utahrobotics/Electrical-2019-2020/Electrical layout/Teensy_4.0/Renders/Teensy_4.0_wBG.png

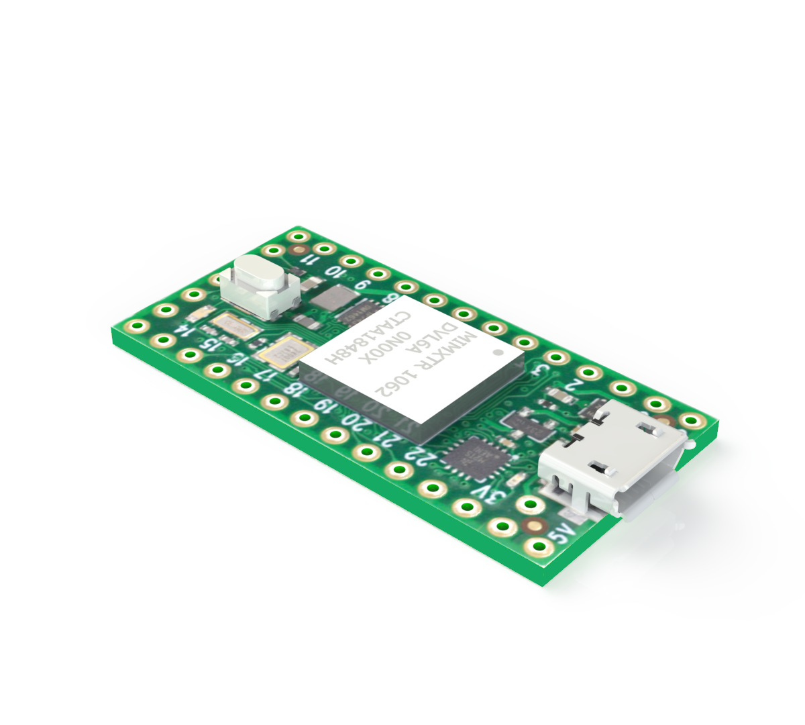
Electrical layout/Teensy_4.0/Renders/Teensy_4.0_wBG.png
