utahrobotics/Electrical-2019-2020/Electrical layout/Teensy_4.0/Teensy_4.0_Decal/Teensy_4.0_Back.png

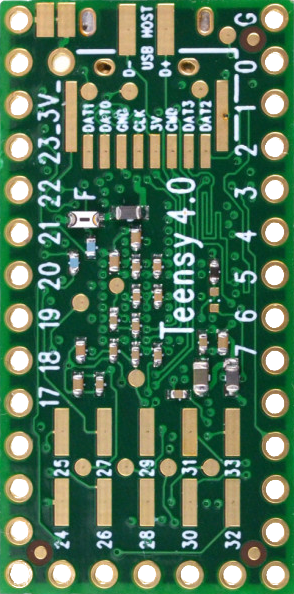
Electrical layout/Teensy_4.0/Teensy_4.0_Decal/Teensy_4.0_Back.png
