utahrobotics/Electrical-2019-2020/Electrical layout/PCBasembly.bmp

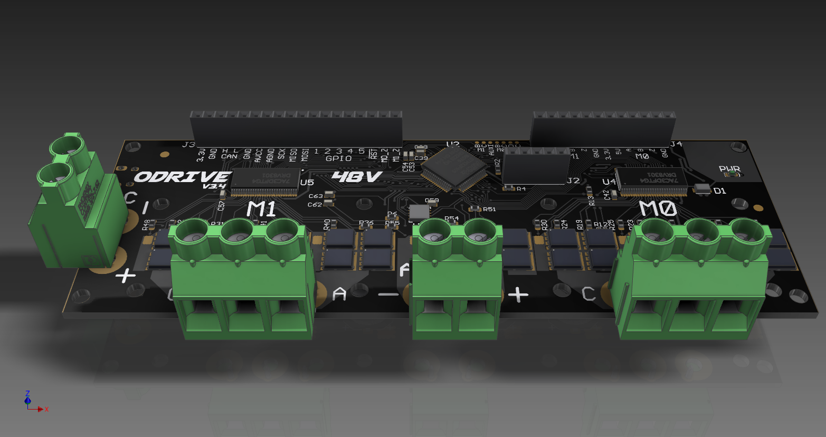
Electrical layout/PCBasembly.bmp
