utahrobotics/Electrical-2019-2020/Electrical layout/PCBasemblyB.bmp

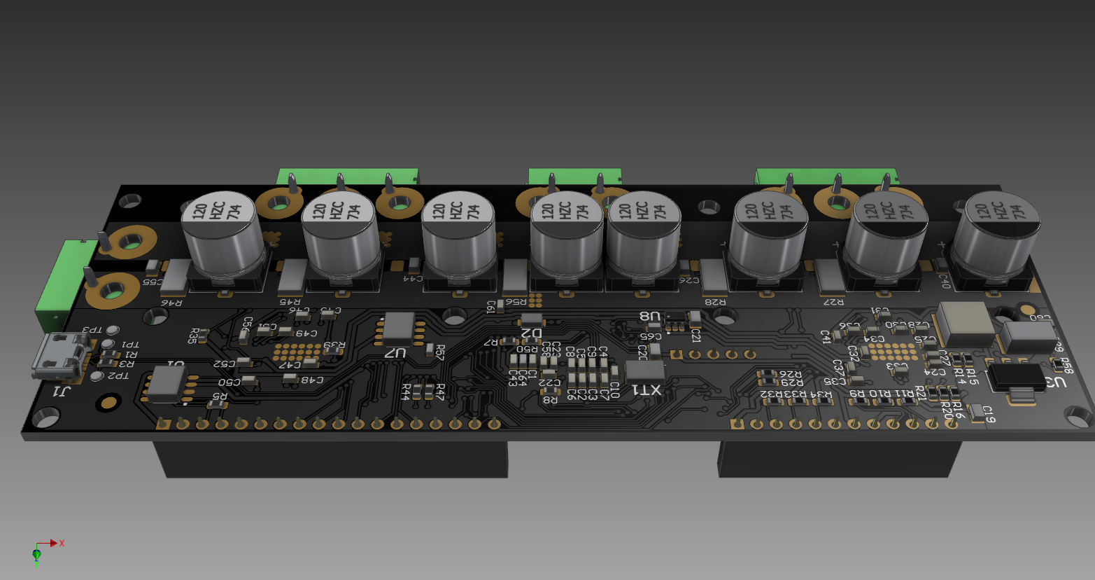
Electrical layout/PCBasemblyB.bmp
