utahrobotics/Electrical-2019-2020/Electrical layout/Teensy_4.0/Teensy_4.0_Decal/ARM_Coretex M7 Chip Decal.png

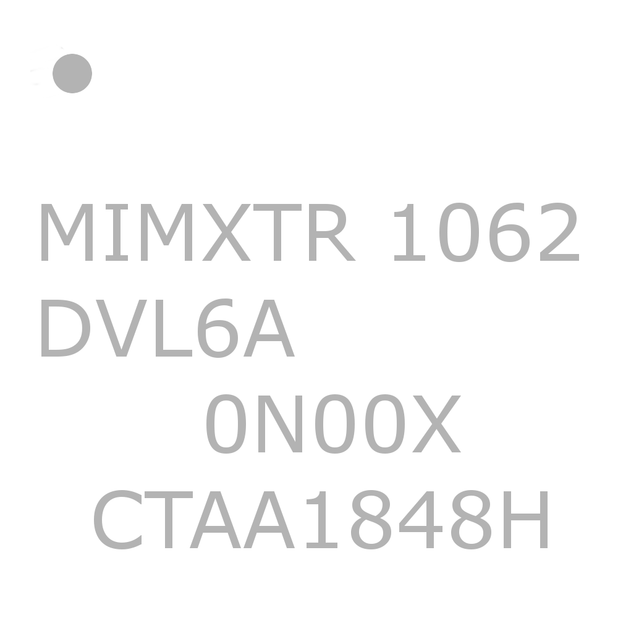
Electrical layout/Teensy_4.0/Teensy_4.0_Decal/ARM_Coretex M7 Chip Decal.png
