utahrobotics/Electrical-2019-2020/Electrical layout/Teensy_4.0/Teensy_4.0_Decal/teensy40-launch-frontandback-thumb.jpg

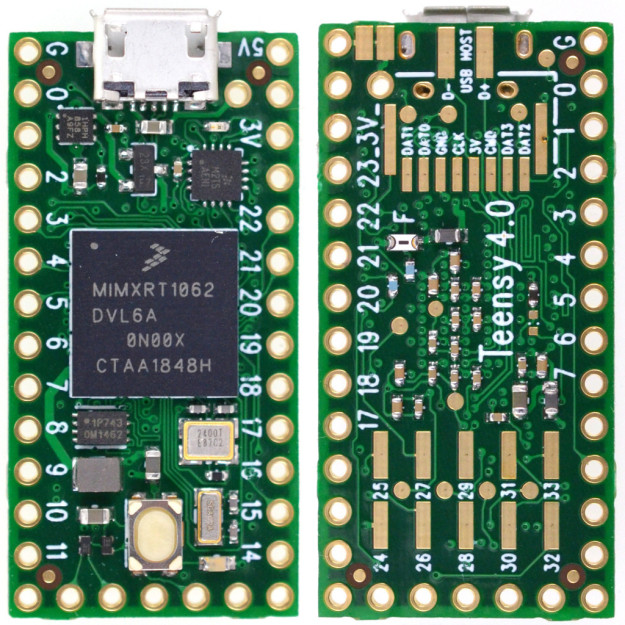
Electrical layout/Teensy_4.0/Teensy_4.0_Decal/teensy40-launch-frontandback-thumb.jpg
