utahrobotics/Electrical-2019-2020/Electrical layout/XT90 Connector/XT90 Connector v2.png

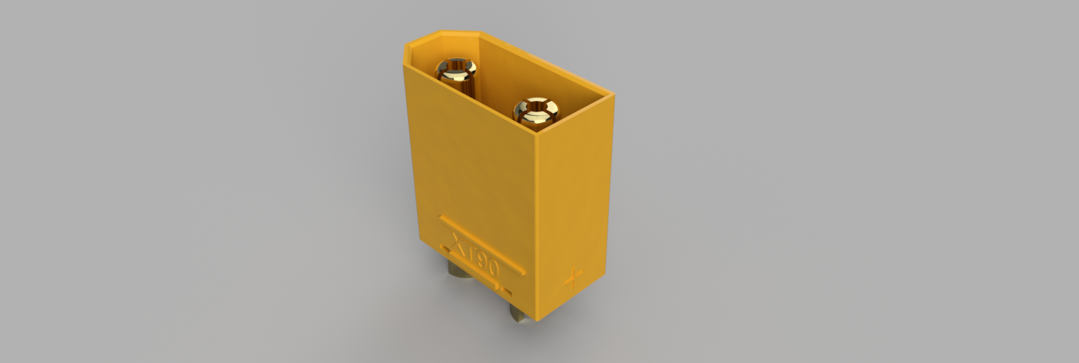
Electrical layout/XT90 Connector/XT90 Connector v2.png
