utahrobotics/Electrical-2019-2020/Electrical layout/XT90 Connector/XT90 Connector v5.png

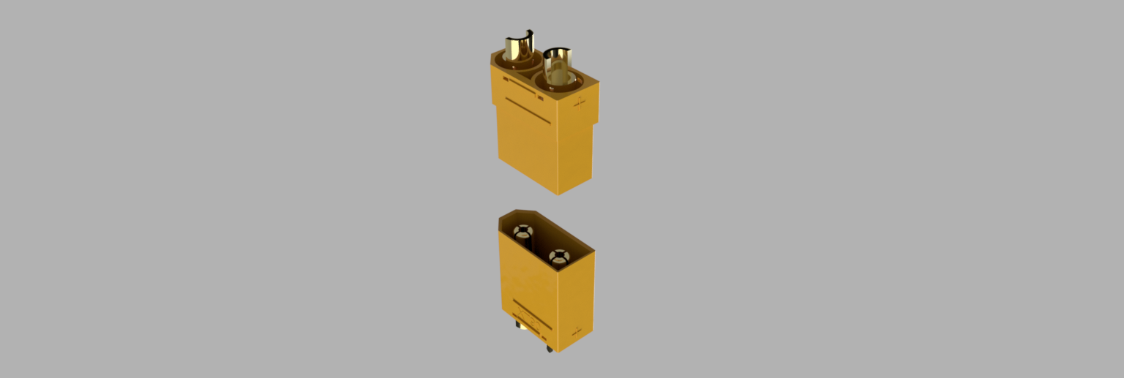
Electrical layout/XT90 Connector/XT90 Connector v5.png
