utahrobotics/Electrical-2019-2020/Electrical layout/xt90_female-2.jpg

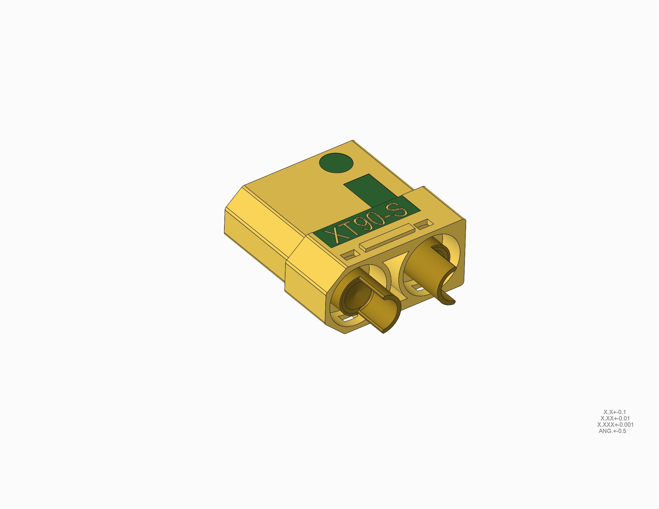
Electrical layout/xt90_female-2.jpg
