utahrobotics/Electrical-2019-2020/Master_capture.png

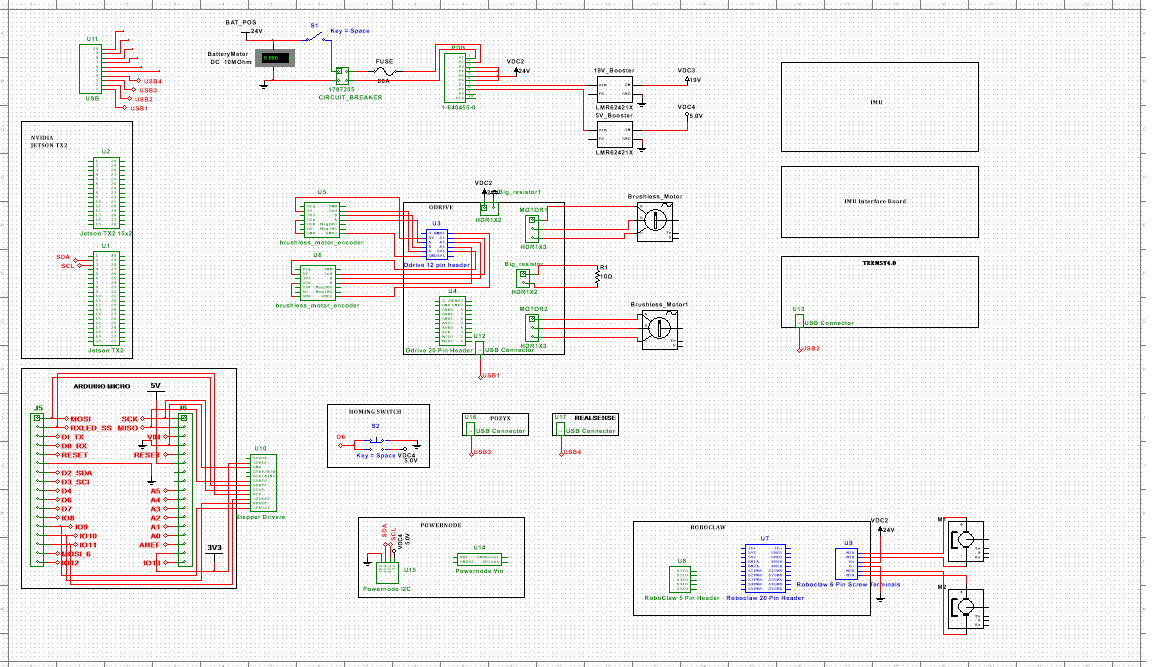
Master_capture.png
