utahrobotics/Electrical-2019-2020/PowerNode/PowerNodeSlave/pinout.png

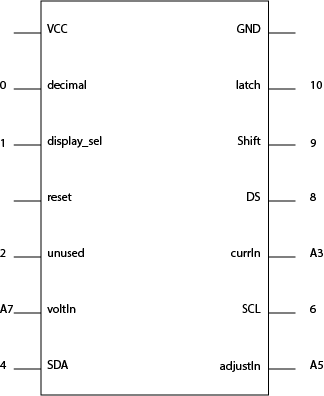
PowerNode/PowerNodeSlave/pinout.png
