utahrobotics/Electrical-2019-2020/Electrical layout/Teensy_4.0/Teensy_4.0_Assembly.STEP

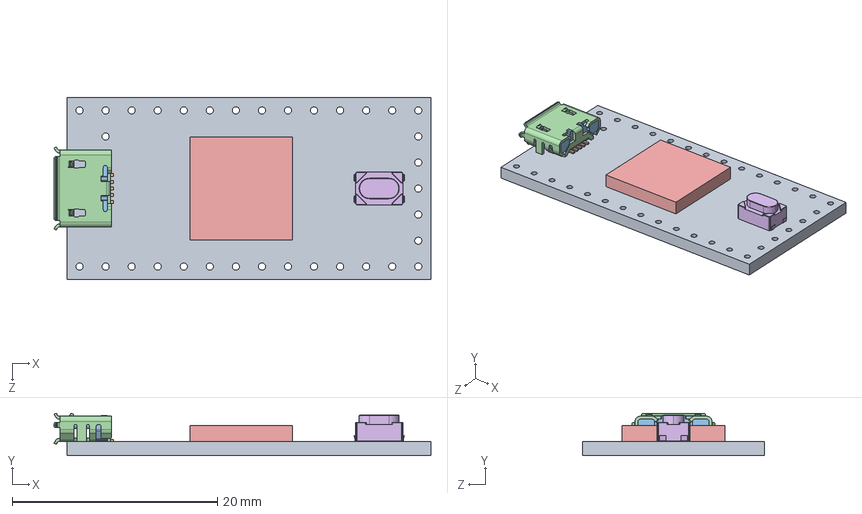
[picture p16: CAD file, 2020-01-18]
Electrical layout/Teensy_4.0/Teensy_4.0_Assembly.STEP
36.8 x 4.12 x 17.7 mm
Teensy_4.0_PCB
Micro USB-B Female 5Pin SMD
NXP iMXRT1062
SKRPACE010 v4
