utahrobotics/Electrical-2019-2020/Electrical layout/Yeeco ZK-JVA-12KX.SLDASM

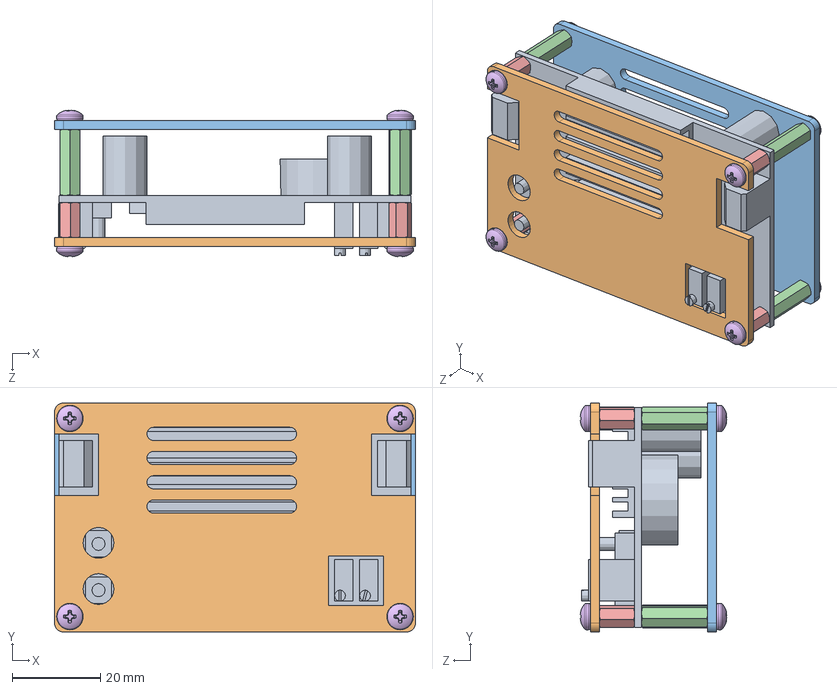
[picture p17: CAD file, 2020-01-21]
Electrical layout/Yeeco ZK-JVA-12KX.SLDASM
82.0 x 52.0 x 33.3 mm
Yeeco ZK-JVA-12KX
Buck Converter Case Upper
Buck Converter Case Lower
94868A722_18-8 SS FEM THRDED HEX STANDOFF x 4
93655A007_MALE-FEMALE THREADED HEX STANDOFF x 4
96741A116_METRIC PAN HEAD PHILLIPS MACHINE SCREW x 8
