utahrobotics/Electrical-2019-2020/Electrical layout/Teensy_4.0/STM32F779NIHx.SLDASM

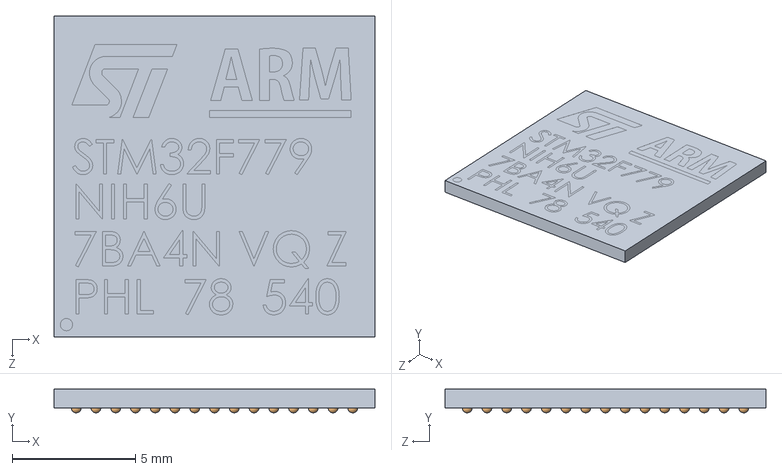
[picture p18: CAD file, 2020-01-18]
Electrical layout/Teensy_4.0/STM32F779NIHx.SLDASM
13.0 x 0.96 x 13.0 mm
ball x 216
