utahrobotics/Electrical-2019-2020/Electrical layout/xt90_male_asm.stp

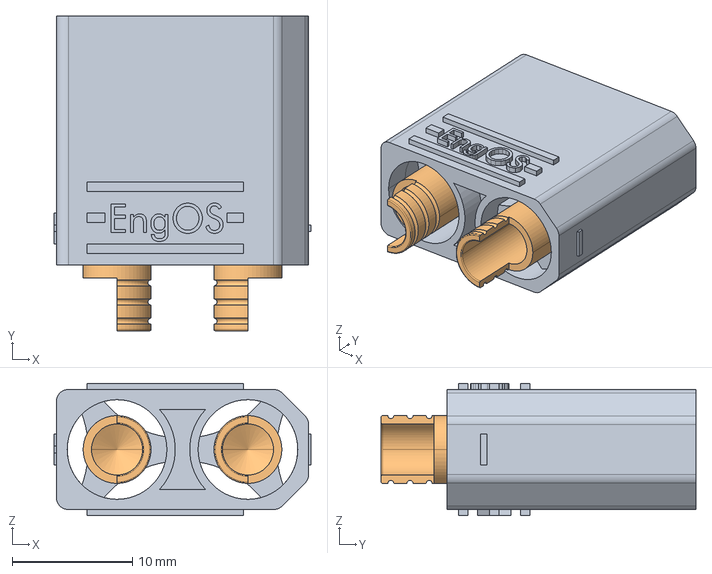
[picture p19: CAD file, 2020-01-21]
Electrical layout/xt90_male_asm.stp
21.4 x 26.2 x 11.0 mm
XT90_MALE
XT90_MALE_PIN x 2
