utahrobotics/Electrical-2019-2020/Electrical layout/simple_layout.SLDASM

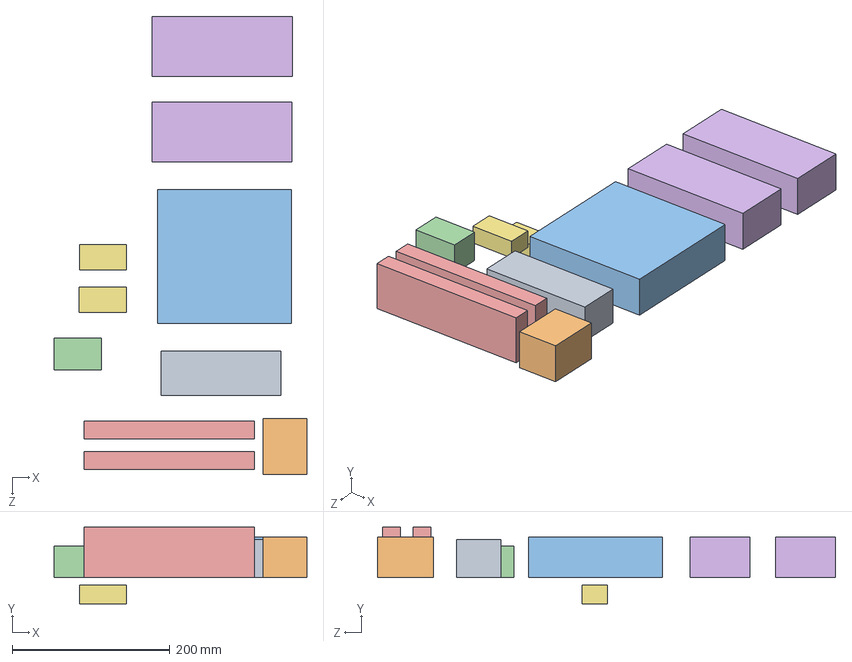
[picture p20: CAD file, 2020-01-16]
Electrical layout/simple_layout.SLDASM
320.7 x 97.1 x 580.9 mm
battery
circuit_breaker
Jetson
kill_switch
pdb_prototype
Odrive_estimate x 2
roboclaw x 2
