utahrobotics/Electrical-2019-2020/Electrical layout/DS1071-1xN (BLS)/DS1071-1x6.STEP

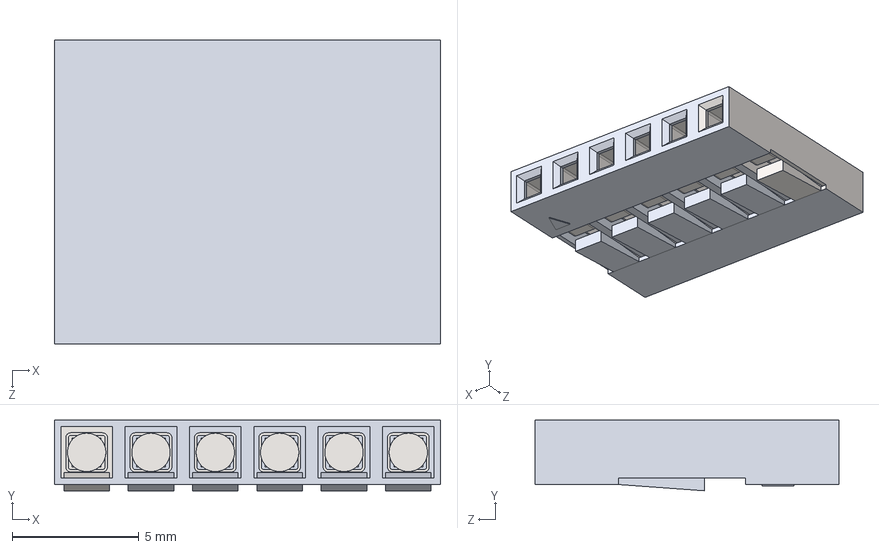
[picture p21: CAD file, 2020-01-21]
Electrical layout/DS1071-1xN (BLS)/DS1071-1x6.STEP
15.2 x 2.79 x 12.0 mm
