utahrobotics/Electrical-2019-2020/Electrical layout/DS1071-2xN (BLD)/DS1071-2x2.STEP

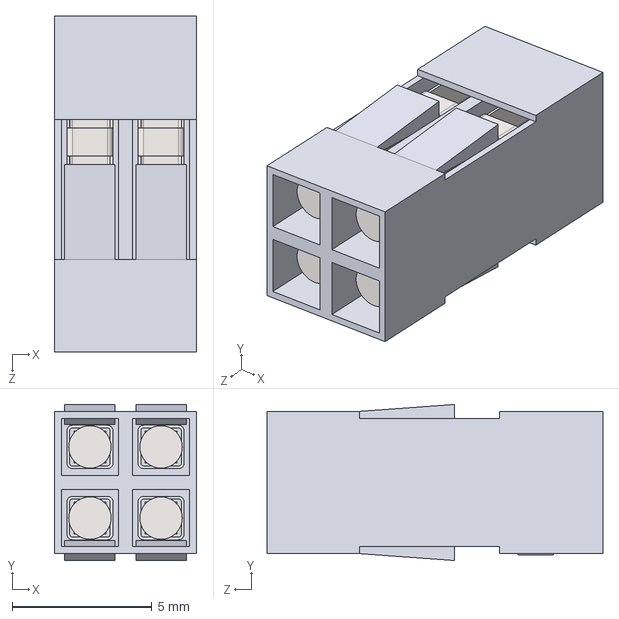
[picture p22: CAD file, 2020-01-21]
Electrical layout/DS1071-2xN (BLD)/DS1071-2x2.STEP
5.08 x 5.57 x 12.0 mm
