utahrobotics/Electrical-2019-2020/Electrical layout/PowerNode2 v1.step

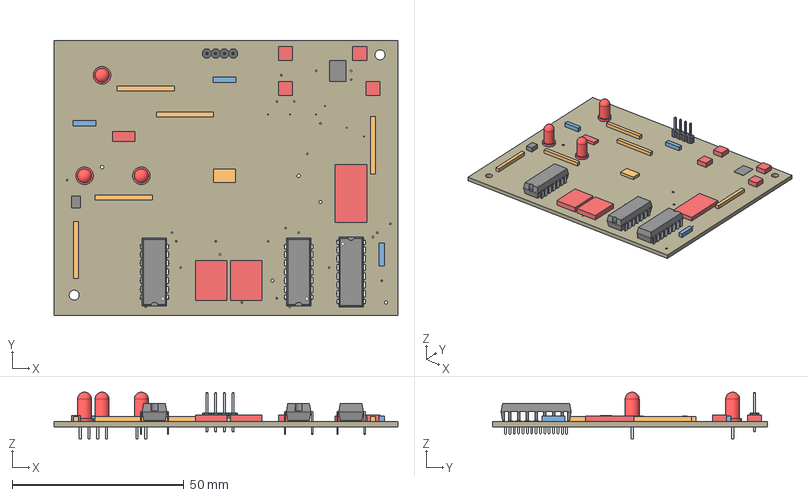
[picture p23: CAD file, 2020-01-21]
Electrical layout/PowerNode2 v1.step
100.0 x 80.0 x 13.6 mm
Board
0.1uF x 3
WIREPAD1,6/0,9 x 4
B25P
ATTINY84ATTINY84-20PU
WIREPAD4,16O1,6 x 4
S4301B x 2
74LS49N x 2
ACS712-LC
74LS595N
LED5MM x 3
TL32PO
74AHCT1G04DBV
