utahrobotics/Electrical-2019-2020/Electrical layout/Teensy_4.0/Micro USB-B Female 5Pin SMD.SLDPRT

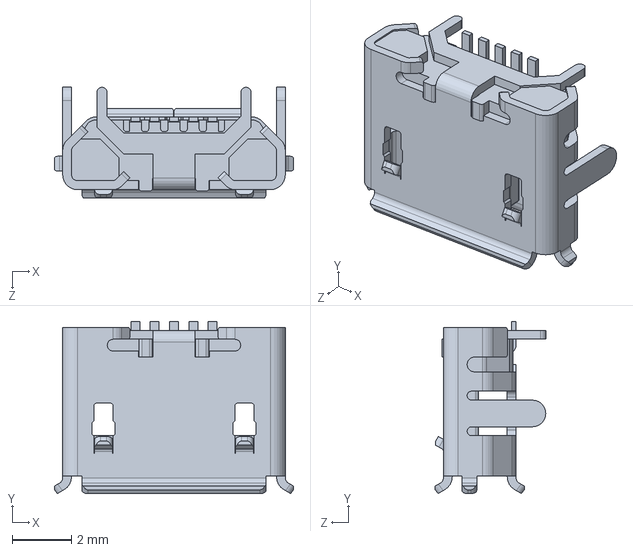
[picture p24: CAD file, 2020-01-18]
Electrical layout/Teensy_4.0/Micro USB-B Female 5Pin SMD.SLDPRT
8.05 x 5.80 x 3.72 mm
