utahrobotics/Electrical-2019-2020/Electrical layout/XT90 Connector/XT90 Connector v5.step

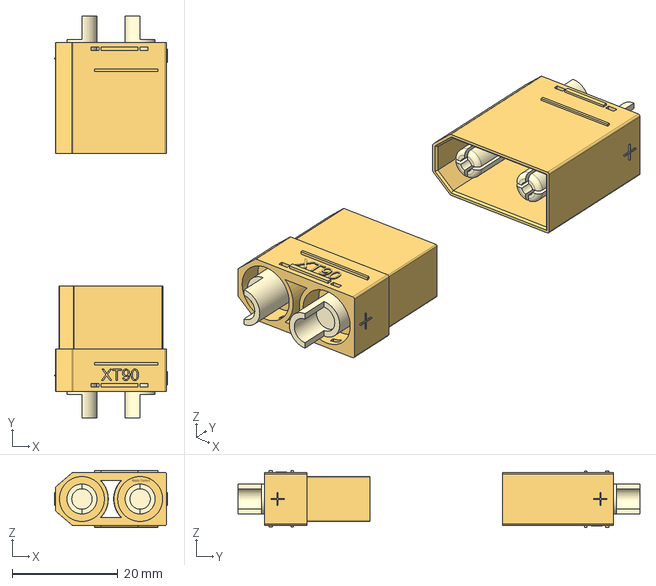
[picture p25: CAD file, 2020-01-21]
Electrical layout/XT90 Connector/XT90 Connector v5.step
21.4 x 76.0 x 10.8 mm
XT90 Male
XT90 Female
