utahrobotics/Electrical-2019-2020/PowerNode/Power Node V3.0/SA39-11.step

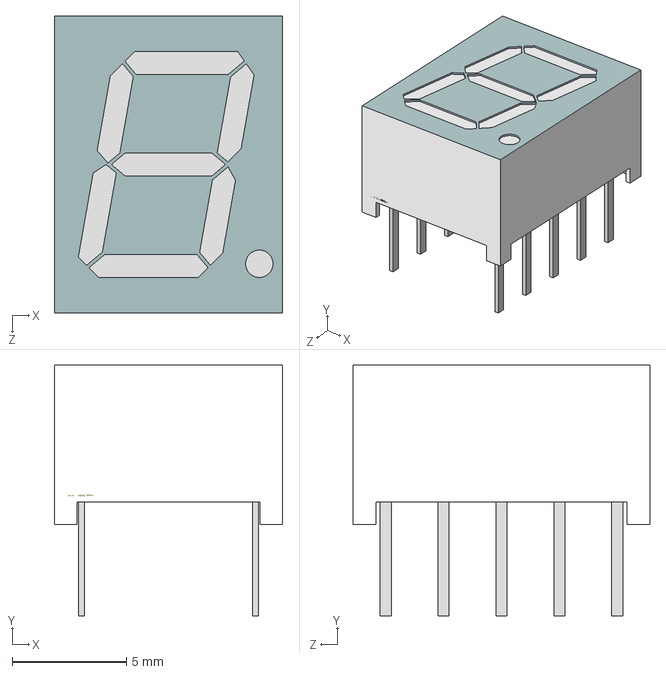
[picture p26: CAD file, 2020-02-28]
PowerNode/Power Node V3.0/SA39-11.step
10.0 x 11.0 x 13.0 mm
