utahrobotics/Electrical-2019-2020/Electrical layout/DS1071-1xN (BLS)/DS1071-1x5.STEP

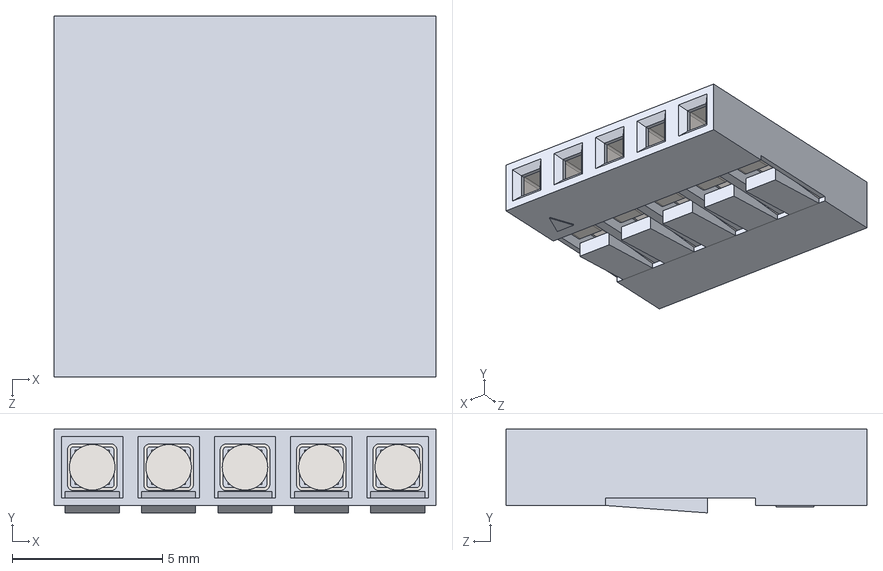
[picture p27: CAD file, 2020-01-21]
Electrical layout/DS1071-1xN (BLS)/DS1071-1x5.STEP
12.7 x 2.79 x 12.0 mm
