utahrobotics/Electrical-2019-2020/Electrical layout/Teensy_4.0/NXP iMXRT1062.SLDPRT

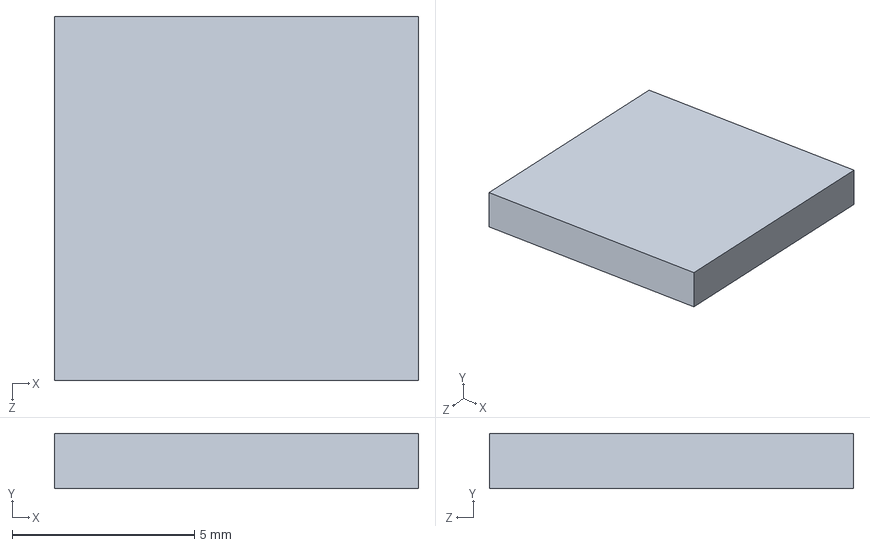
[picture p29: CAD file, 2020-01-18]
Electrical layout/Teensy_4.0/NXP iMXRT1062.SLDPRT
10.0 x 1.52 x 10.0 mm
