utahrobotics/Electrical-2019-2020/Electrical layout/USB_hub.SLDPRT

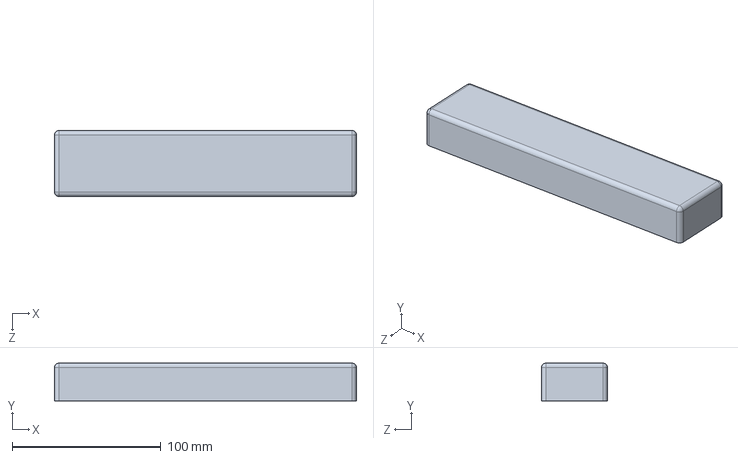
[picture p30: CAD file, 2020-01-21]
Electrical layout/USB_hub.SLDPRT
203.2 x 25.4 x 44.5 mm
