utahrobotics/Electrical-2019-2020/PowerNode/Power Node V3.0/Trimpot 3362P.step

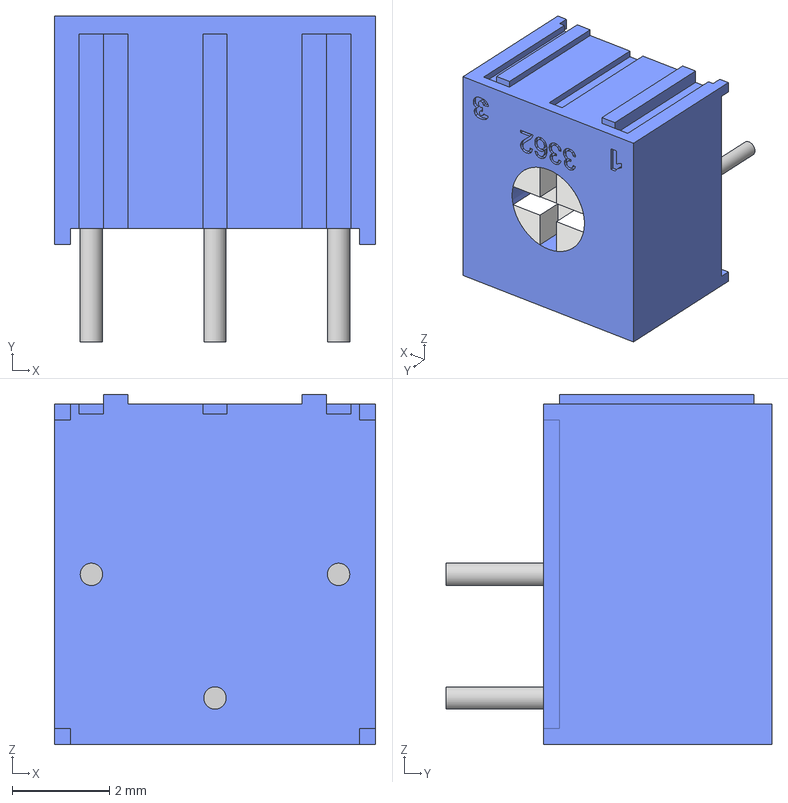
[picture p31: CAD file, 2020-02-28]
PowerNode/Power Node V3.0/Trimpot 3362P.step
6.60 x 6.70 x 7.20 mm
