utahrobotics/Electrical-2019-2020/Electrical layout/DS1071-1xN (BLS)/DS1071-1x4.STEP

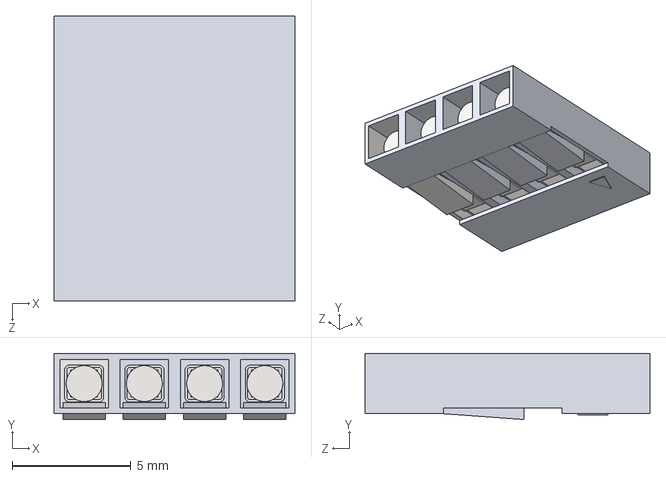
[picture p32: CAD file, 2020-01-21]
Electrical layout/DS1071-1xN (BLS)/DS1071-1x4.STEP
10.2 x 2.79 x 12.0 mm
