utahrobotics/Electrical-2019-2020/Electrical layout/Teensy_4.0/Teensy_4.0_PCB.SLDPRT

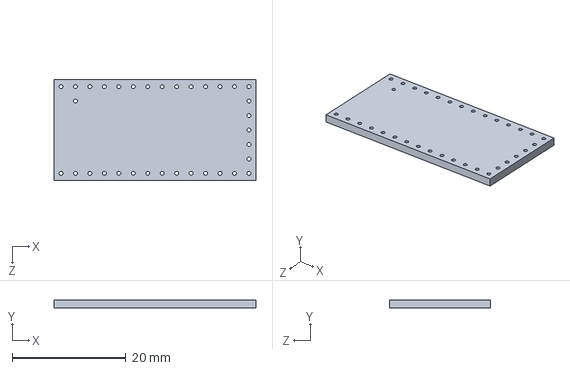
[picture p36: CAD file, 2020-01-18]
Electrical layout/Teensy_4.0/Teensy_4.0_PCB.SLDPRT
35.5 x 1.40 x 17.7 mm
