utahrobotics/Electrical-2019-2020/Electrical layout/UseCF42.SLDPRT

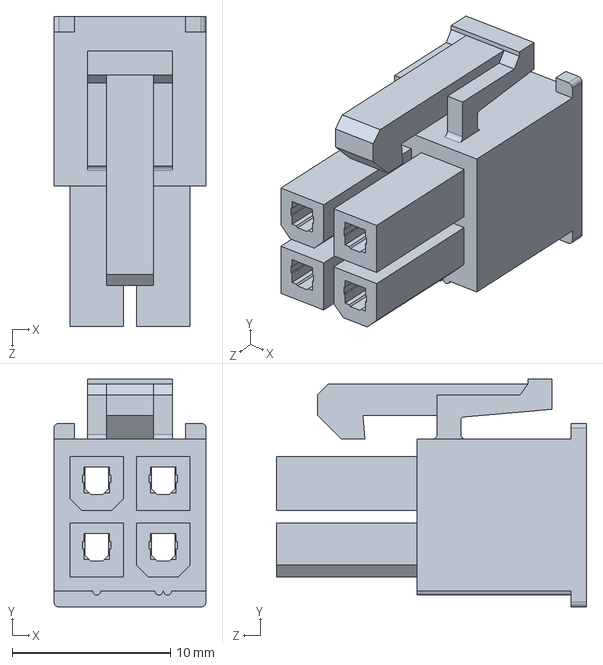
[picture p37: CAD file, 2020-01-21]
Electrical layout/UseCF42.SLDPRT
9.60 x 14.4 x 19.6 mm
