utahrobotics/Electrical-2019-2020/PowerNode/Power Node V3.0/Selector Switch - SK22D07.stp

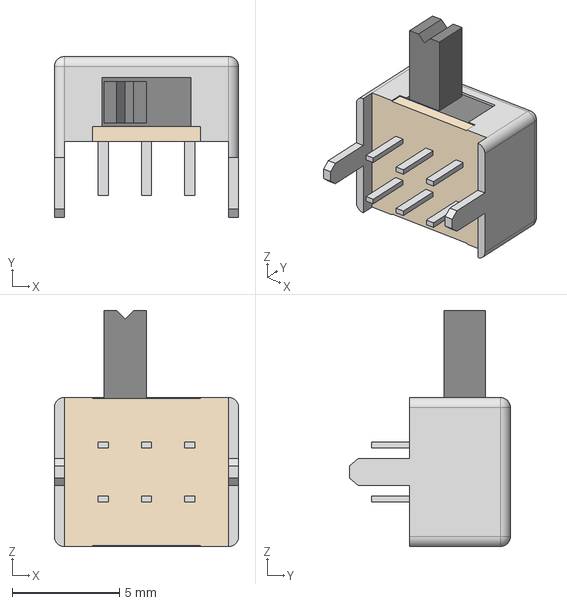
[picture p38: CAD file, 2020-02-28]
PowerNode/Power Node V3.0/Selector Switch - SK22D07.stp
8.61 x 7.52 x 11.0 mm
