utahrobotics/Electrical-2019-2020/Electrical layout/DS1071-2xN (BLD)/DS1071-2x6.STEP

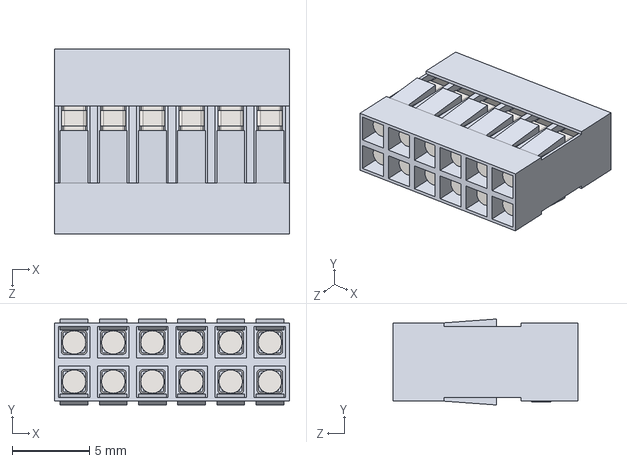
[picture p40: CAD file, 2020-01-21]
Electrical layout/DS1071-2xN (BLD)/DS1071-2x6.STEP
15.2 x 5.57 x 12.0 mm
