utahrobotics/Electrical-2019-2020/Electrical layout/Teensy_4.0/SKRPACE010 v4.SLDPRT

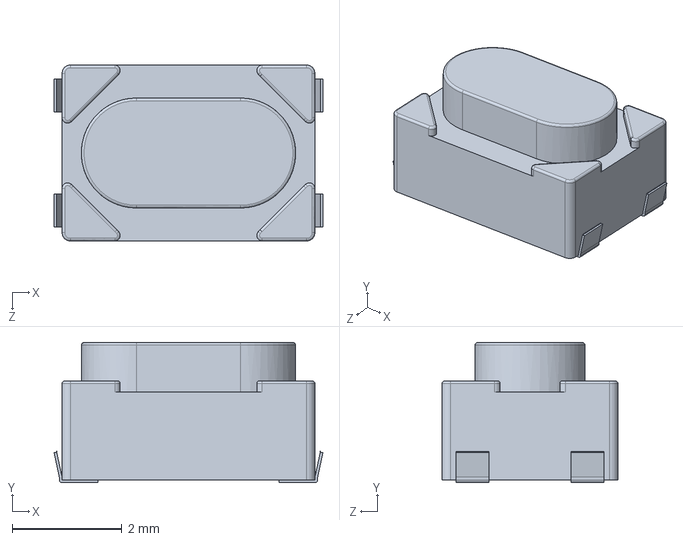
[picture p41: CAD file, 2020-01-18]
Electrical layout/Teensy_4.0/SKRPACE010 v4.SLDPRT
4.89 x 2.55 x 3.20 mm
