utahrobotics/Electrical-2019-2020/Electrical layout/xt90_female.stp

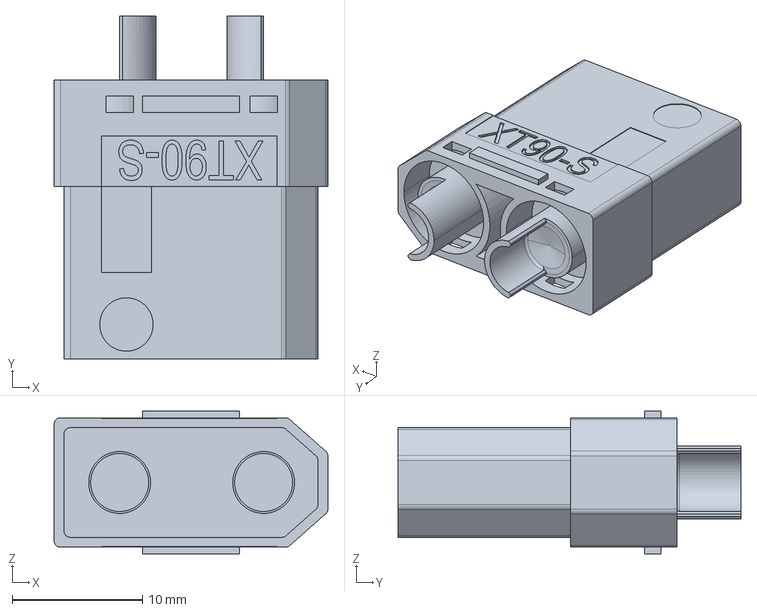
[picture p46: CAD file, 2020-01-21]
Electrical layout/xt90_female.stp
21.0 x 26.3 x 10.9 mm
