utahrobotics/Electrical-2019-2020/Electrical layout/DS1071-1xN (BLS)/DS1071-1x7.STEP

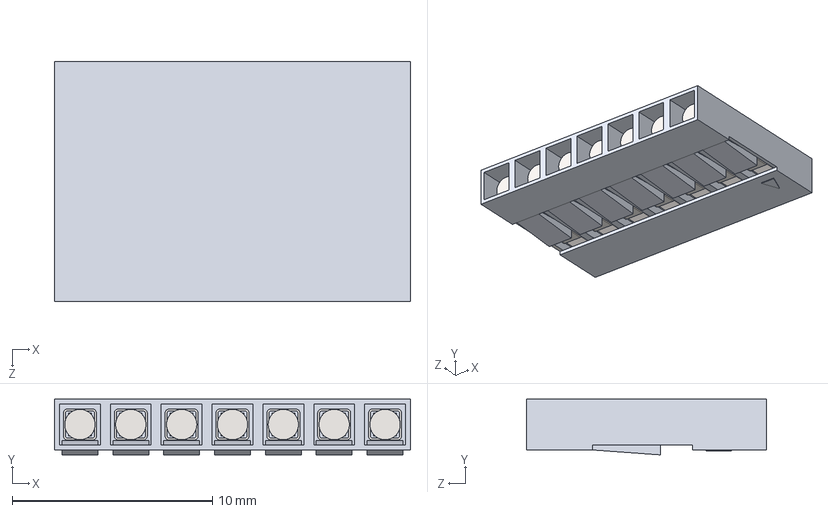
[picture p47: CAD file, 2020-01-21]
Electrical layout/DS1071-1xN (BLS)/DS1071-1x7.STEP
17.8 x 2.79 x 12.0 mm
