utahrobotics/Electrical-2019-2020/Electrical layout/Part69.SLDPRT

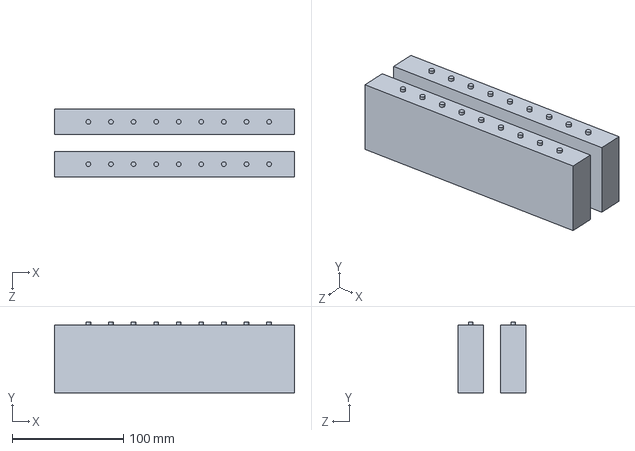
[picture p48: CAD file, 2020-01-21]
Electrical layout/Part69.SLDPRT
215.9 x 63.5 x 61.0 mm
