utahrobotics/Electrical-2019-2020/Electrical layout/5V _buck_booster.SLDPRT

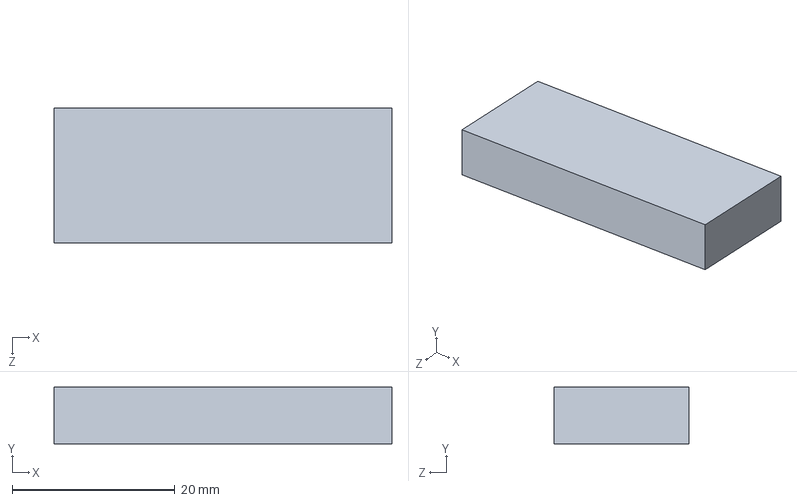
[picture p51: CAD file, 2020-01-21]
Electrical layout/5V _buck_booster.SLDPRT
41.6 x 7.00 x 16.6 mm
