utahrobotics/Electrical-2019-2020/Electrical layout/DS1071-1xN (BLS)/DS1071-1x9.STEP

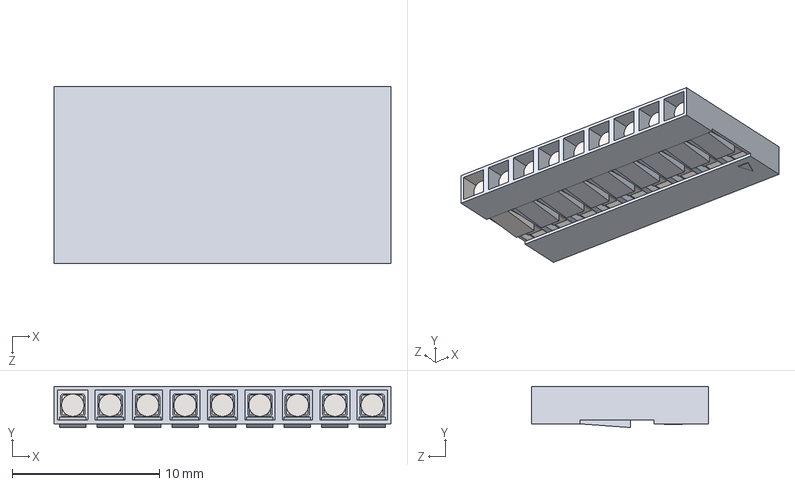
[picture p54: CAD file, 2020-01-21]
Electrical layout/DS1071-1xN (BLS)/DS1071-1x9.STEP
22.9 x 2.79 x 12.0 mm
