utahrobotics/Electrical-2019-2020/Electrical layout/DS1071-1xN (BLS)/DS1071-1x13.STEP

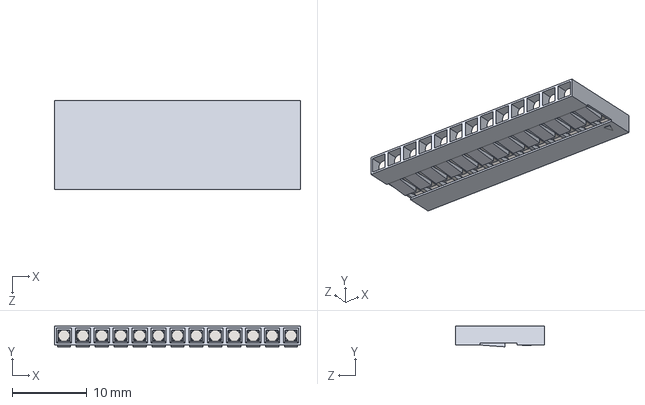
[picture p55: CAD file, 2020-01-21]
Electrical layout/DS1071-1xN (BLS)/DS1071-1x13.STEP
33.0 x 2.79 x 12.0 mm
