utahrobotics/Electrical-2019-2020/Electrical layout/DS1071-1xN (BLS)/DS1071-1x8.STEP

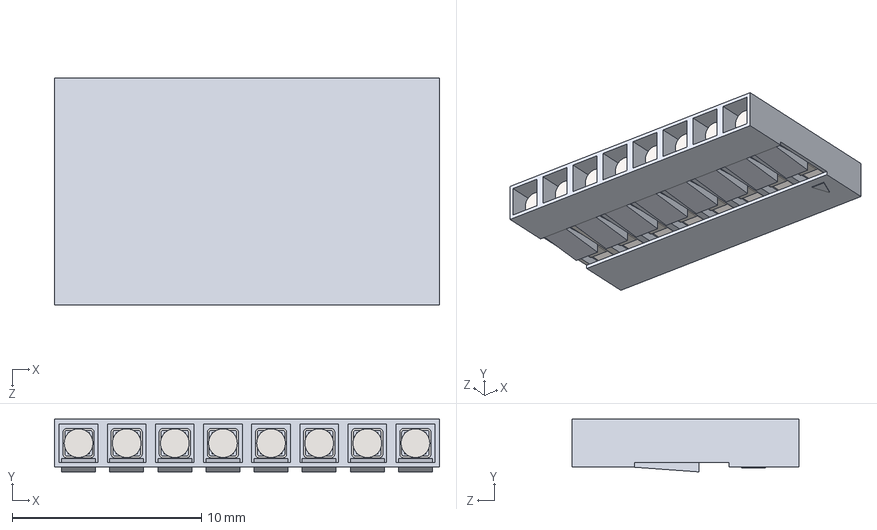
[picture p56: CAD file, 2020-01-21]
Electrical layout/DS1071-1xN (BLS)/DS1071-1x8.STEP
20.3 x 2.79 x 12.0 mm
