utahrobotics/Electrical-2019-2020/Electrical layout/Buck Converter Case Upper.SLDPRT

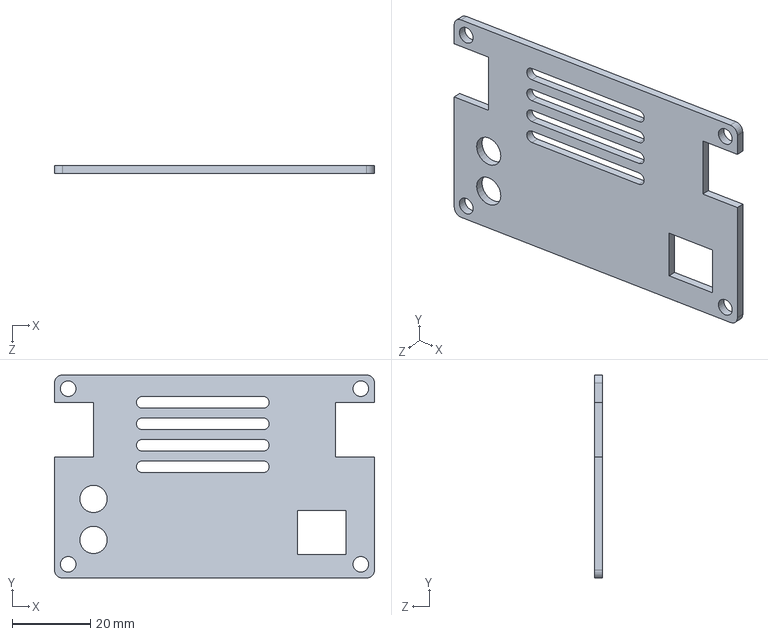
[picture p57: CAD file, 2020-01-21]
Electrical layout/Buck Converter Case Upper.SLDPRT
82.0 x 52.0 x 2.00 mm
