utahrobotics/Electrical-2019-2020/Electrical layout/xt90_male.igs

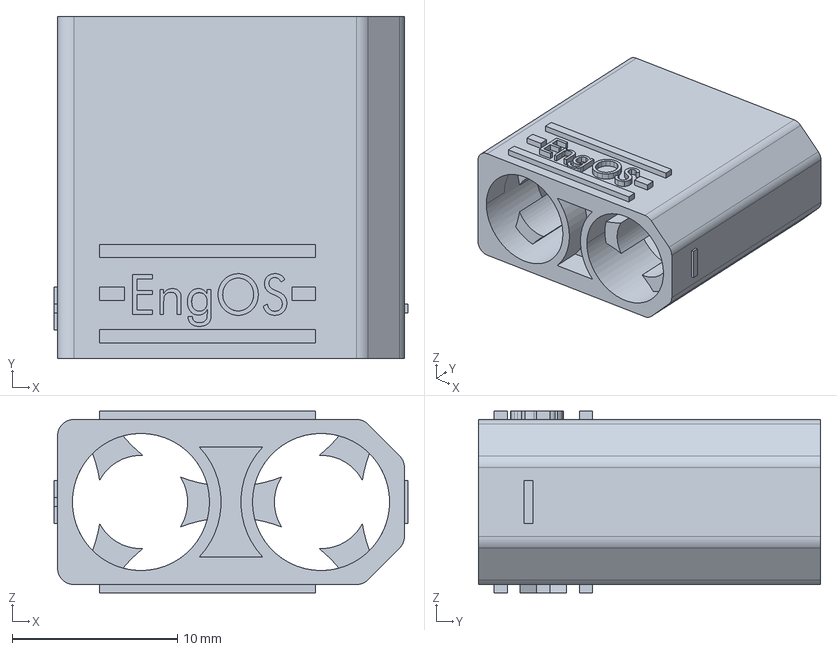
[picture p59: CAD file, 2020-01-21]
Electrical layout/xt90_male.igs
21.4 x 20.7 x 11.0 mm
