utahrobotics/Electrical-2019-2020/Electrical layout/pdb_prototype.SLDPRT

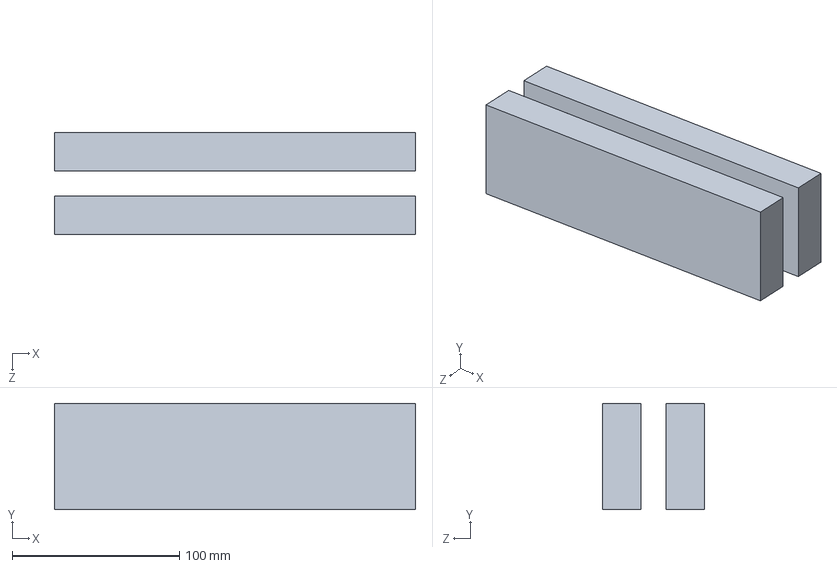
[picture p60: CAD file, 2020-01-21]
Electrical layout/pdb_prototype.SLDPRT
215.9 x 63.5 x 61.0 mm
