utahrobotics/Electrical-2019-2020/Electrical layout/xt90_male_pin.igs

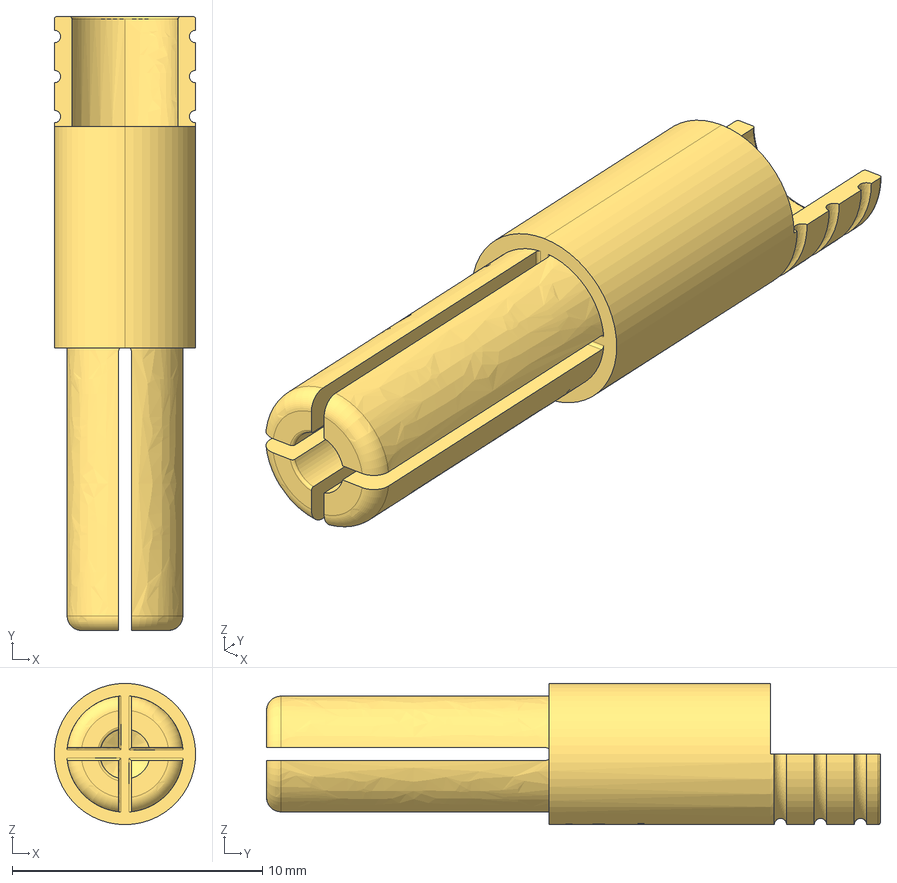
[picture p61: CAD file, 2020-01-21]
Electrical layout/xt90_male_pin.igs
5.65 x 24.6 x 5.65 mm
