utahrobotics/Electrical-2019-2020/Electrical layout/053-0183R.STEP.SLDPRT

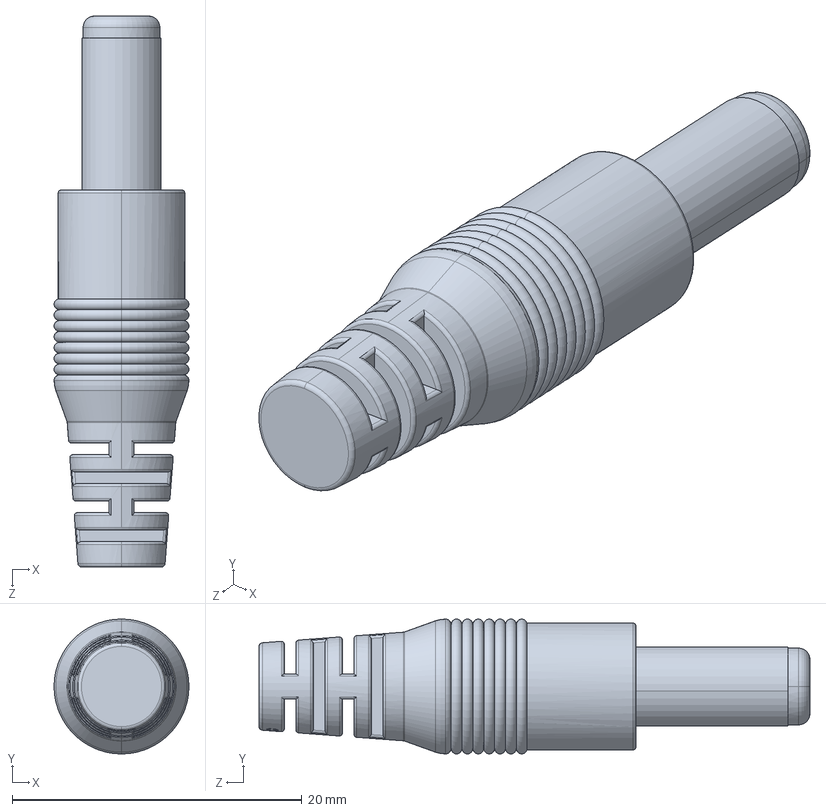
[picture p62: CAD file, 2020-01-21]
Electrical layout/053-0183R.STEP.SLDPRT
9.30 x 9.30 x 38.0 mm
