utahrobotics/Electrical-2019-2020/Electrical layout/IMU.SLDPRT

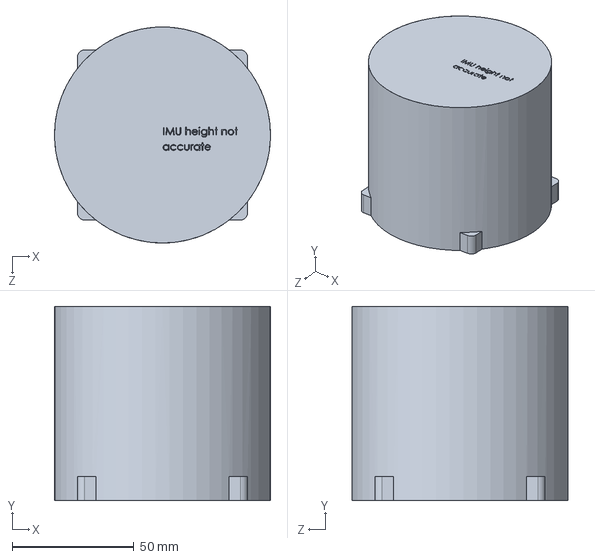
[picture p63: CAD file, 2020-01-21]
Electrical layout/IMU.SLDPRT
88.9 x 80.0 x 88.9 mm
