utahrobotics/Electrical-2019-2020/Electrical layout/Buck Converter Case Lower.SLDPRT

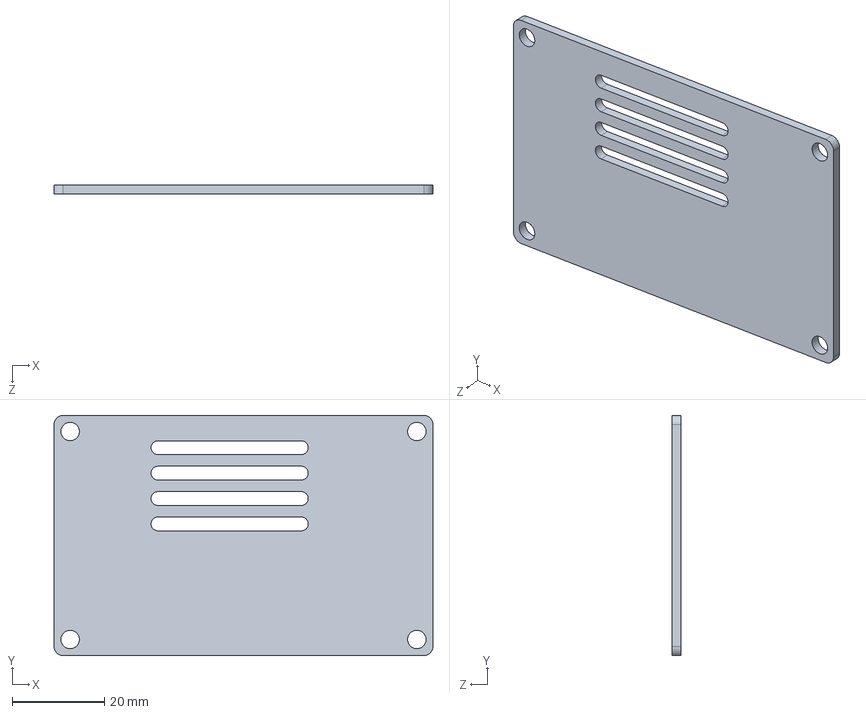
[picture p64: CAD file, 2020-01-21]
Electrical layout/Buck Converter Case Lower.SLDPRT
82.0 x 52.0 x 2.00 mm
