utahrobotics/Electrical-2019-2020/Electrical layout/audio adapter.SLDPRT

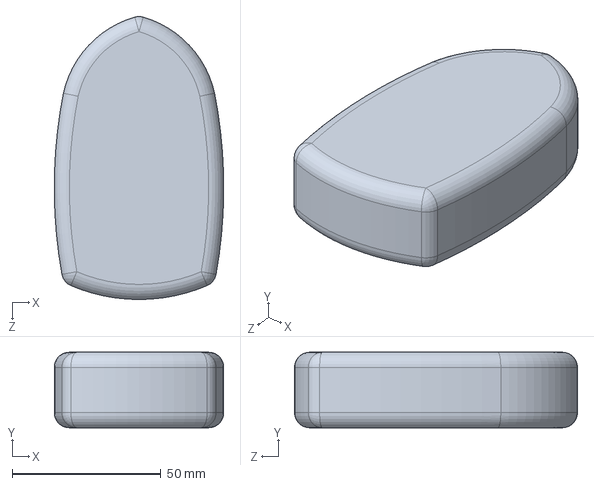
[picture p65: CAD file, 2020-01-18]
Electrical layout/audio adapter.SLDPRT
56.9 x 25.4 x 95.1 mm
