utahrobotics/Electrical-2019-2020/Electrical layout/roboclaw.SLDPRT

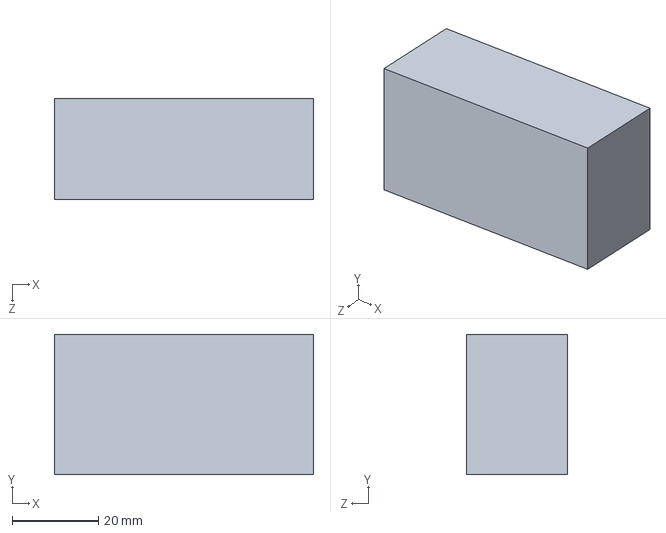
[picture p66: CAD file, 2020-01-16]
Electrical layout/roboclaw.SLDPRT
60.0 x 32.5 x 23.5 mm
