utahrobotics/Electrical-2019-2020/Electrical layout/Jetson.SLDPRT

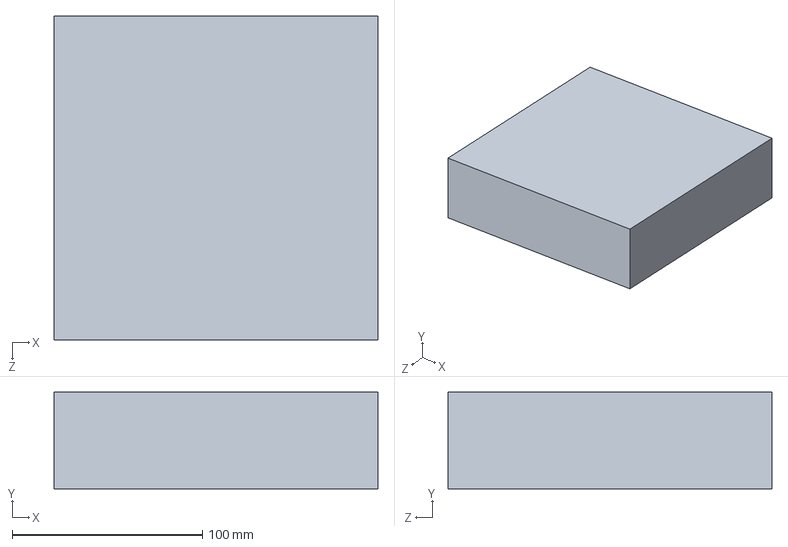
[picture p67: CAD file, 2020-01-16]
Electrical layout/Jetson.SLDPRT
170.2 x 50.8 x 170.2 mm
