utahrobotics/Electrical-2019-2020/Electrical layout/circuit_breaker.SLDPRT

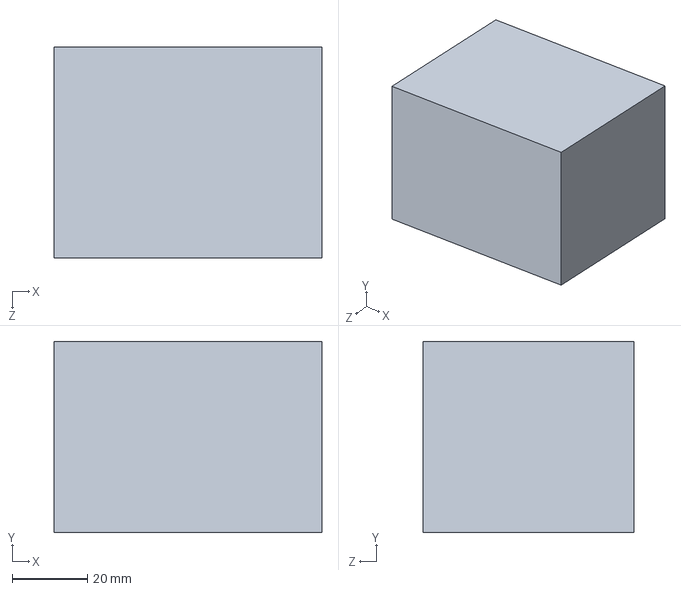
[picture p68: CAD file, 2020-01-16]
Electrical layout/circuit_breaker.SLDPRT
71.1 x 50.8 x 55.9 mm
