utahrobotics/Electrical-2019-2020/Electrical layout/power_distribution.SLDPRT

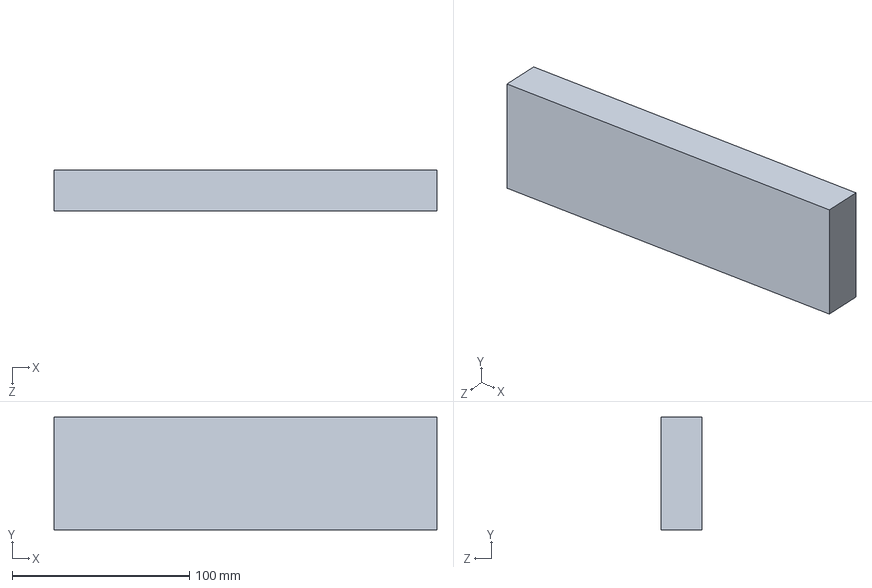
[picture p69: CAD file, 2020-01-16]
Electrical layout/power_distribution.SLDPRT
215.9 x 63.5 x 22.9 mm
