utahrobotics/Electrical-2019-2020/Electrical layout/Odrive_estimate.SLDPRT

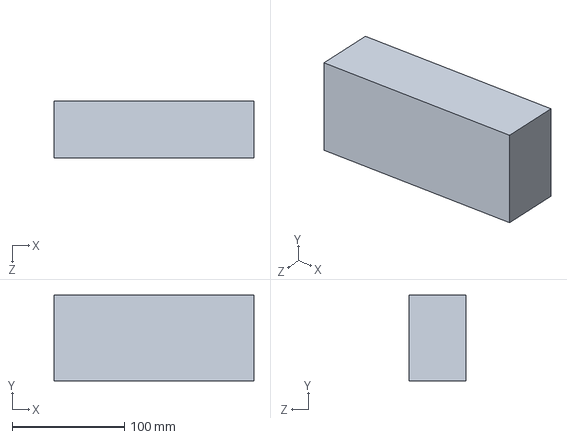
[picture p70: CAD file, 2020-01-16]
Electrical layout/Odrive_estimate.SLDPRT
177.8 x 76.2 x 50.8 mm
