utahrobotics/Electrical-2019-2020/Electrical layout/electronics_plate.SLDPRT

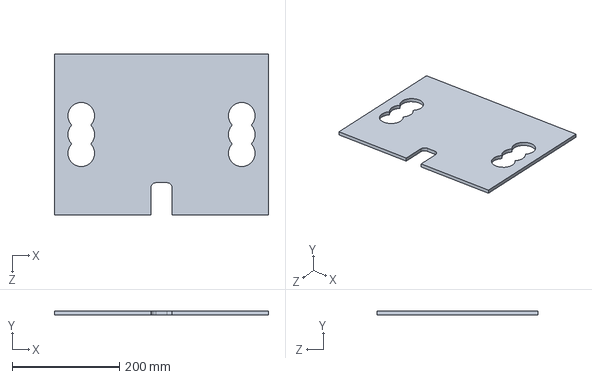
[picture p71: CAD file, 2020-01-16]
Electrical layout/electronics_plate.SLDPRT
400.0 x 7.62 x 300.0 mm
