utahrobotics/Electrical-2019-2020/Electrical layout/kill_switch.SLDPRT

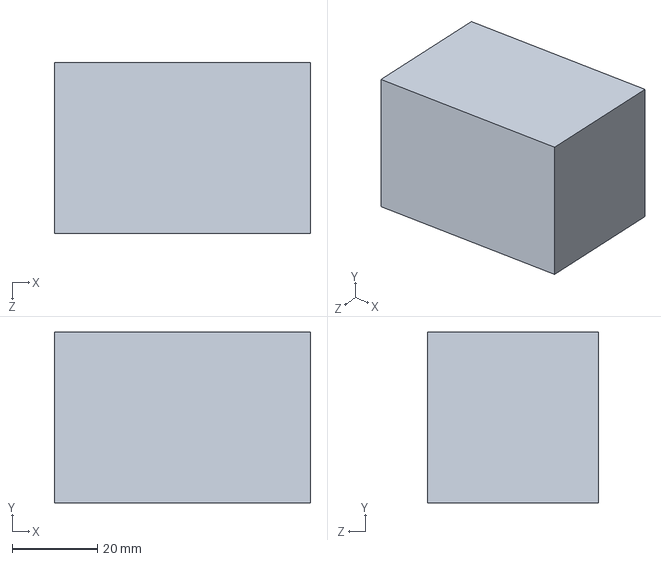
[picture p72: CAD file, 2020-01-16]
Electrical layout/kill_switch.SLDPRT
60.0 x 40.0 x 40.0 mm
