utahrobotics/Electrical-2019-2020/(list of files, cad)

Other CAD files:
Electrical layout/Harness_5-electrical_layout.sldasm
Electrical layout/Harness_1-electrical_layout.sldasm
Electrical layout/Harness_3-electrical_layout.sldasm
Electrical layout/Assem180.SLDASM
Electrical layout/93655A007_MALE-FEMALE THREADED HEX STANDOFF.SLDPRT
Electrical layout/94868A722_18-8 SS FEM THRDED HEX STANDOFF.SLDPRT
Electrical layout/96741A116_METRIC PAN HEAD PHILLIPS MACHINE SCREW.SLDPRT
Electrical layout/Teensy_4.0/Teensy_4.0_Assembly.SLDASM
Electrical layout/XT90 Connector/XT90 Connector v5.SLDASM
Electrical layout/XT90 Connector/XT90 Connector v5.f3d
Electrical layout/Yeeco ZK-JVA-12KX.SLDPRT
Electrical layout/xt90_male_asm.igs
PowerNode/Power Node V3.0/1825232-1 v7.step
PowerNode/Power Node V3.0/Screw Terminal Block 5mm 4-way.step
