utahrobotics/Electrical-2019-2020/Electrical layout/DCDC-NUC 6-48V automotiove power supply for NUC/DCDC-NUC 6-48V automotiove power supply for NUC.PDF

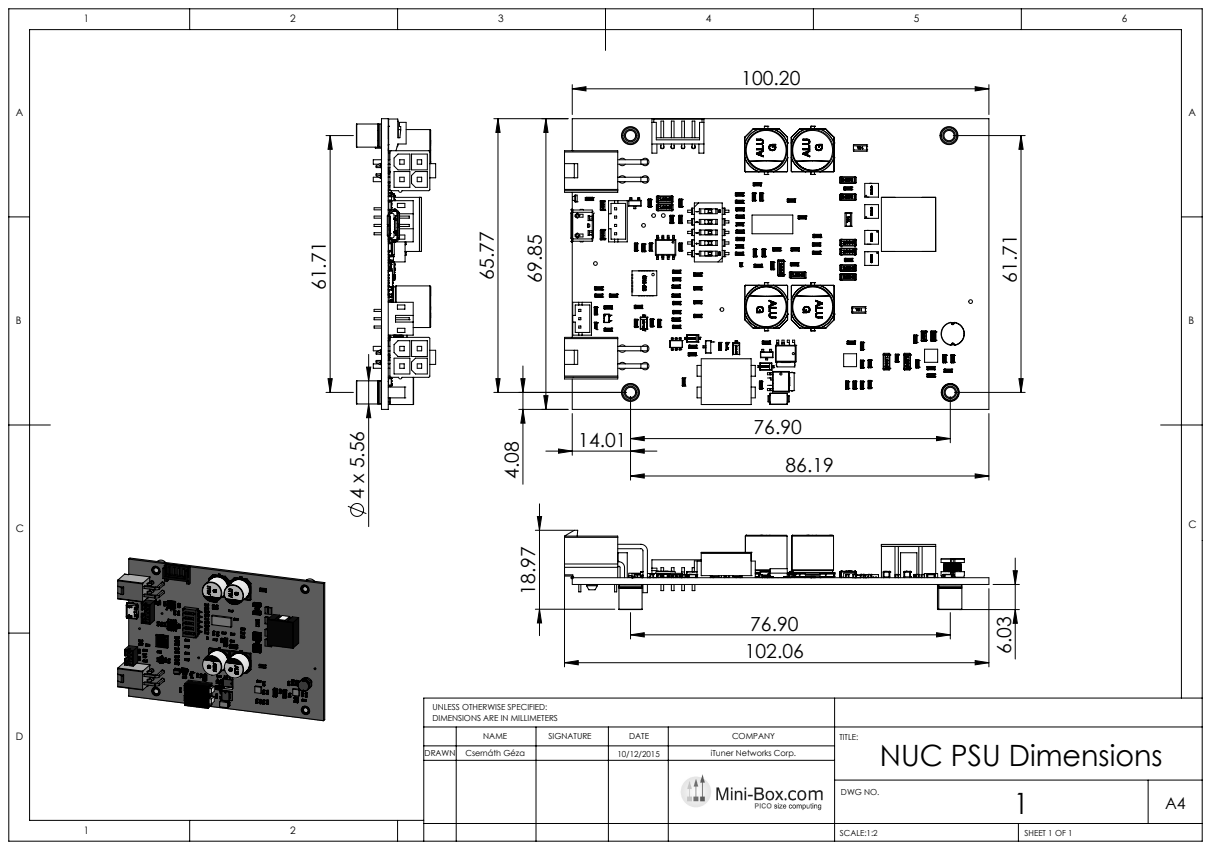
[picture p73: page 1]
SCALE:1:2; SHEET 1 OF 1; DWG NO.

UNLESS OTHERWISE SPECIFIED: DIMENSIONS ARE IN MILLIMETERS

NAME | SIGNATURE | DATE | COMPANY | TITLE:

DRAWN | | | 10/12/2015 | iTuner Networks Corp. | NUC PSU Dimensions Csernáth Géza
