utahrobotics/Electrical-2019-2020/PowerNode/Power Node V3.0/PowerNode2.kicad_pcb

## KiCad design PowerNode/Power Node V3.0/PowerNode2.kicad_pcb (2020-02-28)

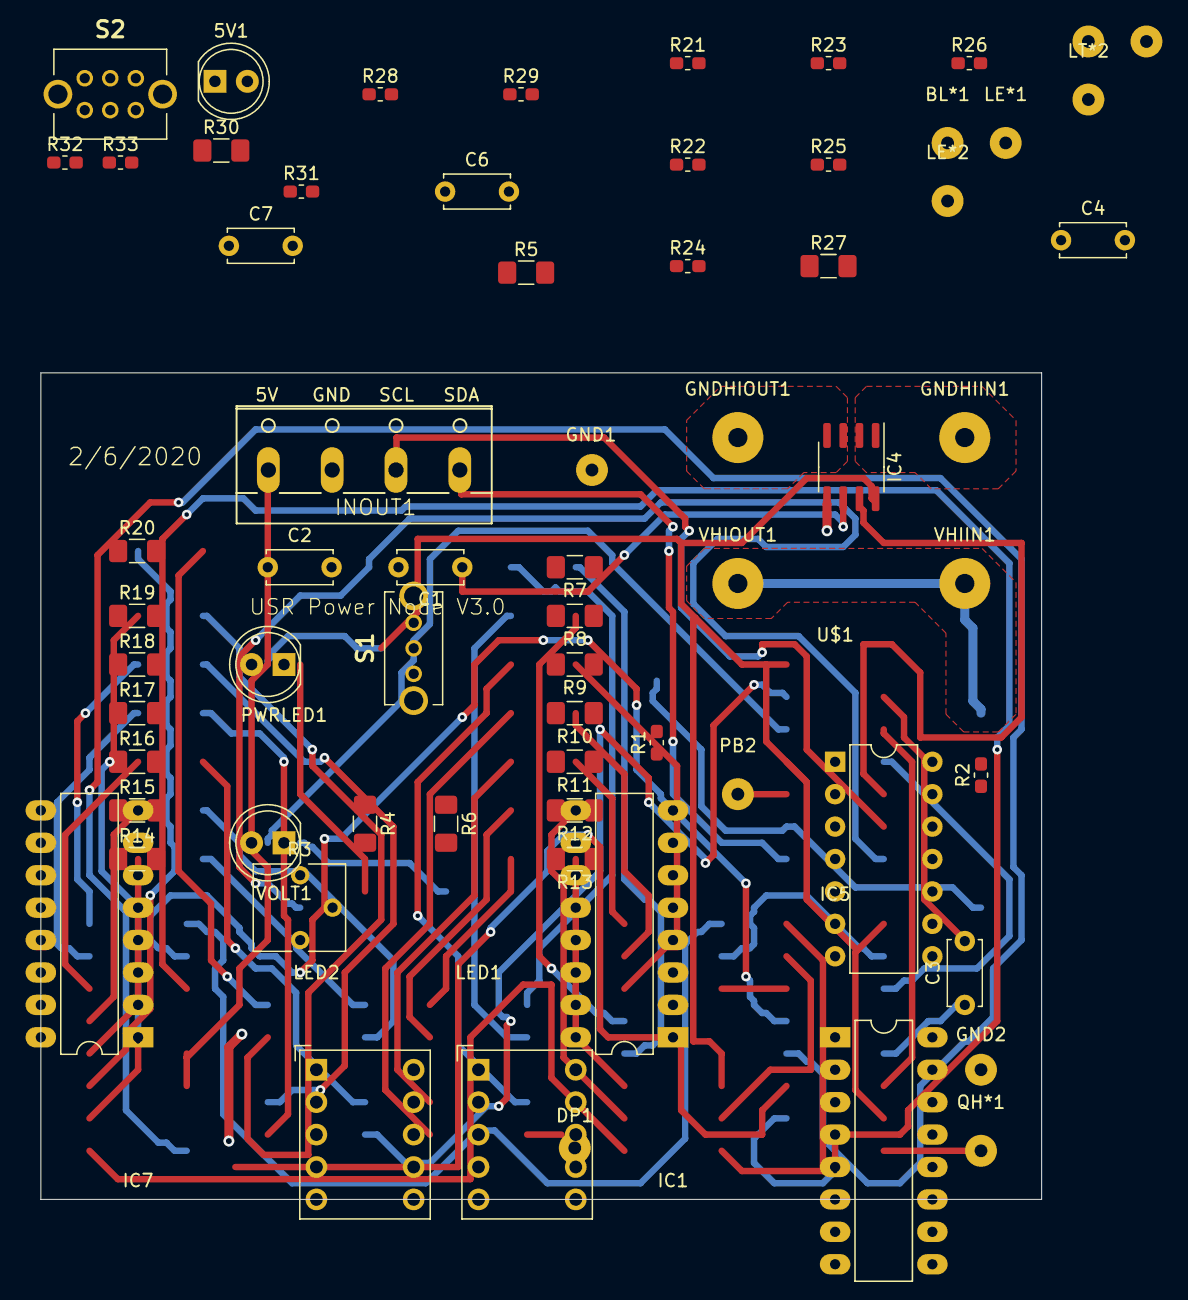
[picture p74: board PowerNode2.kicad_pcb from above]

Board: 2 copper layers, 78.4 x 64.8 mm, 67 parts (0 on the bottom side), 71 nets.

Parts:
5V1: LED5MM; LED_D5.0mm
BL*1, BL*2: 2,54_0,9; SolderWirePad_1x01_Drill1mm
C1: 1nF; C_Disc_D5.0mm_W2.5mm_P5.00mm
C2, C3, C4, C6, C7: 0.1uF; C_Disc_D5.0mm_W2.5mm_P5.00mm
DP1: 2,54_0,9; SolderWirePad_1x01_Drill1mm
GND1, GND2: 2,15_1,0; SolderWirePad_1x01_Drill1mm
GNDHIIN1: WIREPAD4,16O1,6; SolderWirePad_1x01_Drill1.5mm
GNDHIOUT1: WIREPAD4,16O1,6; SolderWirePad_1x01_Drill1.5mm
IC1, IC7: CD4511B; DIP-16_W7.62mm_LongPads
IC4: ACS712xLCTR-30A; SOIC-8_3.9x4.9mm_P1.27mm
IC5: 74HC595N; DIP-16_W7.62mm_LongPads
INOUT1: W237-4
LE*1, LE*2: 2,54_0,9; SolderWirePad_1x01_Drill1mm
LED1, LED2: LTS-4301P; Sx39-1xxxxx
LT*1, LT*2: 2,54_0,9; SolderWirePad_1x01_Drill1mm
PB2: 2,54_0,9; SolderWirePad_1x01_Drill1mm
PWRLED1: LED5MM; LED_D5.0mm
QH*1: 2,54_0,9; SolderWirePad_1x01_Drill1mm
R1, R21, R22, R23, R24, R25, R26, R28, R29, R31, R32, R33: 10k; R_0603_1608Metric_Pad1.05x0.95mm_HandSolder
R2: 43k; R_0603_1608Metric_Pad1.05x0.95mm_HandSolder
R3: TRIM_US-B25P; Potentiometer_Vishay_T73YP_Vertical
R4, R5, R6, R7, R8, R9, R10, R11, R12, R13, R14, R15, R16, R17, R18, R19, R20, R27, R30: 220; R_1206_3216Metric_Pad1.42x1.75mm_HandSolder
S1: SW_SPDT; OS102011MS2Qx1
S2: SW_DPDT_x2; OS202011MS2Qx1
U$1: ATtiny84-20PU; DIP-14_W7.62mm
VHIIN1: WIREPAD4,16O1,6; SolderWirePad_1x01_Drill1.5mm
VHIOUT1: WIREPAD4,16O1,6; SolderWirePad_1x01_Drill1.5mm
VOLT1: LED5MM; LED_D5.0mm

Connections:
/DP1: LED1.6, R27.2, R29.2
/DP2: LED2.6, R5.1
/IMEAS: C6.1, R1.2, U$1.10
/PB2: PB2.1, U$1.5
/SCL: INOUT1.3, U$1.9
/SDA: INOUT1.4, U$1.7
/SWITCH: R31.2, S1.2, VOLT1.2
/VHI: R2.2, S2.4, VHIIN1.1, VHIOUT1.1
/VMEAS: R32.1, R33.1, S2.5
/VMEAS_1: C4.1, R33.2, U$1.6
/VPOT: R3.2, U$1.8
/a1: LED1.10, R7.2
/a2: LED2.10, R14.2
/b1: LED1.9, R8.2
/b2: LED2.9, R15.2
/c1: LED1.7, R9.2
/c2: LED2.7, R16.2
/d1: LED1.5, R10.2
/d2: LED2.5, R17.2
/e1: LED1.4, R11.2
/e2: LED2.4, R18.2
/f1: LED1.2, R12.2
/f2: LED2.2, R19.2
/g1: LED1.1, R13.2
/g2: LED2.1, R20.2
/nBL1: BL*1.1, IC1.4, R22.2
/nBL2: BL*2.1, IC7.4, R24.2
/nLE1: IC1.5, LE*1.1, R25.2
/nLE2: IC7.5, LE*2.1, R26.2
/nLT1: IC1.3, LT*1.1, R21.2
/nLT2: IC7.3, LT*2.1, R23.2
/nQH: IC5.9, QH*1.1, R28.2
unnamed: 5V1.1, R30.2
unnamed: 5V1.2, S2.2
unnamed: C1.1, IC4.6
unnamed: C3.1, IC5.12
unnamed: C3.2, U$1.13
unnamed: C7.1, R31.1, U$1.3
unnamed: DP1.1, R27.1
unnamed: GNDHIOUT1.1, IC4.1, IC4.2
unnamed: IC1.1, IC5.1
unnamed: IC1.2, IC5.2
unnamed: IC1.6, IC5.3
unnamed: IC1.7, IC5.15
unnamed: IC1.9, R11.1
unnamed: IC1.10, R10.1
unnamed: IC1.11, R9.1
unnamed: IC1.12, R8.1
unnamed: IC1.13, R7.1
unnamed: IC1.14, R13.1
unnamed: IC1.15, R12.1
unnamed: IC4.7, R1.1
unnamed: IC5.4, IC7.7
unnamed: IC5.5, IC7.1
unnamed: IC5.6, IC7.2
unnamed: IC5.7, IC7.6
unnamed: IC5.11, U$1.12
unnamed: IC5.14, U$1.11
unnamed: IC7.9, R18.1
unnamed: IC7.10, R17.1
unnamed: IC7.11, R16.1
unnamed: IC7.12, R15.1
unnamed: IC7.13, R14.1
unnamed: IC7.14, R20.1
unnamed: IC7.15, R19.1
unnamed: PWRLED1.1, R4.2
unnamed: R2.1, S2.6
unnamed: R5.2, U$1.2
unnamed: R6.2, VOLT1.1
Vdd: C2.1, IC1.16, IC4.8, IC5.10, IC5.16, IC7.16, INOUT1.1, PWRLED1.2, R3.1, R21.1, R22.1, R23.1, R24.1, S1.1, S2.1, U$1.1, U$1.4
Vss: C1.2, C2.2, C4.2, C6.2, C7.2, GND1.1, GND2.1, GNDHIIN1.1, IC1.8, IC4.3, IC4.4, IC4.5, IC5.8, IC5.13, IC7.8, INOUT1.2, LED1.3, LED1.8, LED2.3, LED2.8, R3.3, R4.1, R6.1, R25.1, R26.1, R28.1, R29.1, R30.1, R32.2, S1.3, S2.3, U$1.14
