utahrobotics/Electrical-2019-2020/Master_Schematic_19-20/NG_IMU_Interface_Board/NG_IMU_Interface_Board.kicad_pcb

## KiCad design Master_Schematic_19-20/NG_IMU_Interface_Board/NG_IMU_Interface_Board.kicad_pcb (2020-02-05)

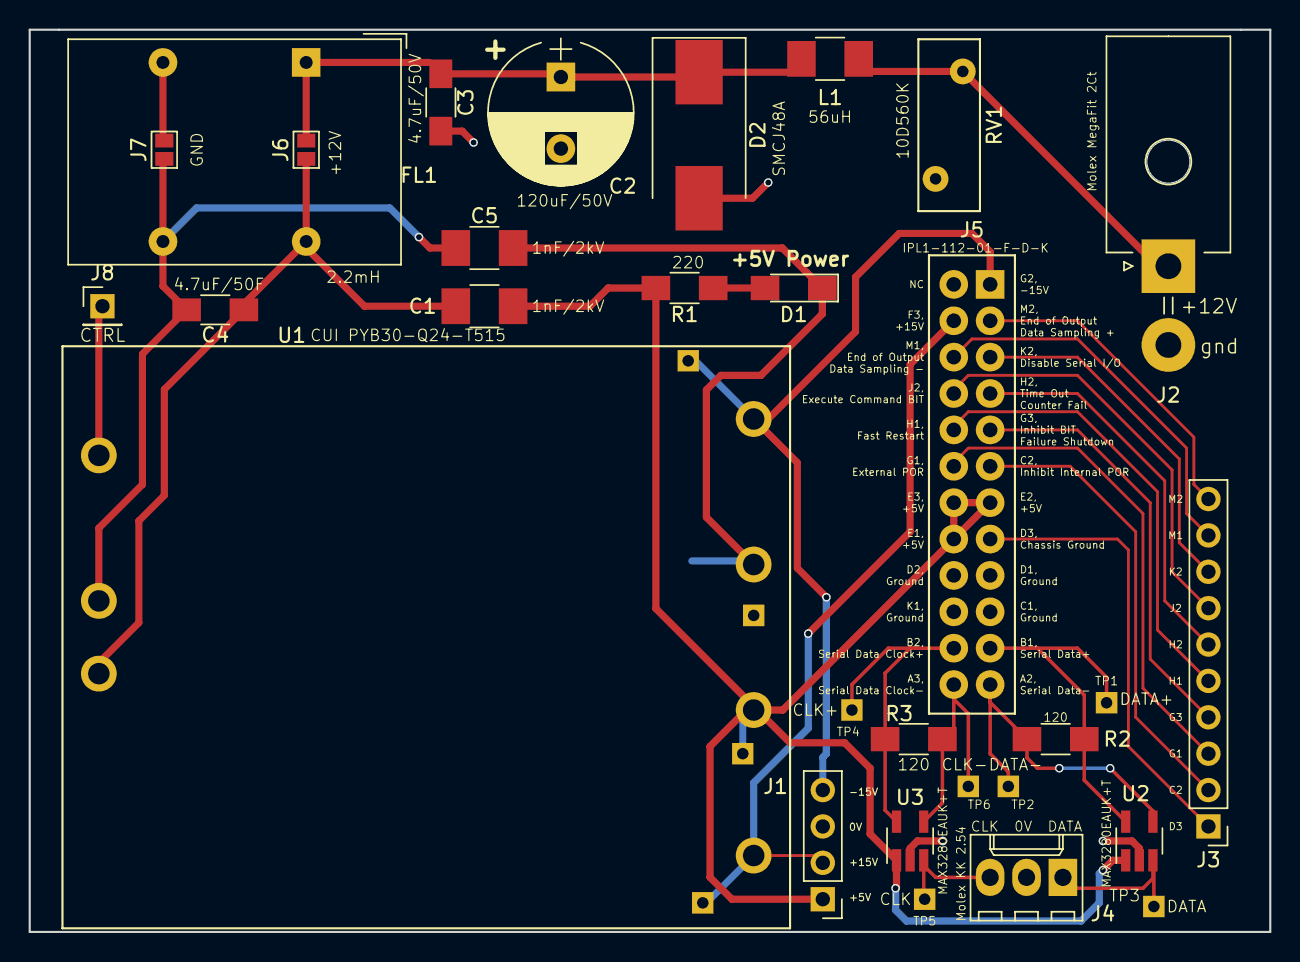
[picture p75: board NG_IMU_Interface_Board.kicad_pcb from above]

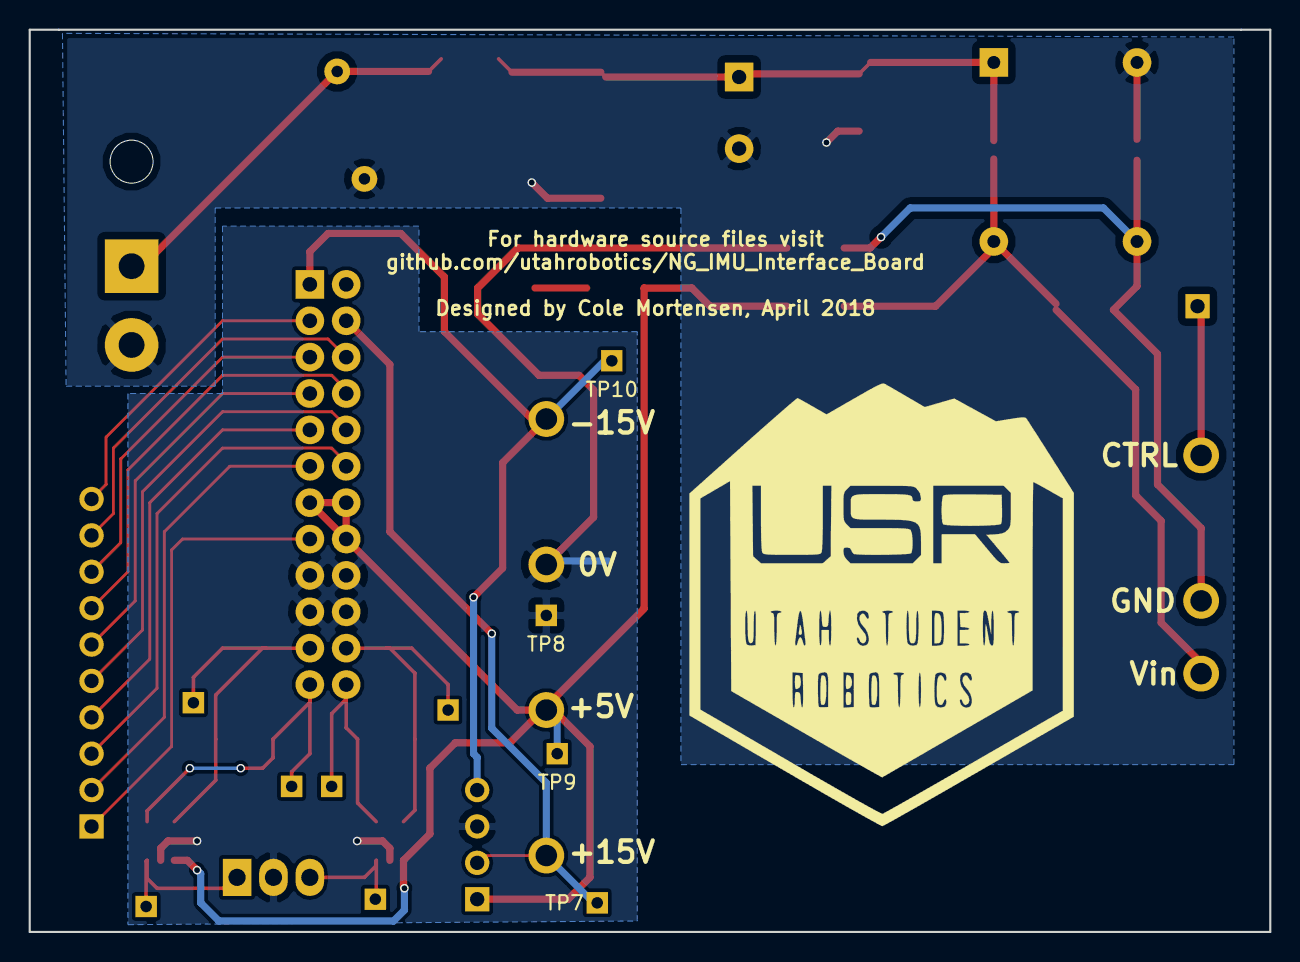
[picture p76: board NG_IMU_Interface_Board.kicad_pcb from below]

Board: 2 copper layers, 86.6 x 63.0 mm, 34 parts (4 on the bottom side), 27 nets.

Parts:
C1, C5: 1nF/2kV; C_1210_HandSoldering
C2: 120μF/50V; CP_Radial_D10.0mm_P5.00mm
C3, C4: 4.7μF/50V; C_1206_HandSoldering
D1: LED; LED_1206_HandSoldering
D2: SMCJ48A; D_SMC_Handsoldering
FL1: 2.2mH; Choke_Schaffner_RN214-04-15.5x23.0mm
J1: Conn_01x04; Pin_Header_Straight_1x04_Pitch2.54mm
J2: Conn_01x02; Molex_MegaFit_2x01x5.70mm_Angled
J3: Conn_01x10; Pin_Header_Straight_1x10_Pitch2.54mm
J4: Conn_01x03; Molex_KK-6410-03_03x2.54mm_Straight
J5: Conn_02x12_Top_Bottom; IPL1-112-01-F-D-K
J6, J7: GS2
J8: Conn_01x01; Pin_Header_Straight_1x01_Pitch2.54mm
L1: 56 uH; L_1210_HandSoldering
R1: 220; R_1206_HandSoldering
R2, R3: 120; R_1206_HandSoldering
RV1: 10D560K; RV_Disc_D12_W4.3_P7.5
TP1, TP2, TP3, TP4, TP5, TP6, TP7, TP8, TP9, TP10: TEST; Measurement_Point_Square-TH_Small
U1: PYB30-Q24-T515
U2, U3: MAX3280EAUK+T; SOT-23-5_HandSoldering

Connections:
/0V: C5.2, D1.1, J1.3, J4.2, J5.9, J5.10, J5.21, J5.22, TP8.1, U1.5, U2.2, U3.2
/+5V: C1.1, J1.1, J5.7, J5.19, J5.20, R1.2, TP9.1, U1.6, U2.1, U3.1
/+12V: J2.1, L1.1, RV1.2
/+15V: J1.2, J5.14, TP7.1, U1.7
/-15V: J1.4, J5.1, TP10.1, U1.4
/C2: J3.2, J5.6
/CLK+: J5.23, R3.2, TP4.1, U3.5
/CLK-: J5.24, R3.1, TP6.1, U3.4
/CLK_clean: J4.3, TP5.1, U3.3
/D3: J3.1, J5.8
/Data+: J5.11, R2.2, TP1.1, U2.5
/Data-: J5.12, R2.1, TP2.1, U2.4
/Data_clean: J4.1, TP3.1, U2.3
/G1: J3.3, J5.18
/G3: J3.4, J5.5
/H1: J3.5, J5.17
/H2: J3.6, J5.4
/J2: J3.7, J5.16
/K2: J3.8, J5.3
/M1: J3.9, J5.15
/M2: J3.10, J5.2
/gnd: C2.2, C3.2, D2.2, FL1.3, J2.2, J7.2, RV1.1
unnamed: C1.2, C4.1, FL1.2, J6.1, U1.1
unnamed: C2.1, C3.1, D2.1, FL1.1, J6.2, L1.2
unnamed: C4.2, C5.1, FL1.4, J7.1, U1.2
unnamed: D1.2, R1.1
unnamed: J8.1, U1.3
