utahrobotics/Electrical-2019-2020/IMU_Interface/teensy4/core_pins.h

/* Teensyduino Core Library
 * http://www.pjrc.com/teensy/
 * Copyright (c) 2018 PJRC.COM, LLC.
 *
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
 * 2. If the Software is incorporated into a build system that allows
 * selection among a list of target devices, then similar target
 * devices manufactured by PJRC.COM must be included in the list of
 * target devices and selectable in the same manner.
 *
 * THE SOFTWARE IS PROVIDED "AS IS", WITHOUT WARRANTY OF ANY KIND,
 * EXPRESS OR IMPLIED, INCLUDING BUT NOT LIMITED TO THE WARRANTIES OF
 * MERCHANTABILITY, FITNESS FOR A PARTICULAR PURPOSE AND
 * NONINFRINGEMENT. IN NO EVENT SHALL THE AUTHORS OR COPYRIGHT HOLDERS
 * BE LIABLE FOR ANY CLAIM, DAMAGES OR OTHER LIABILITY, WHETHER IN AN
 * ACTION OF CONTRACT, TORT OR OTHERWISE, ARISING FROM, OUT OF OR IN
 * CONNECTION WITH THE SOFTWARE OR THE USE OR OTHER DEALINGS IN THE
 * SOFTWARE.
 */

#pragma once
#include "imxrt.h"
#include "pins_arduino.h"

#define HIGH			1
#define LOW			0
#define INPUT			0
#define OUTPUT			1
#define INPUT_PULLUP		2
#define INPUT_PULLDOWN		3
#define OUTPUT_OPENDRAIN	4
#define INPUT_DISABLE		5
#define LSBFIRST		0
#define MSBFIRST		1
#define _BV(n)			(1<<(n))
#define CHANGE			4
#define FALLING			2
#define RISING			3


#if defined(__IMXRT1062__)

#define CORE_NUM_TOTAL_PINS	40
#define CORE_NUM_DIGITAL	40
#define CORE_NUM_INTERRUPT	40
#define CORE_NUM_ANALOG		14
#define CORE_NUM_PWM		27

#define CORE_PIN0_BIT		3
#define CORE_PIN1_BIT		2
#define CORE_PIN2_BIT		4
#define CORE_PIN3_BIT		5
#define CORE_PIN4_BIT		6
#define CORE_PIN5_BIT		8
#define CORE_PIN6_BIT		10
#define CORE_PIN7_BIT		17
#define CORE_PIN8_BIT		16
#define CORE_PIN9_BIT		11
#define CORE_PIN10_BIT		0
#define CORE_PIN11_BIT		2
#define CORE_PIN12_BIT		1
#define CORE_PIN13_BIT		3
#define CORE_PIN14_BIT		18
#define CORE_PIN15_BIT		19
#define CORE_PIN16_BIT		23
#define CORE_PIN17_BIT		22
#define CORE_PIN18_BIT		17
#define CORE_PIN19_BIT		16
#define CORE_PIN20_BIT		26
#define CORE_PIN21_BIT		27
#define CORE_PIN22_BIT		24
#define CORE_PIN23_BIT		25
#define CORE_PIN24_BIT		12
#define CORE_PIN25_BIT		13
#define CORE_PIN26_BIT		30
#define CORE_PIN27_BIT		31
#define CORE_PIN28_BIT		18
#define CORE_PIN29_BIT		31
#define CORE_PIN30_BIT		23
#define CORE_PIN31_BIT		22
#define CORE_PIN32_BIT		12
#define CORE_PIN33_BIT		7
#define CORE_PIN34_BIT		15
#define CORE_PIN35_BIT		14
#define CORE_PIN36_BIT		13
#define CORE_PIN37_BIT		12
#define CORE_PIN38_BIT		17
#define CORE_PIN39_BIT		16

#define CORE_PIN0_BITMASK	(1<<(CORE_PIN0_BIT))
#define CORE_PIN1_BITMASK	(1<<(CORE_PIN1_BIT))
#define CORE_PIN2_BITMASK	(1<<(CORE_PIN2_BIT))
#define CORE_PIN3_BITMASK	(1<<(CORE_PIN3_BIT))
#define CORE_PIN4_BITMASK	(1<<(CORE_PIN4_BIT))
#define CORE_PIN5_BITMASK	(1<<(CORE_PIN5_BIT))
#define CORE_PIN6_BITMASK	(1<<(CORE_PIN6_BIT))
#define CORE_PIN7_BITMASK	(1<<(CORE_PIN7_BIT))
#define CORE_PIN8_BITMASK	(1<<(CORE_PIN8_BIT))
#define CORE_PIN9_BITMASK	(1<<(CORE_PIN9_BIT))
#define CORE_PIN10_BITMASK	(1<<(CORE_PIN10_BIT))
#define CORE_PIN11_BITMASK	(1<<(CORE_PIN11_BIT))
#define CORE_PIN12_BITMASK	(1<<(CORE_PIN12_BIT))
#define CORE_PIN13_BITMASK	(1<<(CORE_PIN13_BIT))
#define CORE_PIN14_BITMASK	(1<<(CORE_PIN14_BIT))
#define CORE_PIN15_BITMASK	(1<<(CORE_PIN15_BIT))
#define CORE_PIN16_BITMASK	(1<<(CORE_PIN16_BIT))
#define CORE_PIN17_BITMASK	(1<<(CORE_PIN17_BIT))
#define CORE_PIN18_BITMASK	(1<<(CORE_PIN18_BIT))
#define CORE_PIN19_BITMASK	(1<<(CORE_PIN19_BIT))
#define CORE_PIN20_BITMASK	(1<<(CORE_PIN20_BIT))
#define CORE_PIN21_BITMASK	(1<<(CORE_PIN21_BIT))
#define CORE_PIN22_BITMASK	(1<<(CORE_PIN22_BIT))
#define CORE_PIN23_BITMASK	(1<<(CORE_PIN23_BIT))
#define CORE_PIN24_BITMASK	(1<<(CORE_PIN24_BIT))
#define CORE_PIN25_BITMASK	(1<<(CORE_PIN25_BIT))
#define CORE_PIN26_BITMASK	(1<<(CORE_PIN26_BIT))
#define CORE_PIN27_BITMASK	(1<<(CORE_PIN27_BIT))
#define CORE_PIN28_BITMASK	(1<<(CORE_PIN28_BIT))
#define CORE_PIN29_BITMASK	(1<<(CORE_PIN29_BIT))
#define CORE_PIN30_BITMASK	(1<<(CORE_PIN30_BIT))
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
		} else if (pin == 13) {
			return (CORE_PIN13_PINREG & CORE_PIN13_BITMASK) ? 1 : 0;
		} else if (pin == 14) {
			return (CORE_PIN14_PINREG & CORE_PIN14_BITMASK) ? 1 : 0;
		} else if (pin == 15) {
			return (CORE_PIN15_PINREG & CORE_PIN15_BITMASK) ? 1 : 0;
		} else if (pin == 16) {
			return (CORE_PIN16_PINREG & CORE_PIN16_BITMASK) ? 1 : 0;
		} else if (pin == 17) {
			return (CORE_PIN17_PINREG & CORE_PIN17_BITMASK) ? 1 : 0;
		} else if (pin == 18) {
			return (CORE_PIN18_PINREG & CORE_PIN18_BITMASK) ? 1 : 0;
		} else if (pin == 19) {
			return (CORE_PIN19_PINREG & CORE_PIN19_BITMASK) ? 1 : 0;
		} else if (pin == 20) {
			return (CORE_PIN20_PINREG & CORE_PIN20_BITMASK) ? 1 : 0;
		} else if (pin == 21) {
			return (CORE_PIN21_PINREG & CORE_PIN21_BITMASK) ? 1 : 0;
		} else if (pin == 22) {
			return (CORE_PIN22_PINREG & CORE_PIN22_BITMASK) ? 1 : 0;
		} else if (pin == 23) {
			return (CORE_PIN23_PINREG & CORE_PIN23_BITMASK) ? 1 : 0;
		} else if (pin == 24) {
			return (CORE_PIN24_PINREG & CORE_PIN24_BITMASK) ? 1 : 0;
		} else if (pin == 25) {
			return (CORE_PIN25_PINREG & CORE_PIN25_BITMASK) ? 1 : 0;
		} else if (pin == 26) {
			return (CORE_PIN26_PINREG & CORE_PIN26_BITMASK) ? 1 : 0;
		} else if (pin == 27) {
			return (CORE_PIN27_PINREG & CORE_PIN27_BITMASK) ? 1 : 0;
		} else if (pin == 28) {
			return (CORE_PIN28_PINREG & CORE_PIN28_BITMASK) ? 1 : 0;
		} else if (pin == 29) {
			return (CORE_PIN29_PINREG & CORE_PIN29_BITMASK) ? 1 : 0;
		} else if (pin == 30) {
			return (CORE_PIN30_PINREG & CORE_PIN30_BITMASK) ? 1 : 0;
		} else if (pin == 31) {
			return (CORE_PIN31_PINREG & CORE_PIN31_BITMASK) ? 1 : 0;
		} else if (pin == 32) {
			return (CORE_PIN32_PINREG & CORE_PIN32_BITMASK) ? 1 : 0;
		} else if (pin == 33) {
			return (CORE_PIN33_PINREG & CORE_PIN33_BITMASK) ? 1 : 0;
		} else {
			return 0;
		}
	} else {
		return (*portInputRegister(pin) & digitalPinToBitMask(pin)) ? 1 : 0;
	}
}


void pinMode(uint8_t pin, uint8_t mode);
void init_pins(void);
void analogWrite(uint8_t pin, int val);
uint32_t analogWriteRes(uint32_t bits);
static inline uint32_t analogWriteResolution(uint32_t bits) { return analogWriteRes(bits); }
void analogWriteFrequency(uint8_t pin, float frequency);
void attachInterrupt(uint8_t pin, void (*function)(void), int mode);
void detachInterrupt(uint8_t pin);
void _init_Teensyduino_internal_(void);
int analogRead(uint8_t pin);
void analogReference(uint8_t type);
void analogReadRes(unsigned int bits);
static inline void analogReadResolution(unsigned int bits) { analogReadRes(bits); }
void analogReadAveraging(unsigned int num);
void analog_init(void);
int touchRead(uint8_t pin);

static inline void shiftOut(uint8_t, uint8_t, uint8_t, uint8_t) __attribute__((always_inline, unused));
extern void _shiftOut(uint8_t dataPin, uint8_t clockPin, uint8_t bitOrder, uint8_t value) __attribute__((noinline));
extern void shiftOut_lsbFirst(uint8_t dataPin, uint8_t clockPin, uint8_t value) __attribute__((noinline));
extern void shiftOut_msbFirst(uint8_t dataPin, uint8_t clockPin, uint8_t value) __attribute__((noinline));

static inline void shiftOut(uint8_t dataPin, uint8_t clockPin, uint8_t bitOrder, uint8_t value)
{
        if (__builtin_constant_p(bitOrder)) {
                if (bitOrder == LSBFIRST) {
                        shiftOut_lsbFirst(dataPin, clockPin, value);
                } else {
                        shiftOut_msbFirst(dataPin, clockPin, value);
                }
        } else {
                _shiftOut(dataPin, clockPin, bitOrder, value);
        }
}

static inline uint8_t shiftIn(uint8_t, uint8_t, uint8_t) __attribute__((always_inline, unused));
extern uint8_t _shiftIn(uint8_t dataPin, uint8_t clockPin, uint8_t bitOrder) __attribute__((noinline));
extern uint8_t shiftIn_lsbFirst(uint8_t dataPin, uint8_t clockPin) __attribute__((noinline));
extern uint8_t shiftIn_msbFirst(uint8_t dataPin, uint8_t clockPin) __attribute__((noinline));

static inline uint8_t shiftIn(uint8_t dataPin, uint8_t clockPin, uint8_t bitOrder)
{
        if (__builtin_constant_p(bitOrder)) {
                if (bitOrder == LSBFIRST) {
                        return shiftIn_lsbFirst(dataPin, clockPin);
                } else {
                        return shiftIn_msbFirst(dataPin, clockPin);
                }
        } else {
                return _shiftIn(dataPin, clockPin, bitOrder);
        }
}

void _reboot_Teensyduino_(void) __attribute__((noreturn));
void _restart_Teensyduino_(void) __attribute__((noreturn));

void yield(void);

void delay(uint32_t msec);

extern volatile uint32_t F_CPU_ACTUAL;
extern volatile uint32_t F_BUS_ACTUAL;
extern volatile uint32_t systick_millis_count;

static inline uint32_t millis(void) __attribute__((always_inline, unused));
static inline uint32_t millis(void)
{
	return systick_millis_count;
}

double seconds(void);
uint32_t micros(void);
uint32_t nanos(void);

static inline void delayMicroseconds(uint32_t) __attribute__((always_inline, unused));
static inline void delayMicroseconds(uint32_t usec)
{
	uint32_t begin = ARM_DWT_CYCCNT;
	uint32_t cycles = F_CPU_ACTUAL / 1000000 * usec;
	// TODO: check if cycles is large, do a wait with yield calls until it's smaller
	while (ARM_DWT_CYCCNT - begin < cycles) ; // wait
}

static inline void delayNanoseconds(uint32_t) __attribute__((always_inline, unused));
static inline void delayNanoseconds(uint32_t nsec)
{
	uint32_t begin = ARM_DWT_CYCCNT;
	uint32_t cycles =   ((F_CPU_ACTUAL>>16) * nsec) / (1000000000UL>>16);
	while (ARM_DWT_CYCCNT - begin < cycles) ; // wait
}


unsigned long rtc_get(void);
void rtc_set(unsigned long t);
void rtc_compensate(int adjust);

void tempmon_init(void);
float tempmonGetTemp(void);
void tempmon_Start();
void tempmon_Stop();
void tempmon_PwrDwn();

#ifdef __cplusplus
}

class teensy3_clock_class
{
public:
        static unsigned long get(void) __attribute__((always_inline)) { return rtc_get(); }
        static void set(unsigned long t) __attribute__((always_inline)) { rtc_set(t); }
        static void compensate(int adj) __attribute__((always_inline)) { rtc_compensate(adj); }
};
extern teensy3_clock_class Teensy3Clock;

#endif // __cplusplus
