utahrobotics/Electrical-2019-2020/IMU_Interface/ros_lib/control_msgs/GripperCommandActionGoal.h

#ifndef _ROS_control_msgs_GripperCommandActionGoal_h
#define _ROS_control_msgs_GripperCommandActionGoal_h

#include <stdint.h>
#include <string.h>
#include <stdlib.h>
#include "ros/msg.h"
#include "std_msgs/Header.h"
#include "actionlib_msgs/GoalID.h"
#include "control_msgs/GripperCommandGoal.h"

namespace control_msgs
{

  class GripperCommandActionGoal : public ros::Msg
  {
    public:
      typedef std_msgs::Header _header_type;
      _header_type header;
      typedef actionlib_msgs::GoalID _goal_id_type;
      _goal_id_type goal_id;
      typedef control_msgs::GripperCommandGoal _goal_type;
      _goal_type goal;

    GripperCommandActionGoal():
      header(),
      goal_id(),
      goal()
    {
    }

    virtual int serialize(unsigned char *outbuffer) const override
    {
      int offset = 0;
      offset += this->header.serialize(outbuffer + offset);
      offset += this->goal_id.serialize(outbuffer + offset);
      offset += this->goal.serialize(outbuffer + offset);
      return offset;
    }

    virtual int deserialize(unsigned char *inbuffer) override
    {
      int offset = 0;
      offset += this->header.deserialize(inbuffer + offset);
      offset += this->goal_id.deserialize(inbuffer + offset);
      offset += this->goal.deserialize(inbuffer + offset);
     return offset;
    }

    virtual const char * getType() override { return "control_msgs/GripperCommandActionGoal"; };
    virtual const char * getMD5() override { return "aa581f648a35ed681db2ec0bf7a82bea"; };

  };

}
#endif
