utahrobotics/Electrical-2019-2020/IMU_Interface/teensy4/imxrt.h

#pragma once
#include <stdint.h>

// Definitions based these documents:
//   i.MX RT1050 Reference Manual, Rev. 1, 03/2018
//   ARM v7-M Architecture Reference Manual (DDI 0403E.b)

enum IRQ_NUMBER_t {
        IRQ_DMA_CH0 =           0,
        IRQ_DMA_CH1 =           1,
        IRQ_DMA_CH2 =           2,
        IRQ_DMA_CH3 =           3,
        IRQ_DMA_CH4 =           4,
        IRQ_DMA_CH5 =           5,
        IRQ_DMA_CH6 =           6,
        IRQ_DMA_CH7 =           7,
        IRQ_DMA_CH8 =           8,
        IRQ_DMA_CH9 =           9,
        IRQ_DMA_CH10 =          10,
        IRQ_DMA_CH11 =          11,
        IRQ_DMA_CH12 =          12,
        IRQ_DMA_CH13 =          13,
        IRQ_DMA_CH14 =          14,
        IRQ_DMA_CH15 =          15,
        IRQ_DMA_ERROR =         16,
        IRQ_CTI0 =              17,
        IRQ_CTI1 =              18,
        IRQ_CORE_ERROR =        19, // TODO - name?
        IRQ_LPUART1 =           20,
        IRQ_LPUART2 =           21,
        IRQ_LPUART3 =           22,
        IRQ_LPUART4 =           23,
        IRQ_LPUART5 =           24,
        IRQ_LPUART6 =           25,
        IRQ_LPUART7 =           26,
        IRQ_LPUART8 =           27,
        IRQ_LPI2C1 =            28,
        IRQ_LPI2C2 =            29,
        IRQ_LPI2C3 =            30,
        IRQ_LPI2C4 =            31,
        IRQ_LPSPI1 =            32,
        IRQ_LPSPI2 =            33,
        IRQ_LPSPI3 =            34,
        IRQ_LPSPI4 =            35,
        IRQ_CAN1 =              36,
        IRQ_CAN2 =              37,
        IRQ_ADDR_ERR =          38, // TODO: name?
        IRQ_KPP =               39,
        IRQ_TSC_DIG =           40,
        IRQ_GPR_IRQ =           41,
        IRQ_LCDIF =             42,
        IRQ_CSI =               43,
        IRQ_PXP =               44,
        IRQ_WDOG2 =             45,
        IRQ_SNVS_IRQ =          46,
        IRQ_SNVS_SECURITY =     47,
        IRQ_SNVS_ONOFF =        48,
        IRQ_CSU =               49,
        IRQ_DCP0 =              50, // TODO: ???
        IRQ_DCP1 =              51, // TODO: ???
        IRQ_DCP2 =              52, // TODO: ???
        IRQ_TRNG =              53,
        IRQ_SJC_IRQ =           54,
        IRQ_BEE =               55,
        IRQ_SAI1 =              56,
        IRQ_SAI2 =              57,
        IRQ_SAI3_RX =           58,
        IRQ_SAI3_TX =           59,
        IRQ_SPDIF =             60,
        IRQ_BROWNOUT0 =         61,
        IRQ_Reserved1 =         62,
        IRQ_TEMPERATURE =       63,
        IRQ_TEMPERATURE_PANIC = 64,
        IRQ_USBPHY0 =           65,
        IRQ_USBPHY1 =           66,
        IRQ_ADC1 =              67,
        IRQ_ADC2 =              68,
        IRQ_DCDC =              69,
        IRQ_SOFTWARE =          70,
        IRQ_Reserved2 =         71,
        IRQ_GPIO1_INT0 =        72,
        IRQ_GPIO1_INT1 =        73,
        IRQ_GPIO1_INT2 =        74,
        IRQ_GPIO1_INT3 =        75,
        IRQ_GPIO1_INT4 =        76,
        IRQ_GPIO1_INT5 =        77,
        IRQ_GPIO1_INT6 =        78,
        IRQ_GPIO1_INT7 =        79,
        IRQ_GPIO1_0_15 =        80,
        IRQ_GPIO1_16_31 =       81,
        IRQ_GPIO2_0_15 =        82,
        IRQ_GPIO2_16_31 =       83,
        IRQ_GPIO3_0_15 =        84,
        IRQ_GPIO3_16_31 =       85,
        IRQ_GPIO4_0_15 =        86,
        IRQ_GPIO4_16_31 =       87,
        IRQ_GPIO5_0_15 =        88,
        IRQ_GPIO5_16_31 =       89,
        IRQ_FLEXIO1 =           90,
        IRQ_FLEXIO2 =           91,
        IRQ_WDOG1 =             92,
        IRQ_RTWDOG =            93,
        IRQ_EWM =               94,
        IRQ_CCM1 =              95,
        IRQ_CCM2 =              96,
        IRQ_GPC =               97,
        IRQ_SRC =               98,
        IRQ_Reserved3 =         99,
        IRQ_GPT1 =              100,
        IRQ_GPT2 =              101,
        IRQ_FLEXPWM1_0 =        102,
        IRQ_FLEXPWM1_1 =        103,
        IRQ_FLEXPWM1_2 =        104,
        IRQ_FLEXPWM1_3 =        105,
        IRQ_FLEXPWM1_FAULT =    106,
        IRQ_FLEXSPI2 =          107, // RT1060 only
        IRQ_FLEXSPI =           108,
        IRQ_SEMC =              109,
        IRQ_SDHC1 =             110,
        IRQ_SDHC2 =             111,
        IRQ_USB2 =              112,
        IRQ_USB1 =              113,
        IRQ_ENET =              114,
        IRQ_ENET_TIMER =        115,
        IRQ_XBAR1_01 =          116,
        IRQ_XBAR1_23 =          117,
        IRQ_ADC_ETC0 =          118,
        IRQ_ADC_ETC1 =          119,
        IRQ_ADC_ETC2 =          120,
        IRQ_ADC_ETC_ERR =       121,
        IRQ_PIT =               122,
        IRQ_ACMP0 =             123,
        IRQ_ACMP1 =             124,
        IRQ_ACMP2 =             125,
        IRQ_ACMP3 =             126,
        IRQ_Reserved4 =         127,
        IRQ_Reserved5 =         128,
        IRQ_ENC1 =              129,
        IRQ_ENC2 =              130,
        IRQ_ENC3 =              131,
        IRQ_ENC4 =              132,
        IRQ_QTIMER1 =           133,
        IRQ_QTIMER2 =           134,
        IRQ_QTIMER3 =           135,
        IRQ_QTIMER4 =           136,
        IRQ_FLEXPWM2_0 =        137,
        IRQ_FLEXPWM2_1 =        138,
        IRQ_FLEXPWM2_2 =        139,
        IRQ_FLEXPWM2_3 =        140,
        IRQ_FLEXPWM2_FAULT =    141,
        IRQ_FLEXPWM3_0 =        142,
        IRQ_FLEXPWM3_1 =        143,
        IRQ_FLEXPWM3_2 =        144,
        IRQ_FLEXPWM3_3 =        145,
        IRQ_FLEXPWM3_FAULT =    146,
        IRQ_FLEXPWM4_0 =        147,
        IRQ_FLEXPWM4_1 =        148,
        IRQ_FLEXPWM4_2 =        149,
        IRQ_FLEXPWM4_3 =        150,
        IRQ_FLEXPWM4_FAULT =    151,
        IRQ_ENET2 =             152, // RT1060 only
        IRQ_ENET2_TIMER =       153, // RT1060 only
        IRQ_CAN3 =              154, // RT1060 only
        IRQ_Reserved6 =         155,
        IRQ_FLEXIO3 =           156, // RT1060 only
        IRQ_GPIO6789 =          157, // RT1060 only
        IRQ_SJC_DEBUG =         158,
        IRQ_NMI_WAKEUP =        159
};
#define NVIC_NUM_INTERRUPTS     160
#define DMA_NUM_CHANNELS        32

#ifdef __cplusplus
extern "C" void (* _VectorsRam[NVIC_NUM_INTERRUPTS+16])(void);
static inline void attachInterruptVector(IRQ_NUMBER_t irq, void (*function)(void)) __attribute__((always_inline, unused));
static inline void attachInterruptVector(IRQ_NUMBER_t irq, void (*function)(void)) { _VectorsRam[irq + 16] = function; asm volatile("": : :"memory"); }
#else
extern void (* _VectorsRam[NVIC_NUM_INTERRUPTS+16])(void);
static inline void attachInterruptVector(enum IRQ_NUMBER_t irq, void (*function)(void)) __attribute__((always_inline, unused));
static inline void attachInterruptVector(enum IRQ_NUMBER_t irq, void (*function)(void)) { _VectorsRam[irq + 16] = function; asm volatile("": : :"memory"); }
#endif


#define DMAMUX_SOURCE_FLEXIO1_REQUEST0		0
#define DMAMUX_SOURCE_FLEXIO1_REQUEST1		0
#define DMAMUX_SOURCE_FLEXIO2_REQUEST0		1
#define DMAMUX_SOURCE_FLEXIO2_REQUEST1		1
#define DMAMUX_SOURCE_LPUART1_RX		2
#define DMAMUX_SOURCE_LPUART1_TX		3
#define DMAMUX_SOURCE_LPUART3_RX		4
#define DMAMUX_SOURCE_LPUART3_TX		5
#define DMAMUX_SOURCE_LPUART5_RX		6
#define DMAMUX_SOURCE_LPUART5_TX		7
#define DMAMUX_SOURCE_LPUART7_RX		8
#define DMAMUX_SOURCE_LPUART7_TX		9
#define DMAMUX_SOURCE_FLEXCAN3			11
#define DMAMUX_SOURCE_CSI			12
#define DMAMUX_SOURCE_LPSPI1_RX			13
#define DMAMUX_SOURCE_LPSPI1_TX			14
#define DMAMUX_SOURCE_LPSPI3_RX			15
#define DMAMUX_SOURCE_LPSPI3_TX			16
#define DMAMUX_SOURCE_LPI2C1			17
#define DMAMUX_SOURCE_LPI2C3			18
#define DMAMUX_SOURCE_SAI1_RX			19
#define DMAMUX_SOURCE_SAI1_TX			20
#define DMAMUX_SOURCE_SAI2_RX			21
#define DMAMUX_SOURCE_SAI2_TX			22
#define DMAMUX_SOURCE_ADC_ETC			23
#define DMAMUX_SOURCE_ADC1			24
#define DMAMUX_SOURCE_ACMP1			25
#define DMAMUX_SOURCE_ACMP3			26
#define DMAMUX_SOURCE_FLEXSPI_RX		28
#define DMAMUX_SOURCE_FLEXSPI_TX		29
#define DMAMUX_SOURCE_XBAR1_0			30
#define DMAMUX_SOURCE_XBAR1_1			31
#define DMAMUX_SOURCE_FLEXPWM1_READ0		32
#define DMAMUX_SOURCE_FLEXPWM1_READ1		33
#define DMAMUX_SOURCE_FLEXPWM1_READ2		34
#define DMAMUX_SOURCE_FLEXPWM1_READ3		35
#define DMAMUX_SOURCE_FLEXPWM1_WRITE0		36
#define DMAMUX_SOURCE_FLEXPWM1_WRITE1		37
#define DMAMUX_SOURCE_FLEXPWM1_WRITE2		38
#define DMAMUX_SOURCE_FLEXPWM1_WRITE3		39
#define DMAMUX_SOURCE_FLEXPWM3_READ0		40
#define DMAMUX_SOURCE_FLEXPWM3_READ1		41
#define DMAMUX_SOURCE_FLEXPWM3_READ2		42
#define DMAMUX_SOURCE_FLEXPWM3_READ3		43
#define DMAMUX_SOURCE_FLEXPWM3_WRITE0		44
#define DMAMUX_SOURCE_FLEXPWM3_WRITE1		45
#define DMAMUX_SOURCE_FLEXPWM3_WRITE2		46
#define DMAMUX_SOURCE_FLEXPWM3_WRITE3		47
#define DMAMUX_SOURCE_QTIMER1_READ0		48
#define DMAMUX_SOURCE_QTIMER1_READ1		49
#define DMAMUX_SOURCE_QTIMER1_READ2		50
#define DMAMUX_SOURCE_QTIMER1_READ3		51
#define DMAMUX_SOURCE_QTIMER1_WRITE0_CMPLD1	52
#define DMAMUX_SOURCE_QTIMER1_WRITE1_CMPLD1	53
#define DMAMUX_SOURCE_QTIMER1_WRITE2_CMPLD1	54
#define DMAMUX_SOURCE_QTIMER1_WRITE3_CMPLD1	55
#define DMAMUX_SOURCE_QTIMER1_WRITE1_CMPLD2	52
#define DMAMUX_SOURCE_QTIMER1_WRITE0_CMPLD2	53
#define DMAMUX_SOURCE_QTIMER1_WRITE3_CMPLD2	54
#define DMAMUX_SOURCE_QTIMER1_WRITE2_CMPLD2	55
#define DMAMUX_SOURCE_QTIMER3_READ0		56
#define DMAMUX_SOURCE_QTIMER3_READ1		57
#define DMAMUX_SOURCE_QTIMER3_READ2		58
#define DMAMUX_SOURCE_QTIMER3_READ3		59
#define DMAMUX_SOURCE_QTIMER3_WRITE0_CMPLD1	56
#define DMAMUX_SOURCE_QTIMER3_WRITE1_CMPLD1	57
#define DMAMUX_SOURCE_QTIMER3_WRITE2_CMPLD1	58
#define DMAMUX_SOURCE_QTIMER3_WRITE3_CMPLD1	59
#define DMAMUX_SOURCE_QTIMER3_WRITE1_CMPLD2	56
#define DMAMUX_SOURCE_QTIMER3_WRITE0_CMPLD2	57
#define DMAMUX_SOURCE_QTIMER3_WRITE3_CMPLD2	58
#define DMAMUX_SOURCE_QTIMER3_WRITE2_CMPLD2	59
#define DMAMUX_SOURCE_FLEXSPI2_RX		60
#define DMAMUX_SOURCE_FLEXSPI2_TX		61
#define DMAMUX_SOURCE_FLEXIO1_REQUEST2		64
#define DMAMUX_SOURCE_FLEXIO1_REQUEST3		64
#define DMAMUX_SOURCE_FLEXIO2_REQUEST2		65
#define DMAMUX_SOURCE_FLEXIO2_REQUEST3		65
#define DMAMUX_SOURCE_LPUART2_RX		66
#define DMAMUX_SOURCE_LPUART2_TX		67
#define DMAMUX_SOURCE_LPUART4_RX		68
#define DMAMUX_SOURCE_LPUART4_TX		69
#define DMAMUX_SOURCE_LPUART6_RX		70
#define DMAMUX_SOURCE_LPUART6_TX		71
#define DMAMUX_SOURCE_LPUART8_RX		72
#define DMAMUX_SOURCE_LPUART8_TX		73
#define DMAMUX_SOURCE_PXP			75
#define DMAMUX_SOURCE_LCDIF			76
#define DMAMUX_SOURCE_LPSPI2_RX			77
#define DMAMUX_SOURCE_LPSPI2_TX			78
#define DMAMUX_SOURCE_LPSPI4_RX			79
#define DMAMUX_SOURCE_LPSPI4_TX			80
#define DMAMUX_SOURCE_LPI2C2			81
#define DMAMUX_SOURCE_LPI2C4			82
#define DMAMUX_SOURCE_SAI3_RX			83
#define DMAMUX_SOURCE_SAI3_TX			84
#define DMAMUX_SOURCE_SPDIF_RX			85
#define DMAMUX_SOURCE_SPDIF_TX			86
#define DMAMUX_SOURCE_ADC2			88
#define DMAMUX_SOURCE_ACMP2			89
#define DMAMUX_SOURCE_ACMP4			90
#define DMAMUX_SOURCE_ENET1_TIMER0		92
#define DMAMUX_SOURCE_ENET1_TIMER1		93
#define DMAMUX_SOURCE_XBAR1_2			94
#define DMAMUX_SOURCE_XBAR1_3			95
#define DMAMUX_SOURCE_FLEXPWM2_READ0		96
#define DMAMUX_SOURCE_FLEXPWM2_READ1		97
#define DMAMUX_SOURCE_FLEXPWM2_READ2		98
#define DMAMUX_SOURCE_FLEXPWM2_READ3		99
#define DMAMUX_SOURCE_FLEXPWM2_WRITE0		100
#define DMAMUX_SOURCE_FLEXPWM2_WRITE1		101
#define DMAMUX_SOURCE_FLEXPWM2_WRITE2		102
#define DMAMUX_SOURCE_FLEXPWM2_WRITE3		103
#define DMAMUX_SOURCE_FLEXPWM4_READ0		104
#define DMAMUX_SOURCE_FLEXPWM4_READ1		105
#define DMAMUX_SOURCE_FLEXPWM4_READ2		106
#define DMAMUX_SOURCE_FLEXPWM4_READ3		107
#define DMAMUX_SOURCE_FLEXPWM4_WRITE0		108
#define DMAMUX_SOURCE_FLEXPWM4_WRITE1		109
#define DMAMUX_SOURCE_FLEXPWM4_WRITE2		110
#define DMAMUX_SOURCE_FLEXPWM4_WRITE3		111
#define DMAMUX_SOURCE_QTIMER2_READ0		112
#define DMAMUX_SOURCE_QTIMER2_READ1		113
#define DMAMUX_SOURCE_QTIMER2_READ2		114
#define DMAMUX_SOURCE_QTIMER2_READ3		115
#define DMAMUX_SOURCE_QTIMER2_WRITE0_CMPLD1	116
#define DMAMUX_SOURCE_QTIMER2_WRITE1_CMPLD1	117
#define DMAMUX_SOURCE_QTIMER2_WRITE2_CMPLD1	118
#define DMAMUX_SOURCE_QTIMER2_WRITE3_CMPLD1	119
#define DMAMUX_SOURCE_QTIMER2_WRITE1_CMPLD2	116
#define DMAMUX_SOURCE_QTIMER2_WRITE0_CMPLD2	117
#define DMAMUX_SOURCE_QTIMER2_WRITE3_CMPLD2	118
#define DMAMUX_SOURCE_QTIMER2_WRITE2_CMPLD2	119
#define DMAMUX_SOURCE_QTIMER4_READ0		120
#define DMAMUX_SOURCE_QTIMER4_READ1		121
#define DMAMUX_SOURCE_QTIMER4_READ2		122
#define DMAMUX_SOURCE_QTIMER4_READ3		123
#define DMAMUX_SOURCE_QTIMER4_WRITE0_CMPLD1	120
#define DMAMUX_SOURCE_QTIMER4_WRITE1_CMPLD1	121
#define DMAMUX_SOURCE_QTIMER4_WRITE2_CMPLD1	122
#define DMAMUX_SOURCE_QTIMER4_WRITE3_CMPLD1	123
#define DMAMUX_SOURCE_QTIMER4_WRITE1_CMPLD2	120
#define DMAMUX_SOURCE_QTIMER4_WRITE0_CMPLD2	121
#define DMAMUX_SOURCE_QTIMER4_WRITE3_CMPLD2	122
#define DMAMUX_SOURCE_QTIMER4_WRITE2_CMPLD2	123
#define DMAMUX_SOURCE_ENET2_TIMER0		124
#define DMAMUX_SOURCE_ENET2_TIMER1		125


typedef struct {
	volatile uint32_t offset000;
	volatile uint32_t offset004;
	volatile uint32_t offset008;
	volatile uint32_t offset00C;
	volatile uint32_t offset010;
	volatile uint32_t offset014;
	volatile uint32_t offset018;
	volatile uint32_t offset01C;
	volatile uint32_t offset020;
	volatile uint32_t offset024;
	volatile uint32_t offset028;
	volatile uint32_t offset02C;
	volatile uint32_t offset030;
	volatile uint32_t offset034;
	volatile uint32_t offset038;
	volatile uint32_t offset03C;
	volatile uint32_t offset040;
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
	volatile uint16_t offset17C;
	volatile uint16_t offset17E;
	volatile uint16_t offset180;
	volatile uint16_t offset182;
	volatile uint16_t offset184;
	volatile uint16_t offset186;
	volatile uint16_t offset188;
	volatile uint16_t offset18A;
	volatile uint16_t offset18C;
	volatile uint16_t offset18E;
	volatile uint16_t offset190;
	volatile uint16_t offset192;
	volatile uint16_t offset194;
	volatile uint16_t offset196;
	volatile uint16_t offset198;
	volatile uint16_t offset19A;
	volatile uint16_t offset19C;
	volatile uint16_t offset19E;
	volatile uint16_t offset1A0;
	volatile uint16_t offset1A2;
	volatile uint16_t offset1A4;
	volatile uint16_t offset1A6;
	volatile uint16_t offset1A8;
	volatile uint16_t offset1AA;
	volatile uint16_t offset1AC;
	volatile uint16_t offset1AE;
	volatile uint16_t offset1B0;
	volatile uint16_t offset1B2;
	volatile uint16_t offset1B4;
	volatile uint16_t offset1B6;
	volatile uint16_t offset1B8;
	volatile uint16_t offset1BA;
	volatile uint16_t offset1BC;
	volatile uint16_t offset1BE;
	volatile uint16_t offset1C0;
	volatile uint16_t offset1C2;
	volatile uint16_t offset1C4;
	volatile uint16_t offset1C6;
	volatile uint16_t offset1C8;
	volatile uint16_t offset1CA;
	volatile uint16_t offset1CC;
	volatile uint16_t offset1CE;
	volatile uint16_t offset1D0;
	volatile uint16_t offset1D2;
	volatile uint16_t offset1D4;
	volatile uint16_t offset1D6;
	volatile uint16_t offset1D8;
	volatile uint16_t offset1DA;
	volatile uint16_t offset1DC;
	volatile uint16_t offset1DE;
	volatile uint16_t offset1E0;
	volatile uint16_t offset1E2;
	volatile uint16_t offset1E4;
	volatile uint16_t offset1E6;
	volatile uint16_t offset1E8;
	volatile uint16_t offset1EA;
	volatile uint16_t offset1EC;
	volatile uint16_t offset1EE;
	volatile uint16_t offset1F0;
	volatile uint16_t offset1F2;
	volatile uint16_t offset1F4;
	volatile uint16_t offset1F6;
	volatile uint16_t offset1F8;
	volatile uint16_t offset1FA;
	volatile uint16_t offset1FC;
	volatile uint16_t offset1FE;
} IMXRT_REGISTER16_t;

typedef struct {
	volatile uint8_t offset00;
	volatile uint8_t offset01;
	volatile uint8_t offset02;
	volatile uint8_t offset03;
	volatile uint8_t offset04;
	volatile uint8_t offset05;
	volatile uint8_t offset06;
	volatile uint8_t offset07;
	volatile uint8_t offset08;
	volatile uint8_t offset09;
	volatile uint8_t offset0A;
	volatile uint8_t offset0B;
	volatile uint8_t offset0C;
	volatile uint8_t offset0D;
	volatile uint8_t offset0E;
	volatile uint8_t offset0F;
} IMXRT_REGISTER8_t;

// 13.3: page 456
#define IMXRT_CMP1		(*(IMXRT_REGISTER8_t *)0x40094000)
#define CMP1_CR0			(IMXRT_CMP1.offset00)
#define CMP1_CR1			(IMXRT_CMP1.offset01)
#define CMP1_FPR			(IMXRT_CMP1.offset02)
#define CMP1_SCR			(IMXRT_CMP1.offset03)
#define CMP1_DACCR			(IMXRT_CMP1.offset04)
#define CMP1_MUXCR			(IMXRT_CMP1.offset05)
#define IMXRT_CMP2		(*(IMXRT_REGISTER8_t *)0x40094008)
#define CMP2_CR0			(IMXRT_CMP2.offset00)
#define CMP2_CR1			(IMXRT_CMP2.offset01)
#define CMP2_FPR			(IMXRT_CMP2.offset02)
#define CMP2_SCR			(IMXRT_CMP2.offset03)
#define CMP2_DACCR			(IMXRT_CMP2.offset04)
#define CMP2_MUXCR			(IMXRT_CMP2.offset05)
#define IMXRT_CMP3		(*(IMXRT_REGISTER8_t *)0x40094010)
#define CMP3_CR0			(IMXRT_CMP3.offset00)
#define CMP3_CR1			(IMXRT_CMP3.offset01)
#define CMP3_FPR			(IMXRT_CMP3.offset02)
#define CMP3_SCR			(IMXRT_CMP3.offset03)
#define CMP3_DACCR			(IMXRT_CMP3.offset04)
#define CMP3_MUXCR			(IMXRT_CMP3.offset05)
#define IMXRT_CMP4		(*(IMXRT_REGISTER8_t *)0x40094018)
#define CMP4_CR0			(IMXRT_CMP4.offset00)
#define CMP4_CR1			(IMXRT_CMP4.offset01)
#define CMP4_FPR			(IMXRT_CMP4.offset02)
#define CMP4_SCR			(IMXRT_CMP4.offset03)
#define CMP4_DACCR			(IMXRT_CMP4.offset04)
#define CMP4_MUXCR			(IMXRT_CMP4.offset05)

// 14.6: page 505
#define IMXRT_ADC1		(*(IMXRT_REGISTER32_t *)0x400C4000)
#define ADC1_HC0			(IMXRT_ADC1.offset000)
#define ADC1_HC1			(IMXRT_ADC1.offset004)
#define ADC1_HC2			(IMXRT_ADC1.offset008)
#define ADC1_HC3			(IMXRT_ADC1.offset00C)
#define ADC1_HC4			(IMXRT_ADC1.offset010)
#define ADC1_HC5			(IMXRT_ADC1.offset014)
#define ADC1_HC6			(IMXRT_ADC1.offset018)
#define ADC1_HC7			(IMXRT_ADC1.offset01C)
#define ADC1_HS				(IMXRT_ADC1.offset020)
#define ADC1_R0				(IMXRT_ADC1.offset024)
#define ADC1_R1				(IMXRT_ADC1.offset028)
#define ADC1_R2				(IMXRT_ADC1.offset02C)
#define ADC1_R3				(IMXRT_ADC1.offset030)
#define ADC1_R4				(IMXRT_ADC1.offset034)
#define ADC1_R5				(IMXRT_ADC1.offset038)
#define ADC1_R6				(IMXRT_ADC1.offset03C)
#define ADC1_R7				(IMXRT_ADC1.offset040)
#define ADC1_CFG			(IMXRT_ADC1.offset044)
#define ADC1_GC				(IMXRT_ADC1.offset048)
#define ADC1_GS				(IMXRT_ADC1.offset04C)
#define ADC1_CV				(IMXRT_ADC1.offset050)
#define ADC1_OFS			(IMXRT_ADC1.offset054)
#define ADC1_CAL			(IMXRT_ADC1.offset058)
#define IMXRT_ADC2		(*(IMXRT_REGISTER32_t *)0x400C8000)
#define ADC2_HC0			(IMXRT_ADC2.offset000)
#define ADC2_HC1			(IMXRT_ADC2.offset004)
#define ADC2_HC2			(IMXRT_ADC2.offset008)
#define ADC2_HC3			(IMXRT_ADC2.offset00C)
#define ADC2_HC4			(IMXRT_ADC2.offset010)
#define ADC2_HC5			(IMXRT_ADC2.offset014)
#define ADC2_HC6			(IMXRT_ADC2.offset018)
#define ADC2_HC7			(IMXRT_ADC2.offset01C)
#define ADC2_HS				(IMXRT_ADC2.offset020)
#define ADC2_R0				(IMXRT_ADC2.offset024)
#define ADC2_R1				(IMXRT_ADC2.offset028)
#define ADC2_R2				(IMXRT_ADC2.offset02C)
#define ADC2_R3				(IMXRT_ADC2.offset030)
#define ADC2_R4				(IMXRT_ADC2.offset034)
#define ADC2_R5				(IMXRT_ADC2.offset038)
#define ADC2_R6				(IMXRT_ADC2.offset03C)
#define ADC2_R7				(IMXRT_ADC2.offset040)
#define ADC2_CFG			(IMXRT_ADC2.offset044)
#define ADC2_GC				(IMXRT_ADC2.offset048)
#define ADC2_GS				(IMXRT_ADC2.offset04C)
#define ADC2_CV				(IMXRT_ADC2.offset050)
#define ADC2_OFS			(IMXRT_ADC2.offset054)
#define ADC2_CAL			(IMXRT_ADC2.offset058)
#define ADC_HC_AIEN				((uint32_t)(1<<7))
#define ADC_HC_ADCH(n)				((uint32_t)(((n) & 0x1F) << 0))
#define ADC_HS_COCO0				((uint32_t)(1<<0))
#define ADC_CFG_OVWREN				((uint32_t)(1<<16))
#define ADC_CFG_AVGS(n)				((uint32_t)(((n) & 0x03) << 14))
#define ADC_CFG_ADTRG				((uint32_t)(1<<13))
#define ADC_CFG_REFSEL(n)			((uint32_t)(((n) & 0x03) << 11))
#define ADC_CFG_ADHSC				((uint32_t)(1<<10))
#define ADC_CFG_ADSTS(n)			((uint32_t)(((n) & 0x03) << 8))
#define ADC_CFG_ADLPC				((uint32_t)(1<<7))
#define ADC_CFG_ADIV(n)				((uint32_t)(((n) & 0x03) << 5))
#define ADC_CFG_ADLSMP				((uint32_t)(1<<4))
#define ADC_CFG_MODE(n)				((uint32_t)(((n) & 0x03) << 2))
#define ADC_CFG_ADICLK(n)			((uint32_t)(((n) & 0x03) << 0))
#define ADC_GC_CAL				((uint32_t)(1<<7))
#define ADC_GC_ADCO				((uint32_t)(1<<6))
#define ADC_GC_AVGE				((uint32_t)(1<<5))
#define ADC_GC_ACFE				((uint32_t)(1<<4))
#define ADC_GC_ACFGT				((uint32_t)(1<<3))
#define ADC_GC_ACREN				((uint32_t)(1<<2))
#define ADC_GC_DMAEN				((uint32_t)(1<<1))
#define ADC_GC_ADACKEN				((uint32_t)(1<<0))
#define ADC_GS_AWKST				((uint32_t)(1<<2))
#define ADC_GS_CALF				((uint32_t)(1<<1))
#define ADC_GS_ADACT				((uint32_t)(1<<0))
#define ADC_CV_CV2(n)				((uint32_t)(((n) & 0xFFF) << 16))
#define ADC_CV_CV1(n)				((uint32_t)(((n) & 0xFFF) << 0))
#define ADC_OFS_SIGN				((uint32_t)(1<<12))
#define ADC_OFS_OFS(n)				((uint32_t)(((n) & 0xFFF) << 0))
#define ADC_CAL_CAL_CODE(n)			((uint32_t)(((n) & 0x0F) << 0))

// 15.4.1.1: page 527
#define IMXRT_ADC_ETC		(*(IMXRT_REGISTER32_t *)0x403B0000)
#define ADC_ETC_CTRL			(IMXRT_ADC_ETC.offset000)
#define ADC_ETC_DONE0_1_IRQ		(IMXRT_ADC_ETC.offset004)
#define ADC_ETC_DONE2_ERR_IRQ		(IMXRT_ADC_ETC.offset008)
#define ADC_ETC_DMA_CTRL		(IMXRT_ADC_ETC.offset00C)
#define ADC_ETC_TRIG0_CTRL		(IMXRT_ADC_ETC.offset010)
#define ADC_ETC_TRIG0_COUNTER		(IMXRT_ADC_ETC.offset014)
#define ADC_ETC_TRIG0_CHAIN_1_0		(IMXRT_ADC_ETC.offset018)
#define ADC_ETC_TRIG0_CHAIN_3_2		(IMXRT_ADC_ETC.offset01C)
#define ADC_ETC_TRIG0_CHAIN_5_4		(IMXRT_ADC_ETC.offset020)
#define ADC_ETC_TRIG0_CHAIN_7_6		(IMXRT_ADC_ETC.offset024)
#define ADC_ETC_TRIG0_RESULT_1_0	(IMXRT_ADC_ETC.offset028)
#define ADC_ETC_TRIG0_RESULT_3_2	(IMXRT_ADC_ETC.offset02C)
#define ADC_ETC_TRIG0_RESULT_5_4	(IMXRT_ADC_ETC.offset030)
#define ADC_ETC_TRIG0_RESULT_7_6	(IMXRT_ADC_ETC.offset034)
#define ADC_ETC_TRIG1_CTRL		(IMXRT_ADC_ETC.offset038)
#define ADC_ETC_TRIG1_COUNTER		(IMXRT_ADC_ETC.offset03C)
#define ADC_ETC_TRIG1_CHAIN_1_0		(IMXRT_ADC_ETC.offset040)
#define ADC_ETC_TRIG1_CHAIN_3_2		(IMXRT_ADC_ETC.offset044)
#define ADC_ETC_TRIG1_CHAIN_5_4		(IMXRT_ADC_ETC.offset048)
#define ADC_ETC_TRIG1_CHAIN_7_6		(IMXRT_ADC_ETC.offset04C)
#define ADC_ETC_TRIG1_RESULT_1_0	(IMXRT_ADC_ETC.offset050)
#define ADC_ETC_TRIG1_RESULT_3_2	(IMXRT_ADC_ETC.offset054)
#define ADC_ETC_TRIG1_RESULT_5_4	(IMXRT_ADC_ETC.offset058)
#define ADC_ETC_TRIG1_RESULT_7_6	(IMXRT_ADC_ETC.offset05C)
#define ADC_ETC_TRIG2_CTRL		(IMXRT_ADC_ETC.offset060)
#define ADC_ETC_TRIG2_COUNTER		(IMXRT_ADC_ETC.offset064)
#define ADC_ETC_TRIG2_CHAIN_1_0		(IMXRT_ADC_ETC.offset068)
#define ADC_ETC_TRIG2_CHAIN_3_2		(IMXRT_ADC_ETC.offset06C)
#define ADC_ETC_TRIG2_CHAIN_5_4		(IMXRT_ADC_ETC.offset070)
#define ADC_ETC_TRIG2_CHAIN_7_6		(IMXRT_ADC_ETC.offset074)
#define ADC_ETC_TRIG2_RESULT_1_0	(IMXRT_ADC_ETC.offset078)
#define ADC_ETC_TRIG2_RESULT_3_2	(IMXRT_ADC_ETC.offset07C)
#define ADC_ETC_TRIG2_RESULT_5_4	(IMXRT_ADC_ETC.offset080)
#define ADC_ETC_TRIG2_RESULT_7_6	(IMXRT_ADC_ETC.offset084)
#define ADC_ETC_TRIG3_CTRL		(IMXRT_ADC_ETC.offset088)
#define ADC_ETC_TRIG3_COUNTER		(IMXRT_ADC_ETC.offset08C)
#define ADC_ETC_TRIG3_CHAIN_1_0		(IMXRT_ADC_ETC.offset090)
#define ADC_ETC_TRIG3_CHAIN_3_2		(IMXRT_ADC_ETC.offset094)
#define ADC_ETC_TRIG3_CHAIN_5_4		(IMXRT_ADC_ETC.offset098)
#define ADC_ETC_TRIG3_CHAIN_7_6		(IMXRT_ADC_ETC.offset09C)
#define ADC_ETC_TRIG3_RESULT_1_0	(IMXRT_ADC_ETC.offset0A0)
#define ADC_ETC_TRIG3_RESULT_3_2	(IMXRT_ADC_ETC.offset0A4)
#define ADC_ETC_TRIG3_RESULT_5_4	(IMXRT_ADC_ETC.offset0A8)
#define ADC_ETC_TRIG3_RESULT_7_6	(IMXRT_ADC_ETC.offset0AC)
#define ADC_ETC_TRIG4_CTRL		(IMXRT_ADC_ETC.offset0B0)
#define ADC_ETC_TRIG4_COUNTER		(IMXRT_ADC_ETC.offset0B4)
#define ADC_ETC_TRIG4_CHAIN_1_0		(IMXRT_ADC_ETC.offset0B8)
#define ADC_ETC_TRIG4_CHAIN_3_2		(IMXRT_ADC_ETC.offset0BC)
#define ADC_ETC_TRIG4_CHAIN_5_4		(IMXRT_ADC_ETC.offset0C0)
#define ADC_ETC_TRIG4_CHAIN_7_6		(IMXRT_ADC_ETC.offset0C4)
#define ADC_ETC_TRIG4_RESULT_1_0	(IMXRT_ADC_ETC.offset0C8)
#define ADC_ETC_TRIG4_RESULT_3_2	(IMXRT_ADC_ETC.offset0CC)
#define ADC_ETC_TRIG4_RESULT_5_4	(IMXRT_ADC_ETC.offset0D0)
#define ADC_ETC_TRIG4_RESULT_7_6	(IMXRT_ADC_ETC.offset0D4)
#define ADC_ETC_TRIG5_CTRL		(IMXRT_ADC_ETC.offset0D8)
#define ADC_ETC_TRIG5_COUNTER		(IMXRT_ADC_ETC.offset0DC)
#define ADC_ETC_TRIG5_CHAIN_1_0		(IMXRT_ADC_ETC.offset0E0)
#define ADC_ETC_TRIG5_CHAIN_3_2		(IMXRT_ADC_ETC.offset0E4)
#define ADC_ETC_TRIG5_CHAIN_5_4		(IMXRT_ADC_ETC.offset0E8)
#define ADC_ETC_TRIG5_CHAIN_7_6		(IMXRT_ADC_ETC.offset0EC)
#define ADC_ETC_TRIG5_RESULT_1_0	(IMXRT_ADC_ETC.offset0F0)
#define ADC_ETC_TRIG5_RESULT_3_2	(IMXRT_ADC_ETC.offset0F4)
#define ADC_ETC_TRIG5_RESULT_5_4	(IMXRT_ADC_ETC.offset0F8)
#define ADC_ETC_TRIG5_RESULT_7_6	(IMXRT_ADC_ETC.offset0FC)
#define ADC_ETC_TRIG6_CTRL		(IMXRT_ADC_ETC.offset100)
#define ADC_ETC_TRIG6_COUNTER		(IMXRT_ADC_ETC.offset104)
#define ADC_ETC_TRIG6_CHAIN_1_0		(IMXRT_ADC_ETC.offset108)
#define ADC_ETC_TRIG6_CHAIN_3_2		(IMXRT_ADC_ETC.offset10C)
#define ADC_ETC_TRIG6_CHAIN_5_4		(IMXRT_ADC_ETC.offset110)
#define ADC_ETC_TRIG6_CHAIN_7_6		(IMXRT_ADC_ETC.offset114)
#define ADC_ETC_TRIG6_RESULT_1_0	(IMXRT_ADC_ETC.offset118)
#define ADC_ETC_TRIG6_RESULT_3_2	(IMXRT_ADC_ETC.offset11C)
#define ADC_ETC_TRIG6_RESULT_5_4	(IMXRT_ADC_ETC.offset120)
#define ADC_ETC_TRIG6_RESULT_7_6	(IMXRT_ADC_ETC.offset124)
#define ADC_ETC_TRIG7_CTRL		(IMXRT_ADC_ETC.offset128)
#define ADC_ETC_TRIG7_COUNTER		(IMXRT_ADC_ETC.offset12C)
#define ADC_ETC_TRIG7_CHAIN_1_0		(IMXRT_ADC_ETC.offset130)
#define ADC_ETC_TRIG7_CHAIN_3_2		(IMXRT_ADC_ETC.offset134)
#define ADC_ETC_TRIG7_CHAIN_5_4		(IMXRT_ADC_ETC.offset138)
#define ADC_ETC_TRIG7_CHAIN_7_6		(IMXRT_ADC_ETC.offset13C)
#define ADC_ETC_TRIG7_RESULT_1_0	(IMXRT_ADC_ETC.offset140)
#define ADC_ETC_TRIG7_RESULT_3_2	(IMXRT_ADC_ETC.offset144)
#define ADC_ETC_TRIG7_RESULT_5_4	(IMXRT_ADC_ETC.offset148)
#define ADC_ETC_TRIG7_RESULT_7_6	(IMXRT_ADC_ETC.offset14C)

// 16.7: page 640
#define IMXRT_AIPSTZ1		(*(IMXRT_REGISTER32_t *)0x4007C000)
#define AIPSTZ1_MPR			(IMXRT_AIPSTZ1.offset000)
#define AIPSTZ1_OPACR			(IMXRT_AIPSTZ1.offset040)
#define AIPSTZ1_OPACR1			(IMXRT_AIPSTZ1.offset044)
#define AIPSTZ1_OPACR2			(IMXRT_AIPSTZ1.offset048)
#define AIPSTZ1_OPACR3			(IMXRT_AIPSTZ1.offset04C)
#define AIPSTZ1_OPACR4			(IMXRT_AIPSTZ1.offset050)
#define IMXRT_AIPSTZ2		(*(IMXRT_REGISTER32_t *)0x4017C000)
#define AIPSTZ2_MPR			(IMXRT_AIPSTZ2.offset000)
#define AIPSTZ2_OPACR			(IMXRT_AIPSTZ2.offset040)
#define AIPSTZ2_OPACR1			(IMXRT_AIPSTZ2.offset044)
#define AIPSTZ2_OPACR2			(IMXRT_AIPSTZ2.offset048)
#define AIPSTZ2_OPACR3			(IMXRT_AIPSTZ2.offset04C)
#define AIPSTZ2_OPACR4			(IMXRT_AIPSTZ2.offset050)
#define IMXRT_AIPSTZ3		(*(IMXRT_REGISTER32_t *)0x4027C000)
#define AIPSTZ3_MPR			(IMXRT_AIPSTZ3.offset000)
#define AIPSTZ3_OPACR			(IMXRT_AIPSTZ3.offset040)
#define AIPSTZ3_OPACR1			(IMXRT_AIPSTZ3.offset044)
#define AIPSTZ3_OPACR2			(IMXRT_AIPSTZ3.offset048)
#define AIPSTZ3_OPACR3			(IMXRT_AIPSTZ3.offset04C)
#define AIPSTZ3_OPACR4			(IMXRT_AIPSTZ3.offset050)
#define IMXRT_AIPSTZ4		(*(IMXRT_REGISTER32_t *)0x4037C000)
#define AIPSTZ4_MPR			(IMXRT_AIPSTZ4.offset000)
#define AIPSTZ4_OPACR			(IMXRT_AIPSTZ4.offset040)
#define AIPSTZ4_OPACR1			(IMXRT_AIPSTZ4.offset044)
#define AIPSTZ4_OPACR2			(IMXRT_AIPSTZ4.offset048)
#define AIPSTZ4_OPACR3			(IMXRT_AIPSTZ4.offset04C)
#define AIPSTZ4_OPACR4			(IMXRT_AIPSTZ4.offset050)

// 17.3: page 662
#define IMXRT_AOI1		(*(IMXRT_REGISTER16_t *)0x403B4000)
#define AOI1_BFCRT010			(IMXRT_AOI1.offset000)
#define AOI1_BFCRT230			(IMXRT_AOI1.offset002)
#define AOI1_BFCRT011			(IMXRT_AOI1.offset004)
#define AOI1_BFCRT231			(IMXRT_AOI1.offset006)
#define AOI1_BFCRT012			(IMXRT_AOI1.offset008)
#define AOI1_BFCRT232			(IMXRT_AOI1.offset00A)
#define AOI1_BFCRT013			(IMXRT_AOI1.offset00C)
#define AOI1_BFCRT233			(IMXRT_AOI1.offset00E)
#define IMXRT_AOI2		(*(IMXRT_REGISTER16_t *)0x403B8000)
#define AOI2_BFCRT010			(IMXRT_AOI2.offset000)
#define AOI2_BFCRT230			(IMXRT_AOI2.offset002)
#define AOI2_BFCRT011			(IMXRT_AOI2.offset004)
#define AOI2_BFCRT231			(IMXRT_AOI2.offset006)
#define AOI2_BFCRT012			(IMXRT_AOI2.offset008)
#define AOI2_BFCRT232			(IMXRT_AOI2.offset00A)
#define AOI2_BFCRT013			(IMXRT_AOI2.offset00C)
#define AOI2_BFCRT233			(IMXRT_AOI2.offset00E)

// 18.7: page 703
#define IMXRT_CCM		(*(IMXRT_REGISTER32_t *)0x400FC000)
#define CCM_CCR				(IMXRT_CCM.offset000)
#define CCM_CSR				(IMXRT_CCM.offset008)
#define CCM_CCSR			(IMXRT_CCM.offset00C)
#define CCM_CACRR			(IMXRT_CCM.offset010)
#define CCM_CBCDR			(IMXRT_CCM.offset014)
#define CCM_CBCMR			(IMXRT_CCM.offset018)
#define CCM_CSCMR1			(IMXRT_CCM.offset01C)
#define CCM_CSCMR2			(IMXRT_CCM.offset020)
#define CCM_CSCDR1			(IMXRT_CCM.offset024)
#define CCM_CS1CDR			(IMXRT_CCM.offset028)
#define CCM_CS2CDR			(IMXRT_CCM.offset02C)
#define CCM_CDCDR			(IMXRT_CCM.offset030)
#define CCM_CSCDR2			(IMXRT_CCM.offset038)
#define CCM_CSCDR3			(IMXRT_CCM.offset03C)
#define CCM_CDHIPR			(IMXRT_CCM.offset048)
#define CCM_CLPCR			(IMXRT_CCM.offset054)
#define CCM_CISR			(IMXRT_CCM.offset058)
#define CCM_CIMR			(IMXRT_CCM.offset05C)
#define CCM_CCOSR			(IMXRT_CCM.offset060)
#define CCM_CGPR			(IMXRT_CCM.offset064)
#define CCM_CCGR0			(IMXRT_CCM.offset068)
#define CCM_CCGR1			(IMXRT_CCM.offset06C)
#define CCM_CCGR2			(IMXRT_CCM.offset070)
#define CCM_CCGR3			(IMXRT_CCM.offset074)
#define CCM_CCGR4			(IMXRT_CCM.offset078)
#define CCM_CCGR5			(IMXRT_CCM.offset07C)
#define CCM_CCGR6			(IMXRT_CCM.offset080)
#define CCM_CCGR7			(IMXRT_CCM.offset084)
#define CCM_CMEOR			(IMXRT_CCM.offset088)
#define CCM_CCR_RBC_EN				((uint32_t)(1<<27))
#define CCM_CCR_REG_BYPASS_COUNT(n)		((uint32_t)(((n) & 0x3F) << 21))
#define CCM_CCR_COSC_EN				((uint32_t)(1<<12))
#define CCM_CCR_OSCNT(n)			((uint32_t)(((n) & 0xFF) << 0))
#define CCM_CSR_COSC_READY			((uint32_t)(1<<5))
#define CCM_CSR_CAMP2_READY			((uint32_t)(1<<3))
#define CCM_CSR_REF_EN_B			((uint32_t)(1<<0))
#define CCM_CCSR_PLL3_SW_CLK_SEL		((uint32_t)(1<<0))
#define CCM_CACRR_ARM_PODF(n)			((uint32_t)(((n) & 0x07) << 0))
#define CCM_CACRR_ARM_PODF_MASK			((uint32_t)(0x07 << 0))
#define CCM_CBCDR_PERIPH_CLK2_PODF(n)		((uint32_t)(((n) & 0x07) << 27))
#define CCM_CBCDR_PERIPH_CLK2_PODF_MASK		((uint32_t)(0x07 << 27))
#define CCM_CBCDR_PERIPH_CLK_SEL		((uint32_t)(1<<25))
#define CCM_CBCDR_SEMC_PODF(n)			((uint32_t)(((n) & 0x07) << 16))
#define CCM_CBCDR_AHB_PODF(n)			((uint32_t)(((n) & 0x07) << 10))
#define CCM_CBCDR_AHB_PODF_MASK			((uint32_t)(0x07 << 10))
#define CCM_CBCDR_IPG_PODF(n)			((uint32_t)(((n) & 0x03) << 8))
#define CCM_CBCDR_IPG_PODF_MASK			((uint32_t)(0x03 << 8))
#define CCM_CBCDR_SEMC_ALT_CLK_SEL		((uint32_t)(1<<7))
#define CCM_CBCDR_SEMC_CLK_SEL			((uint32_t)(1<<6))
#define CCM_CBCMR_LPSPI_PODF(n)			((uint32_t)(((n) & 0x07) << 26))
#define CCM_CBCMR_LCDIF_PODF(n)			((uint32_t)(((n) & 0x07) << 23))
#define CCM_CBCMR_PRE_PERIPH_CLK_SEL(n)		((uint32_t)(((n) & 0x03) << 18))
#define CCM_CBCMR_TRACE_CLK_SEL(n)		((uint32_t)(((n) & 0x03) << 14))
#define CCM_CBCMR_PERIPH_CLK2_SEL(n)		((uint32_t)(((n) & 0x03) << 12))
#define CCM_CBCMR_PERIPH_CLK2_SEL_MASK		((uint32_t)(0x03 << 12))
#define CCM_CBCMR_LPSPI_CLK_SEL(n)		((uint32_t)(((n) & 0x03) << 4))
#define CCM_CBCMR_LPSPI_PODF_MASK		((uint32_t)(0x07 << 26))
#define CCM_CBCMR_LCDIF_PODF_MASK		((uint32_t)(0x07 << 23))
#define CCM_CBCMR_PRE_PERIPH_CLK_SEL_MASK	((uint32_t)(0x03 << 18))
#define CCM_CBCMR_TRACE_CLK_SEL_MASK		((uint32_t)(0x03 << 14))
#define CCM_CBCMR_LPSPI_CLK_SEL_MASK		((uint32_t)(0x03 << 4))
#define CCM_CSCMR1_FLEXSPI_CLK_SEL(n)		((uint32_t)(((n) & 0x03) << 29))
#define CCM_CSCMR1_FLEXSPI_PODF(n)		((uint32_t)(((n) & 0x07) << 23))
#define CCM_CSCMR1_USDHC2_CLK_SEL		((uint32_t)(1<<17))
#define CCM_CSCMR1_USDHC1_CLK_SEL		((uint32_t)(1<<16))
#define CCM_CSCMR1_SAI3_CLK_SEL(n)		((uint32_t)(((n) & 0x03) << 14))
#define CCM_CSCMR1_SAI2_CLK_SEL(n)		((uint32_t)(((n) & 0x03) << 12))
#define CCM_CSCMR1_SAI1_CLK_SEL(n)		((uint32_t)(((n) & 0x03) << 10))
#define CCM_CSCMR1_PERCLK_CLK_SEL		((uint32_t)(1<<6))
#define CCM_CSCMR1_PERCLK_PODF(n)		((uint32_t)(((n) & 0x3F) << 0))
#define CCM_CSCMR2_FLEXIO2_CLK_SEL(n)		((uint32_t)(((n) & 0x03) << 19))
#define CCM_CSCMR2_CAN_CLK_SEL(n)		((uint32_t)(((n) & 0x03) << 8))
#define CCM_CSCMR2_CAN_CLK_PODF(n)		((uint32_t)(((n) & 0x3F) << 2))
#define CCM_CSCDR1_TRACE_PODF(n)		((uint32_t)(((n) & 0x07) << 25))
#define CCM_CSCDR1_USDHC2_PODF(n)		((uint32_t)(((n) & 0x07) << 16))
#define CCM_CSCDR1_USDHC1_PODF(n)		((uint32_t)(((n) & 0x07) << 11))
#define CCM_CSCDR1_UART_CLK_SEL			((uint32_t)(1<<6))
#define CCM_CSCDR1_UART_CLK_PODF(n)		((uint32_t)(((n) & 0x3F) << 0))
#define CCM_CS1CDR_FLEXIO2_CLK_PODF(n)		((uint32_t)(((n) & 0x07) << 25))
#define CCM_CS1CDR_SAI3_CLK_PRED(n)		((uint32_t)(((n) & 0x07) << 22))
#define CCM_CS1CDR_SAI3_CLK_PODF(n)		((uint32_t)(((n) & 0x3F) << 16))
#define CCM_CS1CDR_FLEXIO2_CLK_PRED(n)		((uint32_t)(((n) & 0x07) << 9))
#define CCM_CS1CDR_SAI1_CLK_PRED(n)		((uint32_t)(((n) & 0x07) << 6))
#define CCM_CS1CDR_SAI1_CLK_PODF(n)		((uint32_t)(((n) & 0x3F) << 0))
#define CCM_CS2CDR_SAI2_CLK_PRED(n)		((uint32_t)(((n) & 0x07) << 6))
#define CCM_CS2CDR_SAI2_CLK_PODF(n)		((uint32_t)(((n) & 0x3F) << 0))
#define CCM_CDCDR_SPDIF0_CLK_PRED(n)		((uint32_t)(((n) & 0x07) << 25))
#define CCM_CDCDR_SPDIF0_CLK_PODF(n)		((uint32_t)(((n) & 0x07) << 22))
#define CCM_CDCDR_SPDIF0_CLK_SEL(n)		((uint32_t)(((n) & 0x03) << 20))
#define CCM_CDCDR_FLEXIO1_CLK_PRED(n)		((uint32_t)(((n) & 0x07) << 12))
#define CCM_CDCDR_FLEXIO1_CLK_PODF(n)		((uint32_t)(((n) & 0x07) << 9))
#define CCM_CDCDR_FLEXIO1_CLK_SEL(n)		((uint32_t)(((n) & 0x03) << 7))
#define CCM_CSCDR2_LPI2C_CLK_PODF(n)		((uint32_t)(((n) & 0x1F) << 19))
#define CCM_CSCDR2_LPI2C_CLK_SEL		((uint32_t)(1<<18))
#define CCM_CSCDR2_LCDIF_PRE_CLK_SEL(n)		((uint32_t)(((n) & 0x07) << 15))
#define CCM_CSCDR2_LCDIF_PRED(n)		((uint32_t)(((n) & 0x07) << 12))
#define CCM_CSCDR2_LCDIF_CLK_SEL(n)		((uint32_t)(((n) & 0x07) << 9))
#define CCM_CSCDR3_CSI_PODF(n)			((uint32_t)(((n) & 0x07) << 11))
#define CCM_CSCDR3_CSI_CLK_SEL(n)		((uint32_t)(((n) & 0x03) << 9))
#define CCM_CDHIPR_ARM_PODF_BUSY		((uint32_t)(1<<16))
#define CCM_CDHIPR_PERIPH_CLK_SEL_BUSY		((uint32_t)(1<<5))
#define CCM_CDHIPR_PERIPH2_CLK_SEL_BUSY		((uint32_t)(1<<3))
#define CCM_CDHIPR_AHB_PODF_BUSY		((uint32_t)(1<<1))
#define CCM_CDHIPR_SEMC_PODF_BUSY		((uint32_t)(1<<0))
#define CCM_CLPCR_MASK_L2CC_IDLE		((uint32_t)(1<<27))
#define CCM_CLPCR_MASK_SCU_IDLE			((uint32_t)(1<<26))
#define CCM_CLPCR_MASK_CORE0_WFI		((uint32_t)(1<<22))
#define CCM_CLPCR_BYPASS_LPM_HS0		((uint32_t)(1<<21))
#define CCM_CLPCR_BYPASS_LPM_HS1		((uint32_t)(1<<19))
#define CCM_CLPCR_COSC_PWRDOWN			((uint32_t)(1<<11))
#define CCM_CLPCR_STBY_COUNT(n)			((uint32_t)(((n) & 0x03) << 9))
#define CCM_CLPCR_VSTBY				((uint32_t)(1<<8))
#define CCM_CLPCR_DIS_REF_OSC			((uint32_t)(1<<7))
#define CCM_CLPCR_SBYOS				((uint32_t)(1<<6))
#define CCM_CLPCR_ARM_CLK_DIS_ON_LPM		((uint32_t)(1<<5))
#define CCM_CLPCR_LPM(n)			((uint32_t)(((n) & 0x03) << 0))
#define CCM_CISR_ARM_PODF_LOADED		((uint32_t)(1<<26))
#define CCM_CISR_PERIPH_CLK_SEL_LOADED		((uint32_t)(1<<22))
#define CCM_CISR_AHB_PODF_LOADED		((uint32_t)(1<<20))
#define CCM_CISR_PERIPH2_CLK_SEL_LOADED		((uint32_t)(1<<19))
#define CCM_CISR_SEMC_PODF_LOADED		((uint32_t)(1<<17))
#define CCM_CISR_COSC_READY			((uint32_t)(1<<6))
#define CCM_CISR_LRF_PLL			((uint32_t)(1<<0))
#define CCM_CIMR_ARM_PODF_LOADED		((uint32_t)(1<<26))
#define CCM_CIMR_MASK_PERIPH_CLK_SEL_LOADED	((uint32_t)(1<<22))
#define CCM_CIMR_MASK_AHB_PODF_LOADED		((uint32_t)(1<<20))
#define CCM_CIMR_MASK_PERIPH2_CLK_SEL_LOADED	((uint32_t)(1<<19))
#define CCM_CIMR_MASK_SEMC_PODF_LOADED		((uint32_t)(1<<17))
#define CCM_CIMR_MASK_COSC_READY		((uint32_t)(1<<6))
#define CCM_CIMR_MASK_LRF_PLL			((uint32_t)(1<<0))
#define CCM_CCOSR_CLKO2_EN			((uint32_t)(1<<24))
#define CCM_CCOSR_CLKO2_DIV(n)			((uint32_t)(((n) & 0x07) << 21))
#define CCM_CCOSR_CLKO2_SEL(n)			((uint32_t)(((n) & 0x1F) << 16))
#define CCM_CCOSR_CLK_OUT_SEL			((uint32_t)(1<<8))
#define CCM_CCOSR_CLKO1_EN			((uint32_t)(1<<7))
#define CCM_CCOSR_CLKO1_DIV(n)			((uint32_t)(((n) & 0x07) << 4))
#define CCM_CCOSR_CLKO1_SEL(n)			((uint32_t)(((n) & 0x0F) << 0))
#define CCM_CGPR_INT_MEM_CLK_LPM		((uint32_t)(1<<17))
#define CCM_CGPR_FPL				((uint32_t)(1<<16))
#define CCM_CGPR_SYS_MEM_DS_CTRL(n)		((uint32_t)(((n) & 0x03) << 14))
#define CCM_CGPR_EFUSE_PROG_SUPPLY_GATE		((uint32_t)(1<<4))
#define CCM_CGPR_PMIC_DELAY_SCALER		((uint32_t)(1<<0))
#define CCM_CCGR_OFF				0
#define CCM_CCGR_ON_RUNONLY			1
#define CCM_CCGR_ON				3
#define CCM_CCGR0_GPIO2(n)			((uint32_t)(((n) & 0x03) << 30))
#define CCM_CCGR0_LPUART2(n)			((uint32_t)(((n) & 0x03) << 28))
#define CCM_CCGR0_GPT2_SERIAL(n)		((uint32_t)(((n) & 0x03) << 26))
#define CCM_CCGR0_GPT2_BUS(n)			((uint32_t)(((n) & 0x03) << 24))
#define CCM_CCGR0_TRACE(n)			((uint32_t)(((n) & 0x03) << 22))
#define CCM_CCGR0_CAN2_SERIAL(n)		((uint32_t)(((n) & 0x03) << 20))
#define CCM_CCGR0_CAN2(n)			((uint32_t)(((n) & 0x03) << 18))
#define CCM_CCGR0_CAN1_SERIAL(n)		((uint32_t)(((n) & 0x03) << 16))
#define CCM_CCGR0_CAN1(n)			((uint32_t)(((n) & 0x03) << 14))
#define CCM_CCGR0_LPUART3(n)			((uint32_t)(((n) & 0x03) << 12))
#define CCM_CCGR0_DCP(n)			((uint32_t)(((n) & 0x03) << 10))
#define CCM_CCGR0_MQS_HMCLK(n)			((uint32_t)(((n) & 0x03) << 4))
#define CCM_CCGR0_AIPS_TZ2(n)			((uint32_t)(((n) & 0x03) << 2))
#define CCM_CCGR0_AIPS_TZ1(n)			((uint32_t)(((n) & 0x03) << 0))
#define CCM_CCGR1_CSU(n)			((uint32_t)(((n) & 0x03) << 28))
#define CCM_CCGR1_GPIO1(n)			((uint32_t)(((n) & 0x03) << 26))
#define CCM_CCGR1_LPUART4(n)			((uint32_t)(((n) & 0x03) << 24))
#define CCM_CCGR1_GPT_SERIAL(n)			((uint32_t)(((n) & 0x03) << 22))
#define CCM_CCGR1_GPT(n)			((uint32_t)(((n) & 0x03) << 20))
#define CCM_CCGR1_ADC1(n)			((uint32_t)(((n) & 0x03) << 16))
#define CCM_CCGR1_AOI2(n)			((uint32_t)(((n) & 0x03) << 14))
#define CCM_CCGR1_PIT(n)			((uint32_t)(((n) & 0x03) << 12))
#define CCM_CCGR1_ENET(n)			((uint32_t)(((n) & 0x03) << 10))
#define CCM_CCGR1_ADC2(n)			((uint32_t)(((n) & 0x03) << 8))
#define CCM_CCGR1_LPSPI4(n)			((uint32_t)(((n) & 0x03) << 6))
#define CCM_CCGR1_LPSPI3(n)			((uint32_t)(((n) & 0x03) << 4))
#define CCM_CCGR1_LPSPI2(n)			((uint32_t)(((n) & 0x03) << 2))
#define CCM_CCGR1_LPSPI1(n)			((uint32_t)(((n) & 0x03) << 0))
#define CCM_CCGR2_PXP(n)			((uint32_t)(((n) & 0x03) << 30))
#define CCM_CCGR2_LCD(n)			((uint32_t)(((n) & 0x03) << 28))
#define CCM_CCGR2_GPIO3(n)			((uint32_t)(((n) & 0x03) << 26))
#define CCM_CCGR2_XBAR2(n)			((uint32_t)(((n) & 0x03) << 24))
#define CCM_CCGR2_XBAR1(n)			((uint32_t)(((n) & 0x03) << 22))
#define CCM_CCGR2_IPMUX3(n)			((uint32_t)(((n) & 0x03) << 20))
#define CCM_CCGR2_IPMUX2(n)			((uint32_t)(((n) & 0x03) << 18))
#define CCM_CCGR2_IPMUX1(n)			((uint32_t)(((n) & 0x03) << 16))
#define CCM_CCGR2_XBAR3(n)			((uint32_t)(((n) & 0x03) << 14))
#define CCM_CCGR2_IIM(n)			((uint32_t)(((n) & 0x03) << 12))
#define CCM_CCGR2_LPI2C3(n)			((uint32_t)(((n) & 0x03) << 10))
#define CCM_CCGR2_LPI2C2(n)			((uint32_t)(((n) & 0x03) << 8))
#define CCM_CCGR2_LPI2C1(n)			((uint32_t)(((n) & 0x03) << 6))
#define CCM_CCGR2_IOMUXC_SNVS(n)		((uint32_t)(((n) & 0x03) << 4))
#define CCM_CCGR2_CSI(n)			((uint32_t)(((n) & 0x03) << 2))
#define CCM_CCGR3_IOMUXC_SNVS_GPR(n)		((uint32_t)(((n) & 0x03) << 30))
#define CCM_CCGR3_OCRAM(n)			((uint32_t)(((n) & 0x03) << 28))
#define CCM_CCGR3_ACMP4(n)			((uint32_t)(((n) & 0x03) << 26))
#define CCM_CCGR3_ACMP3(n)			((uint32_t)(((n) & 0x03) << 24))
#define CCM_CCGR3_ACMP2(n)			((uint32_t)(((n) & 0x03) << 22))
#define CCM_CCGR3_ACMP1(n)			((uint32_t)(((n) & 0x03) << 20))
#define CCM_CCGR3_FLEXRAM(n)			((uint32_t)(((n) & 0x03) << 18))
#define CCM_CCGR3_WDOG1(n)			((uint32_t)(((n) & 0x03) << 16))
#define CCM_CCGR3_EWM(n)			((uint32_t)(((n) & 0x03) << 14))
#define CCM_CCGR3_GPIO4(n)			((uint32_t)(((n) & 0x03) << 12))
#define CCM_CCGR3_LCDIF_PIX(n)			((uint32_t)(((n) & 0x03) << 10))
#define CCM_CCGR3_AOI1(n)			((uint32_t)(((n) & 0x03) << 8))
#define CCM_CCGR3_LPUART6(n)			((uint32_t)(((n) & 0x03) << 6))
#define CCM_CCGR3_SEMC(n)			((uint32_t)(((n) & 0x03) << 4))
#define CCM_CCGR3_LPUART5(n)			((uint32_t)(((n) & 0x03) << 2))
#define CCM_CCGR3_FLEXIO2(n)			((uint32_t)(((n) & 0x03) << 0))
#define CCM_CCGR4_ENC4(n)			((uint32_t)(((n) & 0x03) << 30))
#define CCM_CCGR4_ENC3(n)			((uint32_t)(((n) & 0x03) << 28))
#define CCM_CCGR4_ENC2(n)			((uint32_t)(((n) & 0x03) << 26))
#define CCM_CCGR4_ENC1(n)			((uint32_t)(((n) & 0x03) << 24))
#define CCM_CCGR4_PWM4(n)			((uint32_t)(((n) & 0x03) << 22))
#define CCM_CCGR4_PWM3(n)			((uint32_t)(((n) & 0x03) << 20))
#define CCM_CCGR4_PWM2(n)			((uint32_t)(((n) & 0x03) << 18))
#define CCM_CCGR4_PWM1(n)			((uint32_t)(((n) & 0x03) << 16))
#define CCM_CCGR4_SIM_EMS(n)			((uint32_t)(((n) & 0x03) << 14))
#define CCM_CCGR4_SIM_M(n)			((uint32_t)(((n) & 0x03) << 12))
#define CCM_CCGR4_TSC(n)			((uint32_t)(((n) & 0x03) << 10))
#define CCM_CCGR4_SIM_M7(n)			((uint32_t)(((n) & 0x03) << 8))
#define CCM_CCGR4_BEE(n)			((uint32_t)(((n) & 0x03) << 6))
#define CCM_CCGR4_IOMUXC_GPR(n)			((uint32_t)(((n) & 0x03) << 4))
#define CCM_CCGR4_IOMUXC(n)			((uint32_t)(((n) & 0x03) << 2))
#define CCM_CCGR5_SNVS_LP(n)			((uint32_t)(((n) & 0x03) << 30))
#define CCM_CCGR5_SNVS_HP(n)			((uint32_t)(((n) & 0x03) << 28))
#define CCM_CCGR5_LPUART7(n)			((uint32_t)(((n) & 0x03) << 26))
#define CCM_CCGR5_LPUART1(n)			((uint32_t)(((n) & 0x03) << 24))
#define CCM_CCGR5_SAI3(n)			((uint32_t)(((n) & 0x03) << 22))
#define CCM_CCGR5_SAI2(n)			((uint32_t)(((n) & 0x03) << 20))
#define CCM_CCGR5_SAI1(n)			((uint32_t)(((n) & 0x03) << 18))
#define CCM_CCGR5_SIM_MAIN(n)			((uint32_t)(((n) & 0x03) << 16))
#define CCM_CCGR5_SPDIF(n)			((uint32_t)(((n) & 0x03) << 14))
#define CCM_CCGR5_AIPS_TZ4(n)			((uint32_t)(((n) & 0x03) << 12))
#define CCM_CCGR5_WDOG2(n)			((uint32_t)(((n) & 0x03) << 10))
#define CCM_CCGR5_KPP(n)			((uint32_t)(((n) & 0x03) << 8))
#define CCM_CCGR5_DMA(n)			((uint32_t)(((n) & 0x03) << 6))
#define CCM_CCGR5_WDOG3(n)			((uint32_t)(((n) & 0x03) << 4))
#define CCM_CCGR5_FLEXIO1(n)			((uint32_t)(((n) & 0x03) << 2))
#define CCM_CCGR5_ROM(n)			((uint32_t)(((n) & 0x03) << 0))
#define CCM_CCGR6_QTIMER3(n)			((uint32_t)(((n) & 0x03) << 30))
#define CCM_CCGR6_QTIMER2(n)			((uint32_t)(((n) & 0x03) << 28))
#define CCM_CCGR6_QTIMER1(n)			((uint32_t)(((n) & 0x03) << 26))
#define CCM_CCGR6_LPI2C4_SERIAL(n)		((uint32_t)(((n) & 0x03) << 24))
#define CCM_CCGR6_ANADIG(n)			((uint32_t)(((n) & 0x03) << 22))
#define CCM_CCGR6_SIM_PER(n)			((uint32_t)(((n) & 0x03) << 20)) /* IMXRT1052 */
#define CCM_CCGR6_AXBS_P(n)			((uint32_t)(((n) & 0x03) << 20)) /* IMXRT1062 */
#define CCM_CCGR6_AIPS_TZ3(n)			((uint32_t)(((n) & 0x03) << 18))
#define CCM_CCGR6_QTIMER4(n)			((uint32_t)(((n) & 0x03) << 16))
#define CCM_CCGR6_LPUART8(n)			((uint32_t)(((n) & 0x03) << 14))
#define CCM_CCGR6_TRNG(n)			((uint32_t)(((n) & 0x03) << 12))
#define CCM_CCGR6_FLEXSPI(n)			((uint32_t)(((n) & 0x03) << 10))
#define CCM_CCGR6_IPMUX4(n)			((uint32_t)(((n) & 0x03) << 8))
#define CCM_CCGR6_DCDC(n)			((uint32_t)(((n) & 0x03) << 6))
#define CCM_CCGR6_USDHC2(n)			((uint32_t)(((n) & 0x03) << 4))
#define CCM_CCGR6_USDHC1(n)			((uint32_t)(((n) & 0x03) << 2))
#define CCM_CCGR6_USBOH3(n)			((uint32_t)(((n) & 0x03) << 0))
#define CCM_CCGR7_FLEXIO3(n)			((uint32_t)(((n) & 0x03) << 12))
#define CCM_CCGR7_APIS_LITE(n)			((uint32_t)(((n) & 0x03) << 10))
#define CCM_CCGR7_CAN3_SERIAL(n)		((uint32_t)(((n) & 0x03) << 8))
#define CCM_CCGR7_CAN3(n)			((uint32_t)(((n) & 0x03) << 6))
#define CCM_CCGR7_AXBS_L(n)			((uint32_t)(((n) & 0x03) << 4))
#define CCM_CCGR7_FLEXSPI2(n)			((uint32_t)(((n) & 0x03) << 2))
#define CCM_CCGR7_ENET2(n)			((uint32_t)(((n) & 0x03) << 0))
#define CCM_CMEOR_MOD_EN_OV_CAN1_CPI		((uint32_t)(1<<30))
#define CCM_CMEOR_MOD_EN_OV_CAN2_CPI		((uint32_t)(1<<28))
#define CCM_CMEOR_MOD_EN_OV_TRNG		((uint32_t)(1<<9))
#define CCM_CMEOR_MOD_EN_USDHC			((uint32_t)(1<<7))
#define CCM_CMEOR_MOD_EN_OV_PIT			((uint32_t)(1<<6))
#define CCM_CMEOR_MOD_EN_OV_GPT			((uint32_t)(1<<5))

#define CCM_CSCMR1_SAI1_CLK_SEL_MASK		(CCM_CSCMR1_SAI1_CLK_SEL(0x03))
#define CCM_CS1CDR_SAI1_CLK_PRED_MASK		(CCM_CS1CDR_SAI1_CLK_PRED(0x07))
#define CCM_CS1CDR_SAI1_CLK_PODF_MASK		(CCM_CS1CDR_SAI1_CLK_PODF(0x3f))
#define CCM_CSCMR1_SAI2_CLK_SEL_MASK		(CCM_CSCMR1_SAI2_CLK_SEL(0x03))
#define CCM_CS2CDR_SAI2_CLK_PRED_MASK		(CCM_CS2CDR_SAI2_CLK_PRED(0x07))
#define CCM_CS2CDR_SAI2_CLK_PODF_MASK		(CCM_CS2CDR_SAI2_CLK_PODF(0x3f))
#define CCM_CSCMR1_SAI3_CLK_SEL_MASK		(CCM_CSCMR1_SAI3_CLK_SEL(0x03))
#define CCM_CS1CDR_SAI3_CLK_PRED_MASK		(CCM_CS1CDR_SAI3_CLK_PRED(0x07))
#define CCM_CS1CDR_SAI3_CLK_PODF_MASK		(CCM_CS1CDR_SAI3_CLK_PODF(0x3f))
#define CCM_CDCDR_SPDIF0_CLK_SEL_MASK		(CCM_CDCDR_SPDIF0_CLK_SEL(0x03))
#define CCM_CDCDR_SPDIF0_CLK_PRED_MASK		(CCM_CDCDR_SPDIF0_CLK_PRED(0x07))
#define CCM_CDCDR_SPDIF0_CLK_PODF_MASK		(CCM_CDCDR_SPDIF0_CLK_PODF(0x07))

// 18.8: page 752
#define IMXRT_CCM_ANALOG	(*(IMXRT_REGISTER32_t *)0x400D8000)
#define CCM_ANALOG_PLL_ARM		(IMXRT_CCM_ANALOG.offset000)
#define CCM_ANALOG_PLL_ARM_SET		(IMXRT_CCM_ANALOG.offset004)
#define CCM_ANALOG_PLL_ARM_CLR		(IMXRT_CCM_ANALOG.offset008)
#define CCM_ANALOG_PLL_ARM_TOG		(IMXRT_CCM_ANALOG.offset00C)
#define CCM_ANALOG_PLL_USB1		(IMXRT_CCM_ANALOG.offset010)
#define CCM_ANALOG_PLL_USB1_SET		(IMXRT_CCM_ANALOG.offset014)
#define CCM_ANALOG_PLL_USB1_CLR		(IMXRT_CCM_ANALOG.offset018)
#define CCM_ANALOG_PLL_USB1_TOG		(IMXRT_CCM_ANALOG.offset01C)
#define CCM_ANALOG_PLL_USB2		(IMXRT_CCM_ANALOG.offset020)
#define CCM_ANALOG_PLL_USB2_SET		(IMXRT_CCM_ANALOG.offset024)
#define CCM_ANALOG_PLL_USB2_CLR		(IMXRT_CCM_ANALOG.offset028)
#define CCM_ANALOG_PLL_USB2_TOG		(IMXRT_CCM_ANALOG.offset02C)
#define CCM_ANALOG_PLL_SYS		(IMXRT_CCM_ANALOG.offset030)
#define CCM_ANALOG_PLL_SYS_SET		(IMXRT_CCM_ANALOG.offset034)
#define CCM_ANALOG_PLL_SYS_CLR		(IMXRT_CCM_ANALOG.offset038)
#define CCM_ANALOG_PLL_SYS_TOG		(IMXRT_CCM_ANALOG.offset03C)
#define CCM_ANALOG_PLL_SYS_SS		(IMXRT_CCM_ANALOG.offset040)
#define CCM_ANALOG_PLL_SYS_NUM		(IMXRT_CCM_ANALOG.offset050)
#define CCM_ANALOG_PLL_SYS_DENOM	(IMXRT_CCM_ANALOG.offset060)
#define CCM_ANALOG_PLL_AUDIO		(IMXRT_CCM_ANALOG.offset070)
#define CCM_ANALOG_PLL_AUDIO_SET	(IMXRT_CCM_ANALOG.offset074)
#define CCM_ANALOG_PLL_AUDIO_CLR	(IMXRT_CCM_ANALOG.offset078)
#define CCM_ANALOG_PLL_AUDIO_TOG	(IMXRT_CCM_ANALOG.offset07C)
#define CCM_ANALOG_PLL_AUDIO_NUM	(IMXRT_CCM_ANALOG.offset080)
#define CCM_ANALOG_PLL_AUDIO_DENOM	(IMXRT_CCM_ANALOG.offset090)
#define CCM_ANALOG_PLL_VIDEO		(IMXRT_CCM_ANALOG.offset0A0)
#define CCM_ANALOG_PLL_VIDEO_SET	(IMXRT_CCM_ANALOG.offset0A4)
#define CCM_ANALOG_PLL_VIDEO_CLR	(IMXRT_CCM_ANALOG.offset0A8)
#define CCM_ANALOG_PLL_VIDEO_TOG	(IMXRT_CCM_ANALOG.offset0AC)
#define CCM_ANALOG_PLL_VIDEO_NUM	(IMXRT_CCM_ANALOG.offset0B0)
#define CCM_ANALOG_PLL_VIDEO_DENOM	(IMXRT_CCM_ANALOG.offset0C0)
#define CCM_ANALOG_PLL_ENET		(IMXRT_CCM_ANALOG.offset0EC)
#define CCM_ANALOG_PLL_ENET_SET		(IMXRT_CCM_ANALOG.offset0E4)
#define CCM_ANALOG_PLL_ENET_CLR		(IMXRT_CCM_ANALOG.offset0E8)
#define CCM_ANALOG_PLL_ENET_TOG		(IMXRT_CCM_ANALOG.offset0EC)
#define CCM_ANALOG_PFD_480		(IMXRT_CCM_ANALOG.offset0F0)
#define CCM_ANALOG_PFD_480_SET		(IMXRT_CCM_ANALOG.offset0F4)
#define CCM_ANALOG_PFD_480_CLR		(IMXRT_CCM_ANALOG.offset0F8)
#define CCM_ANALOG_PFD_480_TOG		(IMXRT_CCM_ANALOG.offset0FC)
#define CCM_ANALOG_PFD_528		(IMXRT_CCM_ANALOG.offset100)
#define CCM_ANALOG_PFD_528_SET		(IMXRT_CCM_ANALOG.offset104)
#define CCM_ANALOG_PFD_528_CLR		(IMXRT_CCM_ANALOG.offset108)
#define CCM_ANALOG_PFD_528_TOG		(IMXRT_CCM_ANALOG.offset10C)
#define CCM_ANALOG_MISC0		(IMXRT_CCM_ANALOG.offset150)
#define CCM_ANALOG_MISC0_SET		(IMXRT_CCM_ANALOG.offset154)
#define CCM_ANALOG_MISC0_CLR		(IMXRT_CCM_ANALOG.offset158)
#define CCM_ANALOG_MISC0_TOG		(IMXRT_CCM_ANALOG.offset15C)
#define CCM_ANALOG_MISC1		(IMXRT_CCM_ANALOG.offset160)
#define CCM_ANALOG_MISC1_SET		(IMXRT_CCM_ANALOG.offset164)
#define CCM_ANALOG_MISC1_CLR		(IMXRT_CCM_ANALOG.offset168)
#define CCM_ANALOG_MISC1_TOG		(IMXRT_CCM_ANALOG.offset16C)
#define CCM_ANALOG_MISC2		(IMXRT_CCM_ANALOG.offset170)
#define CCM_ANALOG_MISC2_SET		(IMXRT_CCM_ANALOG.offset174)
#define CCM_ANALOG_MISC2_CLR		(IMXRT_CCM_ANALOG.offset178)
#define CCM_ANALOG_MISC2_TOG		(IMXRT_CCM_ANALOG.offset17C)
#define CCM_ANALOG_PLL_ARM_LOCK			((uint32_t)(1<<31))
#define CCM_ANALOG_PLL_ARM_BYPASS		((uint32_t)(1<<16))
#define CCM_ANALOG_PLL_ARM_ENABLE		((uint32_t)(1<<13))
#define CCM_ANALOG_PLL_ARM_POWERDOWN		((uint32_t)(1<<12))
#define CCM_ANALOG_PLL_ARM_DIV_SELECT(n)	((uint32_t)(((n) & 0x7F) << 0))
#define CCM_ANALOG_PLL_ARM_DIV_SELECT_MASK	((uint32_t)(0x7F << 0))
#define CCM_ANALOG_PLL_USB1_LOCK		((uint32_t)(1<<31))
#define CCM_ANALOG_PLL_USB1_BYPASS		((uint32_t)(1<<16))
#define CCM_ANALOG_PLL_USB1_ENABLE		((uint32_t)(1<<13))
#define CCM_ANALOG_PLL_USB1_POWER		((uint32_t)(1<<12))
#define CCM_ANALOG_PLL_USB1_EN_USB_CLKS		((uint32_t)(1<<6))
#define CCM_ANALOG_PLL_USB1_DIV_SELECT		((uint32_t)(1<<1))
#define CCM_ANALOG_PLL_USB2_LOCK		((uint32_t)(1<<31))
#define CCM_ANALOG_PLL_USB2_BYPASS		((uint32_t)(1<<16))
#define CCM_ANALOG_PLL_USB2_ENABLE		((uint32_t)(1<<13))
#define CCM_ANALOG_PLL_USB2_POWER		((uint32_t)(1<<12))
#define CCM_ANALOG_PLL_USB2_EN_USB_CLKS		((uint32_t)(1<<6))
#define CCM_ANALOG_PLL_USB2_DIV_SELECT		((uint32_t)(1<<1))
#define CCM_ANALOG_PLL_SYS_LOCK			((uint32_t)(1<<31))
#define CCM_ANALOG_PLL_SYS_BYPASS		((uint32_t)(1<<16))
#define CCM_ANALOG_PLL_SYS_ENABLE		((uint32_t)(1<<13))
#define CCM_ANALOG_PLL_SYS_POWERDOWN		((uint32_t)(1<<12))
#define CCM_ANALOG_PLL_SYS_DIV_SELECT		((uint32_t)(1<<1))
#define CCM_ANALOG_PLL_AUDIO_POST_DIV_SELECT(n)	((uint32_t)(((n) & 0x03) <<19)) 
#define CCM_ANALOG_PLL_AUDIO_BYPASS		((uint32_t)(1<<16)) 
#define CCM_ANALOG_PLL_AUDIO_BYPASS_CLK_SRC(n)	((uint32_t)(((n) & 0x03) <<14)) 
#define CCM_ANALOG_PLL_AUDIO_ENABLE		((uint32_t)(1<<13)) 
#define CCM_ANALOG_PLL_AUDIO_POWERDOWN		((uint32_t)(1<<12)) 
#define CCM_ANALOG_PLL_AUDIO_DIV_SELECT(n)	((uint32_t)((n) & ((1<<6)-1)))

#define CCM_ANALOG_MISC2_DIV_MSB		((uint32_t)(1<<23))
#define CCM_ANALOG_MISC2_DIV_LSB		((uint32_t)(1<<15))

#define CCM_ANALOG_PLL_AUDIO_NUM_MASK		(((1<<29)-1))
#define CCM_ANALOG_PLL_AUDIO_DENOM_MASK		(((1<<29)-1))
#define CCM_ANALOG_PLL_AUDIO_LOCK		((uint32_t)(1<<31))


// 19.7: page 810
#define IMXRT_CSI		(*(IMXRT_REGISTER32_t *)0x402BC000)
#define CSI_CSICR1			(IMXRT_CSI.offset000)
#define CSI_CSICR2			(IMXRT_CSI.offset004)
#define CSI_CSICR3			(IMXRT_CSI.offset008)
#define CSI_CSISTATFIFO			(IMXRT_CSI.offset00C)
#define CSI_CSIRFIFO			(IMXRT_CSI.offset010)
#define CSI_CSIRXCNT			(IMXRT_CSI.offset014)
#define CSI_CSISR			(IMXRT_CSI.offset018)
#define CSI_CSIDMASA_STATFIFO		(IMXRT_CSI.offset020)
#define CSI_CSIDMATS_STATFIFO		(IMXRT_CSI.offset024)
#define CSI_CSIDMASA_FB1		(IMXRT_CSI.offset028)
#define CSI_CSIDMASA_FB2		(IMXRT_CSI.offset02C)
#define CSI_CSIFBUF_PARA		(IMXRT_CSI.offset030)
#define CSI_CSIIMAG_PARA		(IMXRT_CSI.offset034)
#define CSI_CSICR18			(IMXRT_CSI.offset048)
#define CSI_CSICR19			(IMXRT_CSI.offset04C)

// 20.6.1.1: page 837
#define IMXRT_DCDC		(*(IMXRT_REGISTER32_t *)0x40080000)
#define DCDC_REG0			(IMXRT_DCDC.offset000)
#define DCDC_REG1			(IMXRT_DCDC.offset004)
#define DCDC_REG2			(IMXRT_DCDC.offset008)
#define DCDC_REG3			(IMXRT_DCDC.offset00C)
#define DCDC_REG0_STS_DC_OK			((uint32_t)(1<<31))
#define DCDC_REG0_XTAL_24M_OK			((uint32_t)(1<<29))
#define DCDC_REG0_CURRENT_ALERT_RESET		((uint32_t)(1<<28))
#define DCDC_REG0_XTALOK_DISABLE		((uint32_t)(1<<27))
#define DCDC_REG0_PWD_CMP_OFFSET		((uint32_t)(1<<26))
#define DCDC_REG0_LP_HIGH_HYS			((uint32_t)(1<<21))
#define DCDC_REG0_LP_OVERLOAD_FREQ_SEL		((uint32_t)(1<<20))
#define DCDC_REG0_LP_OVERLOAD_THRSH(n)		((uint32_t)(((n) & 0x03) << 18))
#define DCDC_REG0_PWD_HIGH_VOLT_DET		((uint32_t)(1<<17))
#define DCDC_REG0_EN_LP_OVERLOAD_SNS		((uint32_t)(1<<16))
#define DCDC_REG0_ADJ_POSLIMIT_BUCK(n)		((uint32_t)(((n) & 0x0F) << 12))
#define DCDC_REG0_PWD_CMP_BATT_DET		((uint32_t)(1<<11))
#define DCDC_REG0_OVERCUR_TRIG_ADJ(n)		((uint32_t)(((n) & 0x03) << 9))
#define DCDC_REG0_PWD_OVERCUR_DET		((uint32_t)(1<<8))
#define DCDC_REG0_CUR_SNS_THRSH(n)		((uint32_t)(((n) & 0x07) << 5))
#define DCDC_REG0_PWD_CUR_SNS_CMP		((uint32_t)(1<<4))
#define DCDC_REG0_PWD_OSC_INT			((uint32_t)(1<<3))
#define DCDC_REG0_SEL_CLK			((uint32_t)(1<<2))
#define DCDC_REG0_DISABLE_AUTO_CLK_SWITCH	((uint32_t)(1<<1))
#define DCDC_REG0_PWD_ZCD			((uint32_t)(1<<0))
#define DCDC_REG1_VBG_TRIM(n)			((uint32_t)(((n) & 0x1F) << 24))
#define DCDC_REG1_LOOPCTRL_EN_HYST		((uint32_t)(1<<23))
#define DCDC_REG1_LOOPCTRL_HST_THRESH		((uint32_t)(1<<21))
#define DCDC_REG1_LP_CMP_ISRC_SEL(n)		((uint32_t)(((n) & 0x03) << 12))
#define DCDC_REG1_REG_RLOAD_SW			((uint32_t)(1<<9))
#define DCDC_REG1_REG_FBK_SEL(n)		((uint32_t)(((n) & 0x03) << 7))
#define DCDC_REG2_DCM_SET_CTRL			((uint32_t)(1<<28))
#define DCDC_REG2_DISABLE_PULSE_SKIP		((uint32_t)(1<<27))
#define DCDC_REG2_LOOPCTRL_HYST_SIGN		((uint32_t)(1<<13))
#define DCDC_REG2_LOOPCTRL_RCSCALE_THRSH	((uint32_t)(1<<12))
#define DCDC_REG2_LOOPCTRL_EN_RCSCALE		((uint32_t)(((n) & 0x07) << 9))
#define DCDC_REG2_LOOPCTRL_DC_FF		((uint32_t)(((n) & 0x07) << 6))
#define DCDC_REG2_LOOPCTRL_DC_R			((uint32_t)(((n) & 0x0F) << 2))
#define DCDC_REG2_LOOPCTRL_DC_C			((uint32_t)(((n) & 0x03) << 0))
#define DCDC_REG3_DISABLE_STEP			((uint32_t)(1<<30))
#define DCDC_REG3_MISC_DISABLEFET_LOGIC		((uint32_t)(1<<28))
#define DCDC_REG3_MISC_DELAY_TIMING		((uint32_t)(1<<27))
#define DCDC_REG3_MINPWR_DC_HALFCLK		((uint32_t)(1<<24))
#define DCDC_REG3_TARGET_LP(n)			((uint32_t)(((n) & 0x07) << 8))
#define DCDC_REG3_TRG(n)			((uint32_t)(((n) & 0x1F) << 0))
#define DCDC_REG3_TRG_MASK			((uint32_t)(0x1F << 0))

// 21.4.1.1: page 849
#define IMXRT_DMAMUX		(*(IMXRT_REGISTER32_t *)0x400EC000)
#define DMAMUX_CHCFG0			(IMXRT_DMAMUX.offset000)
#define DMAMUX_CHCFG1			(IMXRT_DMAMUX.offset004)
#define DMAMUX_CHCFG2			(IMXRT_DMAMUX.offset008)
#define DMAMUX_CHCFG3			(IMXRT_DMAMUX.offset00C)
#define DMAMUX_CHCFG4			(IMXRT_DMAMUX.offset010)
#define DMAMUX_CHCFG5			(IMXRT_DMAMUX.offset014)
#define DMAMUX_CHCFG6			(IMXRT_DMAMUX.offset018)
#define DMAMUX_CHCFG7			(IMXRT_DMAMUX.offset01C)
#define DMAMUX_CHCFG8			(IMXRT_DMAMUX.offset020)
#define DMAMUX_CHCFG9			(IMXRT_DMAMUX.offset024)
#define DMAMUX_CHCFG10			(IMXRT_DMAMUX.offset028)
#define DMAMUX_CHCFG11			(IMXRT_DMAMUX.offset02C)
#define DMAMUX_CHCFG12			(IMXRT_DMAMUX.offset030)
#define DMAMUX_CHCFG13			(IMXRT_DMAMUX.offset034)
#define DMAMUX_CHCFG14			(IMXRT_DMAMUX.offset038)
#define DMAMUX_CHCFG15			(IMXRT_DMAMUX.offset03C)
#define DMAMUX_CHCFG16			(IMXRT_DMAMUX.offset040)
#define DMAMUX_CHCFG17			(IMXRT_DMAMUX.offset044)
#define DMAMUX_CHCFG18			(IMXRT_DMAMUX.offset048)
#define DMAMUX_CHCFG19			(IMXRT_DMAMUX.offset04C)
#define DMAMUX_CHCFG20			(IMXRT_DMAMUX.offset050)
#define DMAMUX_CHCFG21			(IMXRT_DMAMUX.offset054)
#define DMAMUX_CHCFG22			(IMXRT_DMAMUX.offset058)
#define DMAMUX_CHCFG23			(IMXRT_DMAMUX.offset05C)
#define DMAMUX_CHCFG24			(IMXRT_DMAMUX.offset060)
#define DMAMUX_CHCFG25			(IMXRT_DMAMUX.offset064)
#define DMAMUX_CHCFG26			(IMXRT_DMAMUX.offset068)
#define DMAMUX_CHCFG27			(IMXRT_DMAMUX.offset06C)
#define DMAMUX_CHCFG28			(IMXRT_DMAMUX.offset070)
#define DMAMUX_CHCFG29			(IMXRT_DMAMUX.offset074)
#define DMAMUX_CHCFG30			(IMXRT_DMAMUX.offset078)
#define DMAMUX_CHCFG31			(IMXRT_DMAMUX.offset07C)
#define DMAMUX_CHCFG_ENBL			((uint32_t)(1<<31))
#define DMAMUX_CHCFG_TRIG			((uint32_t)(1<<30))
#define DMAMUX_CHCFG_A_ON			((uint32_t)(1<<29))

// 22.3.5.1: page 864
typedef struct {
	volatile uint32_t CR;	// 0
	volatile uint32_t ES;	// 4
	uint32_t unused1;	// 8
	volatile uint32_t ERQ;	// C
	uint32_t unused2;	// 10
	volatile uint32_t EEI;	// 14
	volatile uint8_t CEEI;	// 18
	volatile uint8_t SEEI;	// 19
	volatile uint8_t CERQ;	// 1A
	volatile uint8_t SERQ;	// 1B
	volatile uint8_t CDNE;	// 1C
	volatile uint8_t SSRT;	// 1D
	volatile uint8_t CERR;	// 1E
	volatile uint8_t CINT;	// 1F
	uint32_t unused3;	// 20
	volatile uint32_t INT;	// 24
	uint32_t unused4;	// 28
	volatile uint32_t ERR;	// 2C
	uint32_t unused5;	// 30
	volatile uint32_t HRS;	// 34
	uint32_t unused6;	// 38
	uint32_t unused7;	// 3C
	uint32_t unused8;	// 40
	volatile uint32_t EARS;	// 44
	uint32_t unused[46];
	volatile uint8_t DCHPRI3;
	volatile uint8_t DCHPRI2;
	volatile uint8_t DCHPRI1;
	volatile uint8_t DCHPRI0;
	volatile uint8_t DCHPRI7;
	volatile uint8_t DCHPRI6;
	volatile uint8_t DCHPRI5;
	volatile uint8_t DCHPRI4;
	volatile uint8_t DCHPRI11;
	volatile uint8_t DCHPRI10;
	volatile uint8_t DCHPRI9;
	volatile uint8_t DCHPRI8;
	volatile uint8_t DCHPRI15;
	volatile uint8_t DCHPRI14;
	volatile uint8_t DCHPRI13;
	volatile uint8_t DCHPRI12;
	volatile uint8_t DCHPRI19;
	volatile uint8_t DCHPRI18;
	volatile uint8_t DCHPRI17;
	volatile uint8_t DCHPRI16;
	volatile uint8_t DCHPRI23;
	volatile uint8_t DCHPRI22;
	volatile uint8_t DCHPRI21;
	volatile uint8_t DCHPRI20;
	volatile uint8_t DCHPRI27;
	volatile uint8_t DCHPRI26;
	volatile uint8_t DCHPRI25;
	volatile uint8_t DCHPRI24;
	volatile uint8_t DCHPRI31;
	volatile uint8_t DCHPRI30;
	volatile uint8_t DCHPRI29;
	volatile uint8_t DCHPRI28;
} IMXRT_DMA_t;

typedef struct {
	volatile const void * volatile SADDR;
	int16_t SOFF;
	union {
		uint16_t ATTR;
		struct {
			uint8_t ATTR_DST;
			uint8_t ATTR_SRC;
		};
	};
	union {
		uint32_t NBYTES;
		uint32_t NBYTES_MLNO;
		uint32_t NBYTES_MLOFFNO;
		uint32_t NBYTES_MLOFFYES;
	};
	int32_t SLAST;
	volatile void * volatile DADDR;
	int16_t DOFF;
	union {
		volatile uint16_t CITER;
		volatile uint16_t CITER_ELINKYES;
		volatile uint16_t CITER_ELINKNO;
	};
	int32_t DLASTSGA;
	volatile uint16_t CSR;
	union {
		volatile uint16_t BITER;
		volatile uint16_t BITER_ELINKYES;
		volatile uint16_t BITER_ELINKNO;
	};
} IMXRT_DMA_TCD_t;
#define IMXRT_DMA		(*(IMXRT_DMA_t *)0x400E8000)
#define DMA_CR				(IMXRT_DMA.CR)
#define DMA_ES				(IMXRT_DMA.ES)
#define DMA_ERQ				(IMXRT_DMA.ERQ)
#define DMA_EEI				(IMXRT_DMA.EEI)
#define DMA_CEEI			(IMXRT_DMA.CEEI)
#define DMA_SEEI			(IMXRT_DMA.SEEI)
#define DMA_CERQ			(IMXRT_DMA.CERQ)
#define DMA_SERQ			(IMXRT_DMA.SERQ)
#define DMA_CDNE			(IMXRT_DMA.CDNE)
#define DMA_SSRT			(IMXRT_DMA.SSRT)
#define DMA_CERR			(IMXRT_DMA.CERR)
#define DMA_CINT			(IMXRT_DMA.CINT)
#define DMA_INT				(IMXRT_DMA.INT)
#define DMA_ERR				(IMXRT_DMA.ERR)
#define DMA_HRS				(IMXRT_DMA.HRS)
#define DMA_EARS			(IMXRT_DMA.EARS)
#define DMA_DCHPRI3			(IMXRT_DMA.DCHPRI3)
#define DMA_DCHPRI2			(IMXRT_DMA.DCHPRI2)
#define DMA_DCHPRI1			(IMXRT_DMA.DCHPRI1)
#define DMA_DCHPRI0			(IMXRT_DMA.DCHPRI0)
#define DMA_DCHPRI7			(IMXRT_DMA.DCHPRI7)
#define DMA_DCHPRI6			(IMXRT_DMA.DCHPRI6)
#define DMA_DCHPRI5			(IMXRT_DMA.DCHPRI5)
#define DMA_DCHPRI4			(IMXRT_DMA.DCHPRI4)
#define DMA_DCHPRI11			(IMXRT_DMA.DCHPRI11)
#define DMA_DCHPRI10			(IMXRT_DMA.DCHPRI10)
#define DMA_DCHPRI9			(IMXRT_DMA.DCHPRI9)
#define DMA_DCHPRI8			(IMXRT_DMA.DCHPRI8)
#define DMA_DCHPRI15			(IMXRT_DMA.DCHPRI15)
#define DMA_DCHPRI14			(IMXRT_DMA.DCHPRI14)
#define DMA_DCHPRI13			(IMXRT_DMA.DCHPRI13)
#define DMA_DCHPRI12			(IMXRT_DMA.DCHPRI12)
#define DMA_DCHPRI19			(IMXRT_DMA.DCHPRI19)
#define DMA_DCHPRI18			(IMXRT_DMA.DCHPRI18)
#define DMA_DCHPRI17			(IMXRT_DMA.DCHPRI17)
#define DMA_DCHPRI16			(IMXRT_DMA.DCHPRI16)
#define DMA_DCHPRI23			(IMXRT_DMA.DCHPRI23)
#define DMA_DCHPRI22			(IMXRT_DMA.DCHPRI22)
#define DMA_DCHPRI21			(IMXRT_DMA.DCHPRI21)
#define DMA_DCHPRI20			(IMXRT_DMA.DCHPRI20)
#define DMA_DCHPRI27			(IMXRT_DMA.DCHPRI27)
#define DMA_DCHPRI26			(IMXRT_DMA.DCHPRI26)
#define DMA_DCHPRI25			(IMXRT_DMA.DCHPRI25)
#define DMA_DCHPRI24			(IMXRT_DMA.DCHPRI24)
#define DMA_DCHPRI31			(IMXRT_DMA.DCHPRI31)
#define DMA_DCHPRI30			(IMXRT_DMA.DCHPRI30)
#define DMA_DCHPRI29			(IMXRT_DMA.DCHPRI29)
#define DMA_DCHPRI28			(IMXRT_DMA.DCHPRI28)

#define DMA_CR_ACTIVE                   ((uint32_t)(1<<31))     // 1=DMA is executing
#define DMA_CR_CX                       ((uint32_t)(1<<17))     // Cancel Transfer
#define DMA_CR_ECX                      ((uint32_t)(1<<16))     // Error Cancel Transfer
#define DMA_CR_GRP1PRI                  ((uint32_t)(1<<10))
#define DMA_CR_GRP0PRI                  ((uint32_t)(1<<8))
#define DMA_CR_EMLM                     ((uint32_t)(1<<7))      // Enable Minor Loop Mapping
#define DMA_CR_CLM                      ((uint32_t)(1<<6))      // Continuous Link Mode
#define DMA_CR_HALT                     ((uint32_t)(1<<5))      // Halt DMA Operations
#define DMA_CR_HOE                      ((uint32_t)(1<<4))      // Halt On Error
#define DMA_CR_ERGA                     ((uint32_t)(1<<3))      // Enable Round Robin Group Arb
#define DMA_CR_ERCA                     ((uint32_t)(1<<2))      // Enable Round Robin Channel Arb
#define DMA_CR_EDBG                     ((uint32_t)(1<<1))      // Enable Debug
#define DMA_CEEI_CEEI(n)                ((uint8_t)(n & 0x1F))   // Clear Enable Error Interrupt
#define DMA_CEEI_CAEE                   ((uint8_t)1<<6)         // Clear All Enable Error Interrupts
#define DMA_CEEI_NOP                    ((uint8_t)1<<7)         // NOP
#define DMA_SEEI_SEEI(n)                ((uint8_t)(n & 0x1F))   // Set Enable Error Interrupt
#define DMA_SEEI_SAEE                   ((uint8_t)1<<6)         // Set All Enable Error Interrupts
#define DMA_SEEI_NOP                    ((uint8_t)1<<7)         // NOP
#define DMA_CERQ_CERQ(n)                ((uint8_t)(n & 0x1F))   // Clear Enable Request
#define DMA_CERQ_CAER                   ((uint8_t)1<<6)         // Clear All Enable Requests
#define DMA_CERQ_NOP                    ((uint8_t)1<<7)         // NOP
#define DMA_SERQ_SERQ(n)                ((uint8_t)(n & 0x1F))   // Set Enable Request
#define DMA_SERQ_SAER                   ((uint8_t)1<<6)         // Set All Enable Requests
#define DMA_SERQ_NOP                    ((uint8_t)1<<7)         // NOP
#define DMA_CDNE_CDNE(n)                ((uint8_t)(n & 0x1F))   // Clear Done Bit
#define DMA_CDNE_CADN                   ((uint8_t)1<<6)         // Clear All Done Bits
#define DMA_CDNE_NOP                    ((uint8_t)1<<7)         // NOP
#define DMA_SSRT_SSRT(n)                ((uint8_t)(n & 0x1F))   // Set Start Bit
#define DMA_SSRT_SAST                   ((uint8_t)1<<6)         // Set All Start Bits
#define DMA_SSRT_NOP                    ((uint8_t)1<<7)         // NOP
#define DMA_CERR_CERR(n)                ((uint8_t)(n & 0x1F))   // Clear Error Indicator
#define DMA_CERR_CAEI                   ((uint8_t)1<<6)         // Clear All Error Indicators
#define DMA_CERR_NOP                    ((uint8_t)1<<7)         // NOP
#define DMA_CINT_CINT(n)                ((uint8_t)(n & 0x1F))   // Clear Interrupt Request
#define DMA_CINT_CAIR                   ((uint8_t)1<<6)         // Clear All Interrupt Requests
#define DMA_CINT_NOP                    ((uint8_t)1<<7)         // NOP

#define IMXRT_DMA_TCD		((IMXRT_DMA_TCD_t *)0x400E9000)
#define DMA_TCD0_SADDR			(IMXRT_DMA_TCD[0].SADDR)
#define DMA_TCD0_SOFF			(IMXRT_DMA_TCD[0].SOFF)
#define DMA_TCD0_ATTR			(IMXRT_DMA_TCD[0].ATTR)
#define DMA_TCD0_NBYTES			(IMXRT_DMA_TCD[0].NBYTES)
#define DMA_TCD0_NBYTES_MLNO		(IMXRT_DMA_TCD[0].NBYTES_MLNO)
#define DMA_TCD0_NBYTES_MLOFFNO		(IMXRT_DMA_TCD[0].NBYTES_MLOFFNO)
#define DMA_TCD0_NBYTES_MLOFFYES	(IMXRT_DMA_TCD[0].NBYTES_MLOFFYES)
#define DMA_TCD0_SLAST			(IMXRT_DMA_TCD[0].SLAST)
#define DMA_TCD0_DADDR			(IMXRT_DMA_TCD[0].DADDR)
#define DMA_TCD0_DOFF			(IMXRT_DMA_TCD[0].DOFF)
#define DMA_TCD0_CITER			(IMXRT_DMA_TCD[0].CITER)
#define DMA_TCD0_CITER_ELINKYES		(IMXRT_DMA_TCD[0].CITER_ELINKYES)
#define DMA_TCD0_CITER_ELINKNO		(IMXRT_DMA_TCD[0].CITER_ELINKNO)
#define DMA_TCD0_DLASTSGA		(IMXRT_DMA_TCD[0].DLASTSGA)
#define DMA_TCD0_CSR			(IMXRT_DMA_TCD[0].CSR)
#define DMA_TCD0_BITER			(IMXRT_DMA_TCD[0].BITER)
#define DMA_TCD0_BITER_ELINKYES		(IMXRT_DMA_TCD[0].BITER_ELINKYES)
#define DMA_TCD0_BITER_ELINKNO		(IMXRT_DMA_TCD[0].BITER_ELINKNO)

#define DMA_TCD1_SADDR			(IMXRT_DMA_TCD[1].SADDR)
#define DMA_TCD1_SOFF			(IMXRT_DMA_TCD[1].SOFF)
#define DMA_TCD1_ATTR			(IMXRT_DMA_TCD[1].ATTR)
#define DMA_TCD1_NBYTES			(IMXRT_DMA_TCD[1].NBYTES)
#define DMA_TCD1_NBYTES_MLNO		(IMXRT_DMA_TCD[1].NBYTES_MLNO)
#define DMA_TCD1_NBYTES_MLOFFNO		(IMXRT_DMA_TCD[1].NBYTES_MLOFFNO)
#define DMA_TCD1_NBYTES_MLOFFYES	(IMXRT_DMA_TCD[1].NBYTES_MLOFFYES)
#define DMA_TCD1_SLAST			(IMXRT_DMA_TCD[1].SLAST)
#define DMA_TCD1_DADDR			(IMXRT_DMA_TCD[1].DADDR)
#define DMA_TCD1_DOFF			(IMXRT_DMA_TCD[1].DOFF)
#define DMA_TCD1_CITER			(IMXRT_DMA_TCD[1].CITER)
#define DMA_TCD1_CITER_ELINKYES		(IMXRT_DMA_TCD[1].CITER_ELINKYES)
#define DMA_TCD1_CITER_ELINKNO		(IMXRT_DMA_TCD[1].CITER_ELINKNO)
#define DMA_TCD1_DLASTSGA		(IMXRT_DMA_TCD[1].DLASTSGA)
#define DMA_TCD1_CSR			(IMXRT_DMA_TCD[1].CSR)
#define DMA_TCD1_BITER			(IMXRT_DMA_TCD[1].BITER)
#define DMA_TCD1_BITER_ELINKYES		(IMXRT_DMA_TCD[1].BITER_ELINKYES)
#define DMA_TCD1_BITER_ELINKNO		(IMXRT_DMA_TCD[1].BITER_ELINKNO)

#define DMA_TCD2_SADDR			(IMXRT_DMA_TCD[2].SADDR)
#define DMA_TCD2_SOFF			(IMXRT_DMA_TCD[2].SOFF)
#define DMA_TCD2_ATTR			(IMXRT_DMA_TCD[2].ATTR)
#define DMA_TCD2_NBYTES			(IMXRT_DMA_TCD[2].NBYTES)
#define DMA_TCD2_NBYTES_MLNO		(IMXRT_DMA_TCD[2].NBYTES_MLNO)
#define DMA_TCD2_NBYTES_MLOFFNO		(IMXRT_DMA_TCD[2].NBYTES_MLOFFNO)
#define DMA_TCD2_NBYTES_MLOFFYES	(IMXRT_DMA_TCD[2].NBYTES_MLOFFYES)
#define DMA_TCD2_SLAST			(IMXRT_DMA_TCD[2].SLAST)
#define DMA_TCD2_DADDR			(IMXRT_DMA_TCD[2].DADDR)
#define DMA_TCD2_DOFF			(IMXRT_DMA_TCD[2].DOFF)
#define DMA_TCD2_CITER			(IMXRT_DMA_TCD[2].CITER)
#define DMA_TCD2_CITER_ELINKYES		(IMXRT_DMA_TCD[2].CITER_ELINKYES)
#define DMA_TCD2_CITER_ELINKNO		(IMXRT_DMA_TCD[2].CITER_ELINKNO)
#define DMA_TCD2_DLASTSGA		(IMXRT_DMA_TCD[2].DLASTSGA)
#define DMA_TCD2_CSR			(IMXRT_DMA_TCD[2].CSR)
#define DMA_TCD2_BITER			(IMXRT_DMA_TCD[2].BITER)
#define DMA_TCD2_BITER_ELINKYES		(IMXRT_DMA_TCD[2].BITER_ELINKYES)
#define DMA_TCD2_BITER_ELINKNO		(IMXRT_DMA_TCD[2].BITER_ELINKNO)

#define DMA_TCD3_SADDR			(IMXRT_DMA_TCD[3].SADDR)
#define DMA_TCD3_SOFF			(IMXRT_DMA_TCD[3].SOFF)
#define DMA_TCD3_ATTR			(IMXRT_DMA_TCD[3].ATTR)
#define DMA_TCD3_NBYTES			(IMXRT_DMA_TCD[3].NBYTES)
#define DMA_TCD3_NBYTES_MLNO		(IMXRT_DMA_TCD[3].NBYTES_MLNO)
#define DMA_TCD3_NBYTES_MLOFFNO		(IMXRT_DMA_TCD[3].NBYTES_MLOFFNO)
#define DMA_TCD3_NBYTES_MLOFFYES	(IMXRT_DMA_TCD[3].NBYTES_MLOFFYES)
#define DMA_TCD3_SLAST			(IMXRT_DMA_TCD[3].SLAST)
#define DMA_TCD3_DADDR			(IMXRT_DMA_TCD[3].DADDR)
#define DMA_TCD3_DOFF			(IMXRT_DMA_TCD[3].DOFF)
#define DMA_TCD3_CITER			(IMXRT_DMA_TCD[3].CITER)
#define DMA_TCD3_CITER_ELINKYES		(IMXRT_DMA_TCD[3].CITER_ELINKYES)
#define DMA_TCD3_CITER_ELINKNO		(IMXRT_DMA_TCD[3].CITER_ELINKNO)
#define DMA_TCD3_DLASTSGA		(IMXRT_DMA_TCD[3].DLASTSGA)
#define DMA_TCD3_CSR			(IMXRT_DMA_TCD[3].CSR)
#define DMA_TCD3_BITER			(IMXRT_DMA_TCD[3].BITER)
#define DMA_TCD3_BITER_ELINKYES		(IMXRT_DMA_TCD[3].BITER_ELINKYES)
#define DMA_TCD3_BITER_ELINKNO		(IMXRT_DMA_TCD[3].BITER_ELINKNO)

#define DMA_TCD4_SADDR			(IMXRT_DMA_TCD[4].SADDR)
#define DMA_TCD4_SOFF			(IMXRT_DMA_TCD[4].SOFF)
#define DMA_TCD4_ATTR			(IMXRT_DMA_TCD[4].ATTR)
#define DMA_TCD4_NBYTES			(IMXRT_DMA_TCD[4].NBYTES)
#define DMA_TCD4_NBYTES_MLNO		(IMXRT_DMA_TCD[4].NBYTES_MLNO)
#define DMA_TCD4_NBYTES_MLOFFNO		(IMXRT_DMA_TCD[4].NBYTES_MLOFFNO)
#define DMA_TCD4_NBYTES_MLOFFYES	(IMXRT_DMA_TCD[4].NBYTES_MLOFFYES)
#define DMA_TCD4_SLAST			(IMXRT_DMA_TCD[4].SLAST)
#define DMA_TCD4_DADDR			(IMXRT_DMA_TCD[4].DADDR)
#define DMA_TCD4_DOFF			(IMXRT_DMA_TCD[4].DOFF)
#define DMA_TCD4_CITER			(IMXRT_DMA_TCD[4].CITER)
#define DMA_TCD4_CITER_ELINKYES		(IMXRT_DMA_TCD[4].CITER_ELINKYES)
#define DMA_TCD4_CITER_ELINKNO		(IMXRT_DMA_TCD[4].CITER_ELINKNO)
#define DMA_TCD4_DLASTSGA		(IMXRT_DMA_TCD[4].DLASTSGA)
#define DMA_TCD4_CSR			(IMXRT_DMA_TCD[4].CSR)
#define DMA_TCD4_BITER			(IMXRT_DMA_TCD[4].BITER)
#define DMA_TCD4_BITER_ELINKYES		(IMXRT_DMA_TCD[4].BITER_ELINKYES)
#define DMA_TCD4_BITER_ELINKNO		(IMXRT_DMA_TCD[4].BITER_ELINKNO)

#define DMA_TCD5_SADDR			(IMXRT_DMA_TCD[5].SADDR)
#define DMA_TCD5_SOFF			(IMXRT_DMA_TCD[5].SOFF)
#define DMA_TCD5_ATTR			(IMXRT_DMA_TCD[5].ATTR)
#define DMA_TCD5_NBYTES			(IMXRT_DMA_TCD[5].NBYTES)
#define DMA_TCD5_NBYTES_MLNO		(IMXRT_DMA_TCD[5].NBYTES_MLNO)
#define DMA_TCD5_NBYTES_MLOFFNO		(IMXRT_DMA_TCD[5].NBYTES_MLOFFNO)
#define DMA_TCD5_NBYTES_MLOFFYES	(IMXRT_DMA_TCD[5].NBYTES_MLOFFYES)
#define DMA_TCD5_SLAST			(IMXRT_DMA_TCD[5].SLAST)
#define DMA_TCD5_DADDR			(IMXRT_DMA_TCD[5].DADDR)
#define DMA_TCD5_DOFF			(IMXRT_DMA_TCD[5].DOFF)
#define DMA_TCD5_CITER			(IMXRT_DMA_TCD[5].CITER)
#define DMA_TCD5_CITER_ELINKYES		(IMXRT_DMA_TCD[5].CITER_ELINKYES)
#define DMA_TCD5_CITER_ELINKNO		(IMXRT_DMA_TCD[5].CITER_ELINKNO)
#define DMA_TCD5_DLASTSGA		(IMXRT_DMA_TCD[5].DLASTSGA)
#define DMA_TCD5_CSR			(IMXRT_DMA_TCD[5].CSR)
#define DMA_TCD5_BITER			(IMXRT_DMA_TCD[5].BITER)
#define DMA_TCD5_BITER_ELINKYES		(IMXRT_DMA_TCD[5].BITER_ELINKYES)
#define DMA_TCD5_BITER_ELINKNO		(IMXRT_DMA_TCD[5].BITER_ELINKNO)

#define DMA_TCD6_SADDR			(IMXRT_DMA_TCD[6].SADDR)
#define DMA_TCD6_SOFF			(IMXRT_DMA_TCD[6].SOFF)
#define DMA_TCD6_ATTR			(IMXRT_DMA_TCD[6].ATTR)
#define DMA_TCD6_NBYTES			(IMXRT_DMA_TCD[6].NBYTES)
#define DMA_TCD6_NBYTES_MLNO		(IMXRT_DMA_TCD[6].NBYTES_MLNO)
#define DMA_TCD6_NBYTES_MLOFFNO		(IMXRT_DMA_TCD[6].NBYTES_MLOFFNO)
#define DMA_TCD6_NBYTES_MLOFFYES	(IMXRT_DMA_TCD[6].NBYTES_MLOFFYES)
#define DMA_TCD6_SLAST			(IMXRT_DMA_TCD[6].SLAST)
#define DMA_TCD6_DADDR			(IMXRT_DMA_TCD[6].DADDR)
#define DMA_TCD6_DOFF			(IMXRT_DMA_TCD[6].DOFF)
#define DMA_TCD6_CITER			(IMXRT_DMA_TCD[6].CITER)
#define DMA_TCD6_CITER_ELINKYES		(IMXRT_DMA_TCD[6].CITER_ELINKYES)
#define DMA_TCD6_CITER_ELINKNO		(IMXRT_DMA_TCD[6].CITER_ELINKNO)
#define DMA_TCD6_DLASTSGA		(IMXRT_DMA_TCD[6].DLASTSGA)
#define DMA_TCD6_CSR			(IMXRT_DMA_TCD[6].CSR)
#define DMA_TCD6_BITER			(IMXRT_DMA_TCD[6].BITER)
#define DMA_TCD6_BITER_ELINKYES		(IMXRT_DMA_TCD[6].BITER_ELINKYES)
#define DMA_TCD6_BITER_ELINKNO		(IMXRT_DMA_TCD[6].BITER_ELINKNO)

#define DMA_TCD7_SADDR			(IMXRT_DMA_TCD[7].SADDR)
#define DMA_TCD7_SOFF			(IMXRT_DMA_TCD[7].SOFF)
#define DMA_TCD7_ATTR			(IMXRT_DMA_TCD[7].ATTR)
#define DMA_TCD7_NBYTES			(IMXRT_DMA_TCD[7].NBYTES)
#define DMA_TCD7_NBYTES_MLNO		(IMXRT_DMA_TCD[7].NBYTES_MLNO)
#define DMA_TCD7_NBYTES_MLOFFNO		(IMXRT_DMA_TCD[7].NBYTES_MLOFFNO)
#define DMA_TCD7_NBYTES_MLOFFYES	(IMXRT_DMA_TCD[7].NBYTES_MLOFFYES)
#define DMA_TCD7_SLAST			(IMXRT_DMA_TCD[7].SLAST)
#define DMA_TCD7_DADDR			(IMXRT_DMA_TCD[7].DADDR)
#define DMA_TCD7_DOFF			(IMXRT_DMA_TCD[7].DOFF)
#define DMA_TCD7_CITER			(IMXRT_DMA_TCD[7].CITER)
#define DMA_TCD7_CITER_ELINKYES		(IMXRT_DMA_TCD[7].CITER_ELINKYES)
#define DMA_TCD7_CITER_ELINKNO		(IMXRT_DMA_TCD[7].CITER_ELINKNO)
#define DMA_TCD7_DLASTSGA		(IMXRT_DMA_TCD[7].DLASTSGA)
#define DMA_TCD7_CSR			(IMXRT_DMA_TCD[7].CSR)
#define DMA_TCD7_BITER			(IMXRT_DMA_TCD[7].BITER)
#define DMA_TCD7_BITER_ELINKYES		(IMXRT_DMA_TCD[7].BITER_ELINKYES)
#define DMA_TCD7_BITER_ELINKNO		(IMXRT_DMA_TCD[7].BITER_ELINKNO)

#define DMA_TCD8_SADDR			(IMXRT_DMA_TCD[8].SADDR)
#define DMA_TCD8_SOFF			(IMXRT_DMA_TCD[8].SOFF)
#define DMA_TCD8_ATTR			(IMXRT_DMA_TCD[8].ATTR)
#define DMA_TCD8_NBYTES			(IMXRT_DMA_TCD[8].NBYTES)
#define DMA_TCD8_NBYTES_MLNO		(IMXRT_DMA_TCD[8].NBYTES_MLNO)
#define DMA_TCD8_NBYTES_MLOFFNO		(IMXRT_DMA_TCD[8].NBYTES_MLOFFNO)
#define DMA_TCD8_NBYTES_MLOFFYES	(IMXRT_DMA_TCD[8].NBYTES_MLOFFYES)
#define DMA_TCD8_SLAST			(IMXRT_DMA_TCD[8].SLAST)
#define DMA_TCD8_DADDR			(IMXRT_DMA_TCD[8].DADDR)
#define DMA_TCD8_DOFF			(IMXRT_DMA_TCD[8].DOFF)
#define DMA_TCD8_CITER			(IMXRT_DMA_TCD[8].CITER)
#define DMA_TCD8_CITER_ELINKYES		(IMXRT_DMA_TCD[8].CITER_ELINKYES)
#define DMA_TCD8_CITER_ELINKNO		(IMXRT_DMA_TCD[8].CITER_ELINKNO)
#define DMA_TCD8_DLASTSGA		(IMXRT_DMA_TCD[8].DLASTSGA)
#define DMA_TCD8_CSR			(IMXRT_DMA_TCD[8].CSR)
#define DMA_TCD8_BITER			(IMXRT_DMA_TCD[8].BITER)
#define DMA_TCD8_BITER_ELINKYES		(IMXRT_DMA_TCD[8].BITER_ELINKYES)
#define DMA_TCD8_BITER_ELINKNO		(IMXRT_DMA_TCD[8].BITER_ELINKNO)

#define DMA_TCD9_SADDR			(IMXRT_DMA_TCD[9].SADDR)
#define DMA_TCD9_SOFF			(IMXRT_DMA_TCD[9].SOFF)
#define DMA_TCD9_ATTR			(IMXRT_DMA_TCD[9].ATTR)
#define DMA_TCD9_NBYTES			(IMXRT_DMA_TCD[9].NBYTES)
#define DMA_TCD9_NBYTES_MLNO		(IMXRT_DMA_TCD[9].NBYTES_MLNO)
#define DMA_TCD9_NBYTES_MLOFFNO		(IMXRT_DMA_TCD[9].NBYTES_MLOFFNO)
#define DMA_TCD9_NBYTES_MLOFFYES	(IMXRT_DMA_TCD[9].NBYTES_MLOFFYES)
#define DMA_TCD9_SLAST			(IMXRT_DMA_TCD[9].SLAST)
#define DMA_TCD9_DADDR			(IMXRT_DMA_TCD[9].DADDR)
#define DMA_TCD9_DOFF			(IMXRT_DMA_TCD[9].DOFF)
#define DMA_TCD9_CITER			(IMXRT_DMA_TCD[9].CITER)
#define DMA_TCD9_CITER_ELINKYES		(IMXRT_DMA_TCD[9].CITER_ELINKYES)
#define DMA_TCD9_CITER_ELINKNO		(IMXRT_DMA_TCD[9].CITER_ELINKNO)
#define DMA_TCD9_DLASTSGA		(IMXRT_DMA_TCD[9].DLASTSGA)
#define DMA_TCD9_CSR			(IMXRT_DMA_TCD[9].CSR)
#define DMA_TCD9_BITER			(IMXRT_DMA_TCD[9].BITER)
#define DMA_TCD9_BITER_ELINKYES		(IMXRT_DMA_TCD[9].BITER_ELINKYES)
#define DMA_TCD9_BITER_ELINKNO		(IMXRT_DMA_TCD[9].BITER_ELINKNO)

#define DMA_TCD10_SADDR			(IMXRT_DMA_TCD[10].SADDR)
#define DMA_TCD10_SOFF			(IMXRT_DMA_TCD[10].SOFF)
#define DMA_TCD10_ATTR			(IMXRT_DMA_TCD[10].ATTR)
#define DMA_TCD10_NBYTES		(IMXRT_DMA_TCD[10].NBYTES)
#define DMA_TCD10_NBYTES_MLNO		(IMXRT_DMA_TCD[10].NBYTES_MLNO)
#define DMA_TCD10_NBYTES_MLOFFNO	(IMXRT_DMA_TCD[10].NBYTES_MLOFFNO)
#define DMA_TCD10_NBYTES_MLOFFYES	(IMXRT_DMA_TCD[10].NBYTES_MLOFFYES)
#define DMA_TCD10_SLAST			(IMXRT_DMA_TCD[10].SLAST)
#define DMA_TCD10_DADDR			(IMXRT_DMA_TCD[10].DADDR)
#define DMA_TCD10_DOFF			(IMXRT_DMA_TCD[10].DOFF)
#define DMA_TCD10_CITER			(IMXRT_DMA_TCD[10].CITER)
#define DMA_TCD10_CITER_ELINKYES	(IMXRT_DMA_TCD[10].CITER_ELINKYES)
#define DMA_TCD10_CITER_ELINKNO		(IMXRT_DMA_TCD[10].CITER_ELINKNO)
#define DMA_TCD10_DLASTSGA		(IMXRT_DMA_TCD[10].DLASTSGA)
#define DMA_TCD10_CSR			(IMXRT_DMA_TCD[10].CSR)
#define DMA_TCD10_BITER			(IMXRT_DMA_TCD[10].BITER)
#define DMA_TCD10_BITER_ELINKYES	(IMXRT_DMA_TCD[10].BITER_ELINKYES)
#define DMA_TCD10_BITER_ELINKNO		(IMXRT_DMA_TCD[10].BITER_ELINKNO)

#define DMA_TCD11_SADDR			(IMXRT_DMA_TCD[11].SADDR)
#define DMA_TCD11_SOFF			(IMXRT_DMA_TCD[11].SOFF)
#define DMA_TCD11_ATTR			(IMXRT_DMA_TCD[11].ATTR)
#define DMA_TCD11_NBYTES		(IMXRT_DMA_TCD[11].NBYTES)
#define DMA_TCD11_NBYTES_MLNO		(IMXRT_DMA_TCD[11].NBYTES_MLNO)
#define DMA_TCD11_NBYTES_MLOFFNO	(IMXRT_DMA_TCD[11].NBYTES_MLOFFNO)
#define DMA_TCD11_NBYTES_MLOFFYES	(IMXRT_DMA_TCD[11].NBYTES_MLOFFYES)
#define DMA_TCD11_SLAST			(IMXRT_DMA_TCD[11].SLAST)
#define DMA_TCD11_DADDR			(IMXRT_DMA_TCD[11].DADDR)
#define DMA_TCD11_DOFF			(IMXRT_DMA_TCD[11].DOFF)
#define DMA_TCD11_CITER			(IMXRT_DMA_TCD[11].CITER)
#define DMA_TCD11_CITER_ELINKYES	(IMXRT_DMA_TCD[11].CITER_ELINKYES)
#define DMA_TCD11_CITER_ELINKNO		(IMXRT_DMA_TCD[11].CITER_ELINKNO)
#define DMA_TCD11_DLASTSGA		(IMXRT_DMA_TCD[11].DLASTSGA)
#define DMA_TCD11_CSR			(IMXRT_DMA_TCD[11].CSR)
#define DMA_TCD11_BITER			(IMXRT_DMA_TCD[11].BITER)
#define DMA_TCD11_BITER_ELINKYES	(IMXRT_DMA_TCD[11].BITER_ELINKYES)
#define DMA_TCD11_BITER_ELINKNO		(IMXRT_DMA_TCD[11].BITER_ELINKNO)

#define DMA_TCD12_SADDR			(IMXRT_DMA_TCD[12].SADDR)
#define DMA_TCD12_SOFF			(IMXRT_DMA_TCD[12].SOFF)
#define DMA_TCD12_ATTR			(IMXRT_DMA_TCD[12].ATTR)
#define DMA_TCD12_NBYTES		(IMXRT_DMA_TCD[12].NBYTES)
#define DMA_TCD12_NBYTES_MLNO		(IMXRT_DMA_TCD[12].NBYTES_MLNO)
#define DMA_TCD12_NBYTES_MLOFFNO	(IMXRT_DMA_TCD[12].NBYTES_MLOFFNO)
#define DMA_TCD12_NBYTES_MLOFFYES	(IMXRT_DMA_TCD[12].NBYTES_MLOFFYES)
#define DMA_TCD12_SLAST			(IMXRT_DMA_TCD[12].SLAST)
#define DMA_TCD12_DADDR			(IMXRT_DMA_TCD[12].DADDR)
#define DMA_TCD12_DOFF			(IMXRT_DMA_TCD[12].DOFF)
#define DMA_TCD12_CITER			(IMXRT_DMA_TCD[12].CITER)
#define DMA_TCD12_CITER_ELINKYES	(IMXRT_DMA_TCD[12].CITER_ELINKYES)
#define DMA_TCD12_CITER_ELINKNO		(IMXRT_DMA_TCD[12].CITER_ELINKNO)
#define DMA_TCD12_DLASTSGA		(IMXRT_DMA_TCD[12].DLASTSGA)
#define DMA_TCD12_CSR			(IMXRT_DMA_TCD[12].CSR)
#define DMA_TCD12_BITER			(IMXRT_DMA_TCD[12].BITER)
#define DMA_TCD12_BITER_ELINKYES	(IMXRT_DMA_TCD[12].BITER_ELINKYES)
#define DMA_TCD12_BITER_ELINKNO		(IMXRT_DMA_TCD[12].BITER_ELINKNO)

#define DMA_TCD13_SADDR			(IMXRT_DMA_TCD[13].SADDR)
#define DMA_TCD13_SOFF			(IMXRT_DMA_TCD[13].SOFF)
#define DMA_TCD13_ATTR			(IMXRT_DMA_TCD[13].ATTR)
#define DMA_TCD13_NBYTES		(IMXRT_DMA_TCD[13].NBYTES)
#define DMA_TCD13_NBYTES_MLNO		(IMXRT_DMA_TCD[13].NBYTES_MLNO)
#define DMA_TCD13_NBYTES_MLOFFNO	(IMXRT_DMA_TCD[13].NBYTES_MLOFFNO)
#define DMA_TCD13_NBYTES_MLOFFYES	(IMXRT_DMA_TCD[13].NBYTES_MLOFFYES)
#define DMA_TCD13_SLAST			(IMXRT_DMA_TCD[13].SLAST)
#define DMA_TCD13_DADDR			(IMXRT_DMA_TCD[13].DADDR)
#define DMA_TCD13_DOFF			(IMXRT_DMA_TCD[13].DOFF)
#define DMA_TCD13_CITER			(IMXRT_DMA_TCD[13].CITER)
#define DMA_TCD13_CITER_ELINKYES	(IMXRT_DMA_TCD[13].CITER_ELINKYES)
#define DMA_TCD13_CITER_ELINKNO		(IMXRT_DMA_TCD[13].CITER_ELINKNO)
#define DMA_TCD13_DLASTSGA		(IMXRT_DMA_TCD[13].DLASTSGA)
#define DMA_TCD13_CSR			(IMXRT_DMA_TCD[13].CSR)
#define DMA_TCD13_BITER			(IMXRT_DMA_TCD[13].BITER)
#define DMA_TCD13_BITER_ELINKYES	(IMXRT_DMA_TCD[13].BITER_ELINKYES)
#define DMA_TCD13_BITER_ELINKNO		(IMXRT_DMA_TCD[13].BITER_ELINKNO)

#define DMA_TCD14_SADDR			(IMXRT_DMA_TCD[14].SADDR)
#define DMA_TCD14_SOFF			(IMXRT_DMA_TCD[14].SOFF)
#define DMA_TCD14_ATTR			(IMXRT_DMA_TCD[14].ATTR)
#define DMA_TCD14_NBYTES		(IMXRT_DMA_TCD[14].NBYTES)
#define DMA_TCD14_NBYTES_MLNO		(IMXRT_DMA_TCD[14].NBYTES_MLNO)
#define DMA_TCD14_NBYTES_MLOFFNO	(IMXRT_DMA_TCD[14].NBYTES_MLOFFNO)
#define DMA_TCD14_NBYTES_MLOFFYES	(IMXRT_DMA_TCD[14].NBYTES_MLOFFYES)
#define DMA_TCD14_SLAST			(IMXRT_DMA_TCD[14].SLAST)
#define DMA_TCD14_DADDR			(IMXRT_DMA_TCD[14].DADDR)
#define DMA_TCD14_DOFF			(IMXRT_DMA_TCD[14].DOFF)
#define DMA_TCD14_CITER			(IMXRT_DMA_TCD[14].CITER)
#define DMA_TCD14_CITER_ELINKYES	(IMXRT_DMA_TCD[14].CITER_ELINKYES)
#define DMA_TCD14_CITER_ELINKNO		(IMXRT_DMA_TCD[14].CITER_ELINKNO)
#define DMA_TCD14_DLASTSGA		(IMXRT_DMA_TCD[14].DLASTSGA)
#define DMA_TCD14_CSR			(IMXRT_DMA_TCD[14].CSR)
#define DMA_TCD14_BITER			(IMXRT_DMA_TCD[14].BITER)
#define DMA_TCD14_BITER_ELINKYES	(IMXRT_DMA_TCD[14].BITER_ELINKYES)
#define DMA_TCD14_BITER_ELINKNO		(IMXRT_DMA_TCD[14].BITER_ELINKNO)

#define DMA_TCD15_SADDR			(IMXRT_DMA_TCD[15].SADDR)
#define DMA_TCD15_SOFF			(IMXRT_DMA_TCD[15].SOFF)
#define DMA_TCD15_ATTR			(IMXRT_DMA_TCD[15].ATTR)
#define DMA_TCD15_NBYTES		(IMXRT_DMA_TCD[15].NBYTES)
#define DMA_TCD15_NBYTES_MLNO		(IMXRT_DMA_TCD[15].NBYTES_MLNO)
#define DMA_TCD15_NBYTES_MLOFFNO	(IMXRT_DMA_TCD[15].NBYTES_MLOFFNO)
#define DMA_TCD15_NBYTES_MLOFFYES	(IMXRT_DMA_TCD[15].NBYTES_MLOFFYES)
#define DMA_TCD15_SLAST			(IMXRT_DMA_TCD[15].SLAST)
#define DMA_TCD15_DADDR			(IMXRT_DMA_TCD[15].DADDR)
#define DMA_TCD15_DOFF			(IMXRT_DMA_TCD[15].DOFF)
#define DMA_TCD15_CITER			(IMXRT_DMA_TCD[15].CITER)
#define DMA_TCD15_CITER_ELINKYES	(IMXRT_DMA_TCD[15].CITER_ELINKYES)
#define DMA_TCD15_CITER_ELINKNO		(IMXRT_DMA_TCD[15].CITER_ELINKNO)
#define DMA_TCD15_DLASTSGA		(IMXRT_DMA_TCD[15].DLASTSGA)
#define DMA_TCD15_CSR			(IMXRT_DMA_TCD[15].CSR)
#define DMA_TCD15_BITER			(IMXRT_DMA_TCD[15].BITER)
#define DMA_TCD15_BITER_ELINKYES	(IMXRT_DMA_TCD[15].BITER_ELINKYES)
#define DMA_TCD15_BITER_ELINKNO		(IMXRT_DMA_TCD[15].BITER_ELINKNO)

#define DMA_TCD16_SADDR			(IMXRT_DMA_TCD[16].SADDR)
#define DMA_TCD16_SOFF			(IMXRT_DMA_TCD[16].SOFF)
#define DMA_TCD16_ATTR			(IMXRT_DMA_TCD[16].ATTR)
#define DMA_TCD16_NBYTES		(IMXRT_DMA_TCD[16].NBYTES)
#define DMA_TCD16_NBYTES_MLNO		(IMXRT_DMA_TCD[16].NBYTES_MLNO)
#define DMA_TCD16_NBYTES_MLOFFNO	(IMXRT_DMA_TCD[16].NBYTES_MLOFFNO)
#define DMA_TCD16_NBYTES_MLOFFYES	(IMXRT_DMA_TCD[16].NBYTES_MLOFFYES)
#define DMA_TCD16_SLAST			(IMXRT_DMA_TCD[16].SLAST)
#define DMA_TCD16_DADDR			(IMXRT_DMA_TCD[16].DADDR)
#define DMA_TCD16_DOFF			(IMXRT_DMA_TCD[16].DOFF)
#define DMA_TCD16_CITER			(IMXRT_DMA_TCD[16].CITER)
#define DMA_TCD16_CITER_ELINKYES	(IMXRT_DMA_TCD[16].CITER_ELINKYES)
#define DMA_TCD16_CITER_ELINKNO		(IMXRT_DMA_TCD[16].CITER_ELINKNO)
#define DMA_TCD16_DLASTSGA		(IMXRT_DMA_TCD[16].DLASTSGA)
#define DMA_TCD16_CSR			(IMXRT_DMA_TCD[16].CSR)
#define DMA_TCD16_BITER			(IMXRT_DMA_TCD[16].BITER)
#define DMA_TCD16_BITER_ELINKYES	(IMXRT_DMA_TCD[16].BITER_ELINKYES)
#define DMA_TCD16_BITER_ELINKNO		(IMXRT_DMA_TCD[16].BITER_ELINKNO)

#define DMA_TCD17_SADDR			(IMXRT_DMA_TCD[17].SADDR)
#define DMA_TCD17_SOFF			(IMXRT_DMA_TCD[17].SOFF)
#define DMA_TCD17_ATTR			(IMXRT_DMA_TCD[17].ATTR)
#define DMA_TCD17_NBYTES		(IMXRT_DMA_TCD[17].NBYTES)
#define DMA_TCD17_NBYTES_MLNO		(IMXRT_DMA_TCD[17].NBYTES_MLNO)
#define DMA_TCD17_NBYTES_MLOFFNO	(IMXRT_DMA_TCD[17].NBYTES_MLOFFNO)
#define DMA_TCD17_NBYTES_MLOFFYES	(IMXRT_DMA_TCD[17].NBYTES_MLOFFYES)
#define DMA_TCD17_SLAST			(IMXRT_DMA_TCD[17].SLAST)
#define DMA_TCD17_DADDR			(IMXRT_DMA_TCD[17].DADDR)
#define DMA_TCD17_DOFF			(IMXRT_DMA_TCD[17].DOFF)
#define DMA_TCD17_CITER			(IMXRT_DMA_TCD[17].CITER)
#define DMA_TCD17_CITER_ELINKYES	(IMXRT_DMA_TCD[17].CITER_ELINKYES)
#define DMA_TCD17_CITER_ELINKNO		(IMXRT_DMA_TCD[17].CITER_ELINKNO)
#define DMA_TCD17_DLASTSGA		(IMXRT_DMA_TCD[17].DLASTSGA)
#define DMA_TCD17_CSR			(IMXRT_DMA_TCD[17].CSR)
#define DMA_TCD17_BITER			(IMXRT_DMA_TCD[17].BITER)
#define DMA_TCD17_BITER_ELINKYES	(IMXRT_DMA_TCD[17].BITER_ELINKYES)
#define DMA_TCD17_BITER_ELINKNO		(IMXRT_DMA_TCD[17].BITER_ELINKNO)

#define DMA_TCD18_SADDR			(IMXRT_DMA_TCD[18].SADDR)
#define DMA_TCD18_SOFF			(IMXRT_DMA_TCD[18].SOFF)
#define DMA_TCD18_ATTR			(IMXRT_DMA_TCD[18].ATTR)
#define DMA_TCD18_NBYTES		(IMXRT_DMA_TCD[18].NBYTES)
#define DMA_TCD18_NBYTES_MLNO		(IMXRT_DMA_TCD[18].NBYTES_MLNO)
#define DMA_TCD18_NBYTES_MLOFFNO	(IMXRT_DMA_TCD[18].NBYTES_MLOFFNO)
#define DMA_TCD18_NBYTES_MLOFFYES	(IMXRT_DMA_TCD[18].NBYTES_MLOFFYES)
#define DMA_TCD18_SLAST			(IMXRT_DMA_TCD[18].SLAST)
#define DMA_TCD18_DADDR			(IMXRT_DMA_TCD[18].DADDR)
#define DMA_TCD18_DOFF			(IMXRT_DMA_TCD[18].DOFF)
#define DMA_TCD18_CITER			(IMXRT_DMA_TCD[18].CITER)
#define DMA_TCD18_CITER_ELINKYES	(IMXRT_DMA_TCD[18].CITER_ELINKYES)
#define DMA_TCD18_CITER_ELINKNO		(IMXRT_DMA_TCD[18].CITER_ELINKNO)
#define DMA_TCD18_DLASTSGA		(IMXRT_DMA_TCD[18].DLASTSGA)
#define DMA_TCD18_CSR			(IMXRT_DMA_TCD[18].CSR)
#define DMA_TCD18_BITER			(IMXRT_DMA_TCD[18].BITER)
#define DMA_TCD18_BITER_ELINKYES	(IMXRT_DMA_TCD[18].BITER_ELINKYES)
#define DMA_TCD18_BITER_ELINKNO		(IMXRT_DMA_TCD[18].BITER_ELINKNO)

#define DMA_TCD19_SADDR			(IMXRT_DMA_TCD[19].SADDR)
#define DMA_TCD19_SOFF			(IMXRT_DMA_TCD[19].SOFF)
#define DMA_TCD19_ATTR			(IMXRT_DMA_TCD[19].ATTR)
#define DMA_TCD19_NBYTES		(IMXRT_DMA_TCD[19].NBYTES)
#define DMA_TCD19_NBYTES_MLNO		(IMXRT_DMA_TCD[19].NBYTES_MLNO)
#define DMA_TCD19_NBYTES_MLOFFNO	(IMXRT_DMA_TCD[19].NBYTES_MLOFFNO)
#define DMA_TCD19_NBYTES_MLOFFYES	(IMXRT_DMA_TCD[19].NBYTES_MLOFFYES)
#define DMA_TCD19_SLAST			(IMXRT_DMA_TCD[19].SLAST)
#define DMA_TCD19_DADDR			(IMXRT_DMA_TCD[19].DADDR)
#define DMA_TCD19_DOFF			(IMXRT_DMA_TCD[19].DOFF)
#define DMA_TCD19_CITER			(IMXRT_DMA_TCD[19].CITER)
#define DMA_TCD19_CITER_ELINKYES	(IMXRT_DMA_TCD[19].CITER_ELINKYES)
#define DMA_TCD19_CITER_ELINKNO		(IMXRT_DMA_TCD[19].CITER_ELINKNO)
#define DMA_TCD19_DLASTSGA		(IMXRT_DMA_TCD[19].DLASTSGA)
#define DMA_TCD19_CSR			(IMXRT_DMA_TCD[19].CSR)
#define DMA_TCD19_BITER			(IMXRT_DMA_TCD[19].BITER)
#define DMA_TCD19_BITER_ELINKYES	(IMXRT_DMA_TCD[19].BITER_ELINKYES)
#define DMA_TCD19_BITER_ELINKNO		(IMXRT_DMA_TCD[19].BITER_ELINKNO)

#define DMA_TCD20_SADDR			(IMXRT_DMA_TCD[20].SADDR)
#define DMA_TCD20_SOFF			(IMXRT_DMA_TCD[20].SOFF)
#define DMA_TCD20_ATTR			(IMXRT_DMA_TCD[20].ATTR)
#define DMA_TCD20_NBYTES		(IMXRT_DMA_TCD[20].NBYTES)
#define DMA_TCD20_NBYTES_MLNO		(IMXRT_DMA_TCD[20].NBYTES_MLNO)
#define DMA_TCD20_NBYTES_MLOFFNO	(IMXRT_DMA_TCD[20].NBYTES_MLOFFNO)
#define DMA_TCD20_NBYTES_MLOFFYES	(IMXRT_DMA_TCD[20].NBYTES_MLOFFYES)
#define DMA_TCD20_SLAST			(IMXRT_DMA_TCD[20].SLAST)
#define DMA_TCD20_DADDR			(IMXRT_DMA_TCD[20].DADDR)
#define DMA_TCD20_DOFF			(IMXRT_DMA_TCD[20].DOFF)
#define DMA_TCD20_CITER			(IMXRT_DMA_TCD[20].CITER)
#define DMA_TCD20_CITER_ELINKYES	(IMXRT_DMA_TCD[20].CITER_ELINKYES)
#define DMA_TCD20_CITER_ELINKNO		(IMXRT_DMA_TCD[20].CITER_ELINKNO)
#define DMA_TCD20_DLASTSGA		(IMXRT_DMA_TCD[20].DLASTSGA)
#define DMA_TCD20_CSR			(IMXRT_DMA_TCD[20].CSR)
#define DMA_TCD20_BITER			(IMXRT_DMA_TCD[20].BITER)
#define DMA_TCD20_BITER_ELINKYES	(IMXRT_DMA_TCD[20].BITER_ELINKYES)
#define DMA_TCD20_BITER_ELINKNO		(IMXRT_DMA_TCD[20].BITER_ELINKNO)

#define DMA_TCD21_SADDR			(IMXRT_DMA_TCD[21].SADDR)
#define DMA_TCD21_SOFF			(IMXRT_DMA_TCD[21].SOFF)
#define DMA_TCD21_ATTR			(IMXRT_DMA_TCD[21].ATTR)
#define DMA_TCD21_NBYTES		(IMXRT_DMA_TCD[21].NBYTES)
#define DMA_TCD21_NBYTES_MLNO		(IMXRT_DMA_TCD[21].NBYTES_MLNO)
#define DMA_TCD21_NBYTES_MLOFFNO	(IMXRT_DMA_TCD[21].NBYTES_MLOFFNO)
#define DMA_TCD21_NBYTES_MLOFFYES	(IMXRT_DMA_TCD[21].NBYTES_MLOFFYES)
#define DMA_TCD21_SLAST			(IMXRT_DMA_TCD[21].SLAST)
#define DMA_TCD21_DADDR			(IMXRT_DMA_TCD[21].DADDR)
#define DMA_TCD21_DOFF			(IMXRT_DMA_TCD[21].DOFF)
#define DMA_TCD21_CITER			(IMXRT_DMA_TCD[21].CITER)
#define DMA_TCD21_CITER_ELINKYES	(IMXRT_DMA_TCD[21].CITER_ELINKYES)
#define DMA_TCD21_CITER_ELINKNO		(IMXRT_DMA_TCD[21].CITER_ELINKNO)
#define DMA_TCD21_DLASTSGA		(IMXRT_DMA_TCD[21].DLASTSGA)
#define DMA_TCD21_CSR			(IMXRT_DMA_TCD[21].CSR)
#define DMA_TCD21_BITER			(IMXRT_DMA_TCD[21].BITER)
#define DMA_TCD21_BITER_ELINKYES	(IMXRT_DMA_TCD[21].BITER_ELINKYES)
#define DMA_TCD21_BITER_ELINKNO		(IMXRT_DMA_TCD[21].BITER_ELINKNO)

#define DMA_TCD22_SADDR			(IMXRT_DMA_TCD[22].SADDR)
#define DMA_TCD22_SOFF			(IMXRT_DMA_TCD[22].SOFF)
#define DMA_TCD22_ATTR			(IMXRT_DMA_TCD[22].ATTR)
#define DMA_TCD22_NBYTES		(IMXRT_DMA_TCD[22].NBYTES)
#define DMA_TCD22_NBYTES_MLNO		(IMXRT_DMA_TCD[22].NBYTES_MLNO)
#define DMA_TCD22_NBYTES_MLOFFNO	(IMXRT_DMA_TCD[22].NBYTES_MLOFFNO)
#define DMA_TCD22_NBYTES_MLOFFYES	(IMXRT_DMA_TCD[22].NBYTES_MLOFFYES)
#define DMA_TCD22_SLAST			(IMXRT_DMA_TCD[22].SLAST)
#define DMA_TCD22_DADDR			(IMXRT_DMA_TCD[22].DADDR)
#define DMA_TCD22_DOFF			(IMXRT_DMA_TCD[22].DOFF)
#define DMA_TCD22_CITER			(IMXRT_DMA_TCD[22].CITER)
#define DMA_TCD22_CITER_ELINKYES	(IMXRT_DMA_TCD[22].CITER_ELINKYES)
#define DMA_TCD22_CITER_ELINKNO		(IMXRT_DMA_TCD[22].CITER_ELINKNO)
#define DMA_TCD22_DLASTSGA		(IMXRT_DMA_TCD[22].DLASTSGA)
#define DMA_TCD22_CSR			(IMXRT_DMA_TCD[22].CSR)
#define DMA_TCD22_BITER			(IMXRT_DMA_TCD[22].BITER)
#define DMA_TCD22_BITER_ELINKYES	(IMXRT_DMA_TCD[22].BITER_ELINKYES)
#define DMA_TCD22_BITER_ELINKNO		(IMXRT_DMA_TCD[22].BITER_ELINKNO)

#define DMA_TCD23_SADDR			(IMXRT_DMA_TCD[23].SADDR)
#define DMA_TCD23_SOFF			(IMXRT_DMA_TCD[23].SOFF)
#define DMA_TCD23_ATTR			(IMXRT_DMA_TCD[23].ATTR)
#define DMA_TCD23_NBYTES		(IMXRT_DMA_TCD[23].NBYTES)
#define DMA_TCD23_NBYTES_MLNO		(IMXRT_DMA_TCD[23].NBYTES_MLNO)
#define DMA_TCD23_NBYTES_MLOFFNO	(IMXRT_DMA_TCD[23].NBYTES_MLOFFNO)
#define DMA_TCD23_NBYTES_MLOFFYES	(IMXRT_DMA_TCD[23].NBYTES_MLOFFYES)
#define DMA_TCD23_SLAST			(IMXRT_DMA_TCD[23].SLAST)
#define DMA_TCD23_DADDR			(IMXRT_DMA_TCD[23].DADDR)
#define DMA_TCD23_DOFF			(IMXRT_DMA_TCD[23].DOFF)
#define DMA_TCD23_CITER			(IMXRT_DMA_TCD[23].CITER)
#define DMA_TCD23_CITER_ELINKYES	(IMXRT_DMA_TCD[23].CITER_ELINKYES)
#define DMA_TCD23_CITER_ELINKNO		(IMXRT_DMA_TCD[23].CITER_ELINKNO)
#define DMA_TCD23_DLASTSGA		(IMXRT_DMA_TCD[23].DLASTSGA)
#define DMA_TCD23_CSR			(IMXRT_DMA_TCD[23].CSR)
#define DMA_TCD23_BITER			(IMXRT_DMA_TCD[23].BITER)
#define DMA_TCD23_BITER_ELINKYES	(IMXRT_DMA_TCD[23].BITER_ELINKYES)
#define DMA_TCD23_BITER_ELINKNO		(IMXRT_DMA_TCD[23].BITER_ELINKNO)

#define DMA_TCD24_SADDR			(IMXRT_DMA_TCD[24].SADDR)
#define DMA_TCD24_SOFF			(IMXRT_DMA_TCD[24].SOFF)
#define DMA_TCD24_ATTR			(IMXRT_DMA_TCD[24].ATTR)
#define DMA_TCD24_NBYTES		(IMXRT_DMA_TCD[24].NBYTES)
#define DMA_TCD24_NBYTES_MLNO		(IMXRT_DMA_TCD[24].NBYTES_MLNO)
#define DMA_TCD24_NBYTES_MLOFFNO	(IMXRT_DMA_TCD[24].NBYTES_MLOFFNO)
#define DMA_TCD24_NBYTES_MLOFFYES	(IMXRT_DMA_TCD[24].NBYTES_MLOFFYES)
#define DMA_TCD24_SLAST			(IMXRT_DMA_TCD[24].SLAST)
#define DMA_TCD24_DADDR			(IMXRT_DMA_TCD[24].DADDR)
#define DMA_TCD24_DOFF			(IMXRT_DMA_TCD[24].DOFF)
#define DMA_TCD24_CITER			(IMXRT_DMA_TCD[24].CITER)
#define DMA_TCD24_CITER_ELINKYES	(IMXRT_DMA_TCD[24].CITER_ELINKYES)
#define DMA_TCD24_CITER_ELINKNO		(IMXRT_DMA_TCD[24].CITER_ELINKNO)
#define DMA_TCD24_DLASTSGA		(IMXRT_DMA_TCD[24].DLASTSGA)
#define DMA_TCD24_CSR			(IMXRT_DMA_TCD[24].CSR)
#define DMA_TCD24_BITER			(IMXRT_DMA_TCD[24].BITER)
#define DMA_TCD24_BITER_ELINKYES	(IMXRT_DMA_TCD[24].BITER_ELINKYES)
#define DMA_TCD24_BITER_ELINKNO		(IMXRT_DMA_TCD[24].BITER_ELINKNO)

#define DMA_TCD25_SADDR			(IMXRT_DMA_TCD[25].SADDR)
#define DMA_TCD25_SOFF			(IMXRT_DMA_TCD[25].SOFF)
#define DMA_TCD25_ATTR			(IMXRT_DMA_TCD[25].ATTR)
#define DMA_TCD25_NBYTES		(IMXRT_DMA_TCD[25].NBYTES)
#define DMA_TCD25_NBYTES_MLNO		(IMXRT_DMA_TCD[25].NBYTES_MLNO)
#define DMA_TCD25_NBYTES_MLOFFNO	(IMXRT_DMA_TCD[25].NBYTES_MLOFFNO)
#define DMA_TCD25_NBYTES_MLOFFYES	(IMXRT_DMA_TCD[25].NBYTES_MLOFFYES)
#define DMA_TCD25_SLAST			(IMXRT_DMA_TCD[25].SLAST)
#define DMA_TCD25_DADDR			(IMXRT_DMA_TCD[25].DADDR)
#define DMA_TCD25_DOFF			(IMXRT_DMA_TCD[25].DOFF)
#define DMA_TCD25_CITER			(IMXRT_DMA_TCD[25].CITER)
#define DMA_TCD25_CITER_ELINKYES	(IMXRT_DMA_TCD[25].CITER_ELINKYES)
#define DMA_TCD25_CITER_ELINKNO		(IMXRT_DMA_TCD[25].CITER_ELINKNO)
#define DMA_TCD25_DLASTSGA		(IMXRT_DMA_TCD[25].DLASTSGA)
#define DMA_TCD25_CSR			(IMXRT_DMA_TCD[25].CSR)
#define DMA_TCD25_BITER			(IMXRT_DMA_TCD[25].BITER)
#define DMA_TCD25_BITER_ELINKYES	(IMXRT_DMA_TCD[25].BITER_ELINKYES)
#define DMA_TCD25_BITER_ELINKNO		(IMXRT_DMA_TCD[25].BITER_ELINKNO)

#define DMA_TCD26_SADDR			(IMXRT_DMA_TCD[26].SADDR)
#define DMA_TCD26_SOFF			(IMXRT_DMA_TCD[26].SOFF)
#define DMA_TCD26_ATTR			(IMXRT_DMA_TCD[26].ATTR)
#define DMA_TCD26_NBYTES		(IMXRT_DMA_TCD[26].NBYTES)
#define DMA_TCD26_NBYTES_MLNO		(IMXRT_DMA_TCD[26].NBYTES_MLNO)
#define DMA_TCD26_NBYTES_MLOFFNO	(IMXRT_DMA_TCD[26].NBYTES_MLOFFNO)
#define DMA_TCD26_NBYTES_MLOFFYES	(IMXRT_DMA_TCD[26].NBYTES_MLOFFYES)
#define DMA_TCD26_SLAST			(IMXRT_DMA_TCD[26].SLAST)
#define DMA_TCD26_DADDR			(IMXRT_DMA_TCD[26].DADDR)
#define DMA_TCD26_DOFF			(IMXRT_DMA_TCD[26].DOFF)
#define DMA_TCD26_CITER			(IMXRT_DMA_TCD[26].CITER)
#define DMA_TCD26_CITER_ELINKYES	(IMXRT_DMA_TCD[26].CITER_ELINKYES)
#define DMA_TCD26_CITER_ELINKNO		(IMXRT_DMA_TCD[26].CITER_ELINKNO)
#define DMA_TCD26_DLASTSGA		(IMXRT_DMA_TCD[26].DLASTSGA)
#define DMA_TCD26_CSR			(IMXRT_DMA_TCD[26].CSR)
#define DMA_TCD26_BITER			(IMXRT_DMA_TCD[26].BITER)
#define DMA_TCD26_BITER_ELINKYES	(IMXRT_DMA_TCD[26].BITER_ELINKYES)
#define DMA_TCD26_BITER_ELINKNO		(IMXRT_DMA_TCD[26].BITER_ELINKNO)

#define DMA_TCD27_SADDR			(IMXRT_DMA_TCD[27].SADDR)
#define DMA_TCD27_SOFF			(IMXRT_DMA_TCD[27].SOFF)
#define DMA_TCD27_ATTR			(IMXRT_DMA_TCD[27].ATTR)
#define DMA_TCD27_NBYTES		(IMXRT_DMA_TCD[27].NBYTES)
#define DMA_TCD27_NBYTES_MLNO		(IMXRT_DMA_TCD[27].NBYTES_MLNO)
#define DMA_TCD27_NBYTES_MLOFFNO	(IMXRT_DMA_TCD[27].NBYTES_MLOFFNO)
#define DMA_TCD27_NBYTES_MLOFFYES	(IMXRT_DMA_TCD[27].NBYTES_MLOFFYES)
#define DMA_TCD27_SLAST			(IMXRT_DMA_TCD[27].SLAST)
#define DMA_TCD27_DADDR			(IMXRT_DMA_TCD[27].DADDR)
#define DMA_TCD27_DOFF			(IMXRT_DMA_TCD[27].DOFF)
#define DMA_TCD27_CITER			(IMXRT_DMA_TCD[27].CITER)
#define DMA_TCD27_CITER_ELINKYES	(IMXRT_DMA_TCD[27].CITER_ELINKYES)
#define DMA_TCD27_CITER_ELINKNO		(IMXRT_DMA_TCD[27].CITER_ELINKNO)
#define DMA_TCD27_DLASTSGA		(IMXRT_DMA_TCD[27].DLASTSGA)
#define DMA_TCD27_CSR			(IMXRT_DMA_TCD[27].CSR)
#define DMA_TCD27_BITER			(IMXRT_DMA_TCD[27].BITER)
#define DMA_TCD27_BITER_ELINKYES	(IMXRT_DMA_TCD[27].BITER_ELINKYES)
#define DMA_TCD27_BITER_ELINKNO		(IMXRT_DMA_TCD[27].BITER_ELINKNO)

#define DMA_TCD28_SADDR			(IMXRT_DMA_TCD[28].SADDR)
#define DMA_TCD28_SOFF			(IMXRT_DMA_TCD[28].SOFF)
#define DMA_TCD28_ATTR			(IMXRT_DMA_TCD[28].ATTR)
#define DMA_TCD28_NBYTES		(IMXRT_DMA_TCD[28].NBYTES)
#define DMA_TCD28_NBYTES_MLNO		(IMXRT_DMA_TCD[28].NBYTES_MLNO)
#define DMA_TCD28_NBYTES_MLOFFNO	(IMXRT_DMA_TCD[28].NBYTES_MLOFFNO)
#define DMA_TCD28_NBYTES_MLOFFYES	(IMXRT_DMA_TCD[28].NBYTES_MLOFFYES)
#define DMA_TCD28_SLAST			(IMXRT_DMA_TCD[28].SLAST)
#define DMA_TCD28_DADDR			(IMXRT_DMA_TCD[28].DADDR)
#define DMA_TCD28_DOFF			(IMXRT_DMA_TCD[28].DOFF)
#define DMA_TCD28_CITER			(IMXRT_DMA_TCD[28].CITER)
#define DMA_TCD28_CITER_ELINKYES	(IMXRT_DMA_TCD[28].CITER_ELINKYES)
#define DMA_TCD28_CITER_ELINKNO		(IMXRT_DMA_TCD[28].CITER_ELINKNO)
#define DMA_TCD28_DLASTSGA		(IMXRT_DMA_TCD[28].DLASTSGA)
#define DMA_TCD28_CSR			(IMXRT_DMA_TCD[28].CSR)
#define DMA_TCD28_BITER			(IMXRT_DMA_TCD[28].BITER)
#define DMA_TCD28_BITER_ELINKYES	(IMXRT_DMA_TCD[28].BITER_ELINKYES)
#define DMA_TCD28_BITER_ELINKNO		(IMXRT_DMA_TCD[28].BITER_ELINKNO)

#define DMA_TCD29_SADDR			(IMXRT_DMA_TCD[29].SADDR)
#define DMA_TCD29_SOFF			(IMXRT_DMA_TCD[29].SOFF)
#define DMA_TCD29_ATTR			(IMXRT_DMA_TCD[29].ATTR)
#define DMA_TCD29_NBYTES		(IMXRT_DMA_TCD[29].NBYTES)
#define DMA_TCD29_NBYTES_MLNO		(IMXRT_DMA_TCD[29].NBYTES_MLNO)
#define DMA_TCD29_NBYTES_MLOFFNO	(IMXRT_DMA_TCD[29].NBYTES_MLOFFNO)
#define DMA_TCD29_NBYTES_MLOFFYES	(IMXRT_DMA_TCD[29].NBYTES_MLOFFYES)
#define DMA_TCD29_SLAST			(IMXRT_DMA_TCD[29].SLAST)
#define DMA_TCD29_DADDR			(IMXRT_DMA_TCD[29].DADDR)
#define DMA_TCD29_DOFF			(IMXRT_DMA_TCD[29].DOFF)
#define DMA_TCD29_CITER			(IMXRT_DMA_TCD[29].CITER)
#define DMA_TCD29_CITER_ELINKYES	(IMXRT_DMA_TCD[29].CITER_ELINKYES)
#define DMA_TCD29_CITER_ELINKNO		(IMXRT_DMA_TCD[29].CITER_ELINKNO)
#define DMA_TCD29_DLASTSGA		(IMXRT_DMA_TCD[29].DLASTSGA)
#define DMA_TCD29_CSR			(IMXRT_DMA_TCD[29].CSR)
#define DMA_TCD29_BITER			(IMXRT_DMA_TCD[29].BITER)
#define DMA_TCD29_BITER_ELINKYES	(IMXRT_DMA_TCD[29].BITER_ELINKYES)
#define DMA_TCD29_BITER_ELINKNO		(IMXRT_DMA_TCD[29].BITER_ELINKNO)

#define DMA_TCD30_SADDR			(IMXRT_DMA_TCD[30].SADDR)
#define DMA_TCD30_SOFF			(IMXRT_DMA_TCD[30].SOFF)
#define DMA_TCD30_ATTR			(IMXRT_DMA_TCD[30].ATTR)
#define DMA_TCD30_NBYTES		(IMXRT_DMA_TCD[30].NBYTES)
#define DMA_TCD30_NBYTES_MLNO		(IMXRT_DMA_TCD[30].NBYTES_MLNO)
#define DMA_TCD30_NBYTES_MLOFFNO	(IMXRT_DMA_TCD[30].NBYTES_MLOFFNO)
#define DMA_TCD30_NBYTES_MLOFFYES	(IMXRT_DMA_TCD[30].NBYTES_MLOFFYES)
#define DMA_TCD30_SLAST			(IMXRT_DMA_TCD[30].SLAST)
#define DMA_TCD30_DADDR			(IMXRT_DMA_TCD[30].DADDR)
#define DMA_TCD30_DOFF			(IMXRT_DMA_TCD[30].DOFF)
#define DMA_TCD30_CITER			(IMXRT_DMA_TCD[30].CITER)
#define DMA_TCD30_CITER_ELINKYES	(IMXRT_DMA_TCD[30].CITER_ELINKYES)
#define DMA_TCD30_CITER_ELINKNO		(IMXRT_DMA_TCD[30].CITER_ELINKNO)
#define DMA_TCD30_DLASTSGA		(IMXRT_DMA_TCD[30].DLASTSGA)
#define DMA_TCD30_CSR			(IMXRT_DMA_TCD[30].CSR)
#define DMA_TCD30_BITER			(IMXRT_DMA_TCD[30].BITER)
#define DMA_TCD30_BITER_ELINKYES	(IMXRT_DMA_TCD[30].BITER_ELINKYES)
#define DMA_TCD30_BITER_ELINKNO		(IMXRT_DMA_TCD[30].BITER_ELINKNO)

#define DMA_TCD31_SADDR			(IMXRT_DMA_TCD[31].SADDR)
#define DMA_TCD31_SOFF			(IMXRT_DMA_TCD[31].SOFF)
#define DMA_TCD31_ATTR			(IMXRT_DMA_TCD[31].ATTR)
#define DMA_TCD31_NBYTES		(IMXRT_DMA_TCD[31].NBYTES)
#define DMA_TCD31_NBYTES_MLNO		(IMXRT_DMA_TCD[31].NBYTES_MLNO)
#define DMA_TCD31_NBYTES_MLOFFNO	(IMXRT_DMA_TCD[31].NBYTES_MLOFFNO)
#define DMA_TCD31_NBYTES_MLOFFYES	(IMXRT_DMA_TCD[31].NBYTES_MLOFFYES)
#define DMA_TCD31_SLAST			(IMXRT_DMA_TCD[31].SLAST)
#define DMA_TCD31_DADDR			(IMXRT_DMA_TCD[31].DADDR)
#define DMA_TCD31_DOFF			(IMXRT_DMA_TCD[31].DOFF)
#define DMA_TCD31_CITER			(IMXRT_DMA_TCD[31].CITER)
#define DMA_TCD31_CITER_ELINKYES	(IMXRT_DMA_TCD[31].CITER_ELINKYES)
#define DMA_TCD31_CITER_ELINKNO		(IMXRT_DMA_TCD[31].CITER_ELINKNO)
#define DMA_TCD31_DLASTSGA		(IMXRT_DMA_TCD[31].DLASTSGA)
#define DMA_TCD31_CSR			(IMXRT_DMA_TCD[31].CSR)
#define DMA_TCD31_BITER			(IMXRT_DMA_TCD[31].BITER)
#define DMA_TCD31_BITER_ELINKYES	(IMXRT_DMA_TCD[31].BITER_ELINKYES)
#define DMA_TCD31_BITER_ELINKNO		(IMXRT_DMA_TCD[31].BITER_ELINKNO)

// TODO: double check these defines from Teensy 3.x are still correct for IMXRT
#define DMA_TCD_ATTR_SMOD(n)            (((n) & 0x1F) << 11)
#define DMA_TCD_ATTR_SSIZE(n)           (((n) & 0x7) << 8)
#define DMA_TCD_ATTR_DMOD(n)            (((n) & 0x1F) << 3)
#define DMA_TCD_ATTR_DSIZE(n)           (((n) & 0x7) << 0)
#define DMA_TCD_ATTR_SIZE_8BIT          0
#define DMA_TCD_ATTR_SIZE_16BIT         1
#define DMA_TCD_ATTR_SIZE_32BIT         2
#define DMA_TCD_ATTR_SIZE_16BYTE        4
#define DMA_TCD_ATTR_SIZE_32BYTE        5 // caution: this might not be supported in newer chips?
#define DMA_TCD_CSR_BWC(n)              (((n) & 0x3) << 14)
#define DMA_TCD_CSR_BWC_MASK            0xC000
#define DMA_TCD_CSR_MAJORLINKCH(n)      (((n) & 0xF) << 8)
#define DMA_TCD_CSR_MAJORLINKCH_MASK    0x0F00
#define DMA_TCD_CSR_DONE                0x0080
#define DMA_TCD_CSR_ACTIVE              0x0040
#define DMA_TCD_CSR_MAJORELINK          0x0020
#define DMA_TCD_CSR_ESG                 0x0010
#define DMA_TCD_CSR_DREQ                0x0008
#define DMA_TCD_CSR_INTHALF             0x0004
#define DMA_TCD_CSR_INTMAJOR            0x0002
#define DMA_TCD_CSR_START               0x0001
#define DMA_TCD_CITER_MASK              ((uint16_t)0x7FFF)         // Loop count mask
#define DMA_TCD_CITER_ELINK             ((uint16_t)1<<15)          // Enable channel linking on minor-loop complete
#define DMA_TCD_BITER_MASK              ((uint16_t)0x7FFF)         // Loop count mask
#define DMA_TCD_BITER_ELINK             ((uint16_t)1<<15)          // Enable channel linking on minor-loop complete
#define DMA_TCD_BITER_ELINKYES_ELINK            0x8000
#define DMA_TCD_BITER_ELINKYES_LINKCH(n)        (((n) & 0xF) << 9)
#define DMA_TCD_BITER_ELINKYES_LINKCH_MASK      0x1E00
#define DMA_TCD_BITER_ELINKYES_BITER(n)         (((n) & 0x1FF) << 0)
#define DMA_TCD_BITER_ELINKYES_BITER_MASK       0x01FF
#define DMA_TCD_CITER_ELINKYES_ELINK            0x8000
#define DMA_TCD_CITER_ELINKYES_LINKCH(n)        (((n) & 0xF) << 9)
#define DMA_TCD_CITER_ELINKYES_LINKCH_MASK      0x1E00
#define DMA_TCD_CITER_ELINKYES_CITER(n)         (((n) & 0x1FF) << 0)
#define DMA_TCD_CITER_ELINKYES_CITER_MASK       0x01FF
#define DMA_TCD_NBYTES_SMLOE                ((uint32_t)1<<31)               // Source Minor Loop Offset Enable
#define DMA_TCD_NBYTES_DMLOE                ((uint32_t)1<<30)               // Destination Minor Loop Offset Enable
#define DMA_TCD_NBYTES_MLOFFNO_NBYTES(n)    ((uint32_t)((n) & 0x3FFFFFFF))  // NBytes transfer count when minor loop disabled
#define DMA_TCD_NBYTES_MLOFFYES_NBYTES(n)   ((uint32_t)((n) & 0x3FF))       // NBytes transfer count when minor loop enabled
#define DMA_TCD_NBYTES_MLOFFYES_MLOFF(n)    ((uint32_t)((n) & 0xFFFFF)<<10) // Minor loop offset


// 23.7.1: page 1023
#define IMXRT_ENC1		(*(IMXRT_REGISTER16_t *)0x403C8000)
#define ENC1_CTRL			(IMXRT_ENC1.offset000)
#define ENC1_FILT			(IMXRT_ENC1.offset002)
#define ENC1_WTR			(IMXRT_ENC1.offset004)
#define ENC1_POSD			(IMXRT_ENC1.offset006)
#define ENC1_POSDH			(IMXRT_ENC1.offset008)
#define ENC1_REV			(IMXRT_ENC1.offset00A)
#define ENC1_REVH			(IMXRT_ENC1.offset00C)
#define ENC1_UPOS			(IMXRT_ENC1.offset00E)
#define ENC1_LPOS			(IMXRT_ENC1.offset010)
#define ENC1_UPOSH			(IMXRT_ENC1.offset012)
#define ENC1_LPOSH			(IMXRT_ENC1.offset014)
#define ENC1_UINIT			(IMXRT_ENC1.offset016)
#define ENC1_LINIT			(IMXRT_ENC1.offset018)
#define ENC1_IMR			(IMXRT_ENC1.offset01A)
#define ENC1_TST			(IMXRT_ENC1.offset01C)
#define ENC1_CTRL2			(IMXRT_ENC1.offset01E)
#define ENC1_UMOD			(IMXRT_ENC1.offset020)
#define ENC1_LMOD			(IMXRT_ENC1.offset022)
#define ENC1_UCOMP			(IMXRT_ENC1.offset024)
#define ENC1_LCOMP			(IMXRT_ENC1.offset026)
#define IMXRT_ENC2		(*(IMXRT_REGISTER16_t *)0x403CC000)
#define ENC2_CTRL			(IMXRT_ENC2.offset000)
#define ENC2_FILT			(IMXRT_ENC2.offset002)
#define ENC2_WTR			(IMXRT_ENC2.offset004)
#define ENC2_POSD			(IMXRT_ENC2.offset006)
#define ENC2_POSDH			(IMXRT_ENC2.offset008)
#define ENC2_REV			(IMXRT_ENC2.offset00A)
#define ENC2_REVH			(IMXRT_ENC2.offset00C)
#define ENC2_UPOS			(IMXRT_ENC2.offset00E)
#define ENC2_LPOS			(IMXRT_ENC2.offset010)
#define ENC2_UPOSH			(IMXRT_ENC2.offset012)
#define ENC2_LPOSH			(IMXRT_ENC2.offset014)
#define ENC2_UINIT			(IMXRT_ENC2.offset016)
#define ENC2_LINIT			(IMXRT_ENC2.offset018)
#define ENC2_IMR			(IMXRT_ENC2.offset01A)
#define ENC2_TST			(IMXRT_ENC2.offset01C)
#define ENC2_CTRL2			(IMXRT_ENC2.offset01E)
#define ENC2_UMOD			(IMXRT_ENC2.offset020)
#define ENC2_LMOD			(IMXRT_ENC2.offset022)
#define ENC2_UCOMP			(IMXRT_ENC2.offset024)
#define ENC2_LCOMP			(IMXRT_ENC2.offset026)
#define IMXRT_ENC3		(*(IMXRT_REGISTER16_t *)0x403D0000)
#define ENC3_CTRL			(IMXRT_ENC3.offset000)
#define ENC3_FILT			(IMXRT_ENC3.offset002)
#define ENC3_WTR			(IMXRT_ENC3.offset004)
#define ENC3_POSD			(IMXRT_ENC3.offset006)
#define ENC3_POSDH			(IMXRT_ENC3.offset008)
#define ENC3_REV			(IMXRT_ENC3.offset00A)
#define ENC3_REVH			(IMXRT_ENC3.offset00C)
#define ENC3_UPOS			(IMXRT_ENC3.offset00E)
#define ENC3_LPOS			(IMXRT_ENC3.offset010)
#define ENC3_UPOSH			(IMXRT_ENC3.offset012)
#define ENC3_LPOSH			(IMXRT_ENC3.offset014)
#define ENC3_UINIT			(IMXRT_ENC3.offset016)
#define ENC3_LINIT			(IMXRT_ENC3.offset018)
#define ENC3_IMR			(IMXRT_ENC3.offset01A)
#define ENC3_TST			(IMXRT_ENC3.offset01C)
#define ENC3_CTRL2			(IMXRT_ENC3.offset01E)
#define ENC3_UMOD			(IMXRT_ENC3.offset020)
#define ENC3_LMOD			(IMXRT_ENC3.offset022)
#define ENC3_UCOMP			(IMXRT_ENC3.offset024)
#define ENC3_LCOMP			(IMXRT_ENC3.offset026)
#define IMXRT_ENC4		(*(IMXRT_REGISTER16_t *)0x403D4000)
#define ENC4_CTRL			(IMXRT_ENC4.offset000)
#define ENC4_FILT			(IMXRT_ENC4.offset002)
#define ENC4_WTR			(IMXRT_ENC4.offset004)
#define ENC4_POSD			(IMXRT_ENC4.offset006)
#define ENC4_POSDH			(IMXRT_ENC4.offset008)
#define ENC4_REV			(IMXRT_ENC4.offset00A)
#define ENC4_REVH			(IMXRT_ENC4.offset00C)
#define ENC4_UPOS			(IMXRT_ENC4.offset00E)
#define ENC4_LPOS			(IMXRT_ENC4.offset010)
#define ENC4_UPOSH			(IMXRT_ENC4.offset012)
#define ENC4_LPOSH			(IMXRT_ENC4.offset014)
#define ENC4_UINIT			(IMXRT_ENC4.offset016)
#define ENC4_LINIT			(IMXRT_ENC4.offset018)
#define ENC4_IMR			(IMXRT_ENC4.offset01A)
#define ENC4_TST			(IMXRT_ENC4.offset01C)
#define ENC4_CTRL2			(IMXRT_ENC4.offset01E)
#define ENC4_UMOD			(IMXRT_ENC4.offset020)
#define ENC4_LMOD			(IMXRT_ENC4.offset022)
#define ENC4_UCOMP			(IMXRT_ENC4.offset024)
#define ENC4_LCOMP			(IMXRT_ENC4.offset026)
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
