utahrobotics/Electrical-2019-2020/(commit log)

2019-10-01 added incomplete master schematic
    [Master Schematic.ms14]
2019-10-22 most up to date
    [Master Schematic.ms14]
2019-10-22 added snip
    [Master Schematic.ms14]
2019-12-03 updated master schematic
    [Master Schematic.ms14]
2019-12-03 oops ignore last commit lmao XD I wanna die skeet skdefs
    [Master Schematic 19-20.ms14]
2020-01-03 added powernode slave code (not tested) and pinout diagram for attiny 84
2020-01-16 added electrical solidworks layout
    [Jetson.SLDPRT, Odrive_estimate.SLDPRT, battery.SLDPRT, circuit_breaker.SLDPRT, electronics_plate.SLDPRT, kill_switch.SLDPRT, pdb_prototype.SLDPRT, power_distribution.SLDPRT]
2020-01-17 added eagle files
    [PowerNode2.brd, PowerNode2.sch]
2020-01-17 Moved power node files to KiCAD
    [PowerNode2.brd, PowerNode2.kicad_pcb]
2020-01-17 Moved power node files to KiCAD
    Also removed old capture and added .gitignore
    [PowerNode2.brd, PowerNode2.kicad_pcb, PowerNode2.sch]
2020-01-17 Fixed a library renaming issue
    [PowerNode2.sch]
2020-01-18 Added generated file for power node
2020-01-18 Added master schematic KiCAD files
    [BuckBooster.csv, Master_Schematic_19-20.kicad_pcb, Master_Schematic_19-20.sch, PDB.csv, Teensy4.csv, USBHub.csv]
2020-01-18 Added power node to master schematic
    [Master_Schematic_19-20.sch, PowerNode2.sch]
2020-01-18 Added motor controllers to master schematic
    [Master_Schematic_19-20.sch, ODrive.csv, ODrive.sch, Pololu3730.sch, PowerNode2.sch, Roboclaw.csv, Roboclaw.sch]
2020-01-18 Added agg-kicad library
2020-01-18 added more electrical components
    [Micro USB-B Female 5Pin SMD.SLDPRT, NXP iMXRT1062.SLDPRT, SKRPACE010 v4.SLDPRT, STM32F779NIHx.SLDASM, Teensy_4.0_Assembly.SLDASM, Teensy_4.0_Assembly.STEP, Teensy_4.0_PCB.SLDPRT, audio adapter.SLDPRT]
2020-01-18 Added duplicate required motor controllers to master schematic
    [Master_Schematic_19-20.sch, ODrive.sch, Pololu3730.sch, PowerNode2.sch, Roboclaw.sch]
2020-01-18 Changed schematic paper size to A2 for more space
    [Master_Schematic_19-20.sch]
2020-01-18 Updated Roboclaw
    [Master_Schematic_19-20.sch, Roboclaw.csv, Roboclaw.sch]
2020-01-18 Added brushed motors to master schematic
    [Master_Schematic_19-20.sch, Roboclaw.sch]
2020-01-18 Added stepper motors to MS and small changes to Pololu3730.sch
    [Master_Schematic_19-20.sch, Pololu3730.sch]
2020-01-21 started wiring stuff
    [053-0183R.STEP.SLDPRT, 5V _buck_booster.SLDPRT, 93655A007_MALE-FEMALE THREADED HEX STANDOFF.SLDPRT, 94868A722_18-8 SS FEM THRDED HEX STANDOFF.SLDPRT, 96741A116_METRIC PAN HEAD PHILLIPS MACHINE SCREW.SLDPRT, Assem180.SLDASM, Buck Converter Case Lower.SLDPRT, Buck Converter Case Upper.SLDPRT]
2020-01-21 added dependencies
    [Harness_5-electrical_layout.sldasm, PowerNode2 v1.step, USB_hub.SLDPRT]
2020-01-22 Added 3 more power nodes to master schematic
    [Master_Schematic_19-20.sch, ODrive.sch]
2020-01-22 Added IMU interface board files
    [IMU_Board.kicad_pcb, IMU_Board.sch]
2020-01-22 Annotated and updated schematic
    [IMU_Board.sch]
2020-01-22 Added the real IMU interface board files
    [NG_IMU_Interface_Board-2019-02-01-21-56-31.sch, NG_IMU_Interface_Board-2019-02-11-08-51-45.sch, NG_IMU_Interface_Board-2020-01-21-18-15-48.sch, NG_IMU_Interface_Board.kicad_pcb, NG_IMU_Interface_Board.sch]
2020-01-22 Cleaned up the real IMU interface board schematic
    [IMU_Board.kicad_pcb, IMU_Board.sch, NG_IMU_Interface_Board-2020-01-21-18-34-08.sch]
2020-01-22 Added emergency stop button and cleaned up IMU interface board
    [IMU_Interface_Board.sch, Master_Schematic_19-20.sch, NG_IMU_Interface_Board-2019-02-01-21-56-31.sch, NG_IMU_Interface_Board-2019-02-11-08-51-45.sch, NG_IMU_Interface_Board-2020-01-21-18-15-48.sch, NG_IMU_Interface_Board-2020-01-21-18-34-08.sch, NG_IMU_Interface_Board.kicad_pcb, NG_IMU_Interface_Board.sch]
2020-01-22 Added IMU interface board hierarchical pins and ODrive USB marker to MS
    [IMU_Interface_Board.sch, Master_Schematic_19-20.sch, ODrive.sch]
2020-01-26 Added Teensy 4 code
2020-02-04 added shift reg test
    [battery.SLDPRT]
2020-02-05 Updated to schematic version 5 (sorted components)
    [IMU_Interface_Board.sch, JetsonTX2.sch, Master_Schematic_19-20.sch, Pololu3730.sch, PowerNode2.sch, Roboclaw.sch]
2020-02-05 Added Jetson and updated drive motors (removed ODrive)
    [IMU_Interface_Board.sch, Master_Schematic_19-20.sch, ODrive.sch, Pololu3730.sch, PowerNode2.kicad_pcb, PowerNode2.sch, Roboclaw.sch]
2020-02-07 Updated ground and IMU connections and added logic converter
    [IMU_Interface_Board.sch, Master_Schematic_19-20.sch, Roboclaw.sch]
2020-02-07 IMU Interface Board updates and improvements and general cleanup
    [NG_IMU_Interface_Board-2019-02-01-21-56-31.sch, NG_IMU_Interface_Board-2019-02-11-08-51-45.sch, NG_IMU_Interface_Board-2020-01-21-18-15-48.sch, NG_IMU_Interface_Board-2020-01-21-18-34-08.sch, NG_IMU_Interface_Board.sch]
2020-02-07 Updated IMU Interface Board libraries
    [IMU_Interface_Board.sch]
2020-02-08 working on powernode V3.0
    [PowerNode2.brd, PowerNode2.sch]
2020-02-22 Added 2 new error signals to Teensy code
    [main.cpp]
2020-02-22 Fixed IMU data scaling
    [main.cpp]
2020-02-28 Removed old power node files and cleaned up master schematic
    [IMU_Interface_Board.sch, JetsonTX2.sch, Master Schematic 19-20.ms14, Master_Schematic_19-20.sch, Pololu3730.sch, PowerNode2.kicad_pcb, PowerNode2.sch, Roboclaw.sch]
2020-02-28 Imported files to KiCAD
    [PowerNode2.kicad_pcb]
2020-02-28 Remapped some components in power node v3.0
    [PowerNode2.sch]
2020-02-28 Power node 3.0 fixes, updates, and improvements
    [PowerNode2.kicad_pcb, PowerNode2.sch]
2020-02-28 Remapped PN3 footprints
    [PowerNode2.brd, PowerNode2.kicad_pcb, PowerNode2.sch]
2020-02-28 Cleanup and connected logic ground to GND in PN3 schematic
    [PowerNode2.sch]
2020-02-28 Updated PN3 schematic to newer version and added/updated CL and PD resistors
    [PowerNode2.sch]
2020-02-28 Cleaned up PN3 10k resistors
    [PowerNode2.sch]
2020-02-28 Added PN3 spice models for screw terminal and CD4511B plus generating script
    [PowerNode2.sch]
2020-02-28 PN3: added spice models for switch, LEDs, LTS-4301P and ACS712
    [PowerNode2.sch]
2020-02-28 PN3 simulation fixes and updates (added models)
    [PowerNode2.sch]
2020-02-28 PN3: added labels, input voltage, and fixes to help with simulation
    [PowerNode2.sch]
2020-02-28 PN3: updated PCB and added protective capacitors to VMEAS
    [PowerNode2.kicad_pcb, PowerNode2.sch]
2020-02-28 PN3: Improved ACS712 model, added simulation noise, and swapped IP+ and IP- order
    [PowerNode2.sch]
2020-02-28 PN3: added pull-down resistors for DP1 and QH*1
    [PowerNode2.kicad_pcb, PowerNode2.sch]
2020-02-28 PN3: updated footprints and 3D models
    [PowerNode2.kicad_pcb, PowerNode2.sch, SA39-11.step, Screw Terminal Block 5mm 4-way.step, Trimpot 3362P.step]
2020-02-28 PN3: schematic cleanup and moved logic to its own sheet
    [PowerNode2.sch]
2020-02-28 PN3: Fixed potentiometer footprint mappings
    [PowerNode2.sch]
2020-02-28 PN3: updated board and footprints
    [PowerNode2.kicad_pcb, PowerNode2.sch]
2020-02-28 PN3: added logic schematic (oops) and protective diode/capacitors for ATTiny inputs
    [Logic.sch, PowerNode2.kicad_pcb, PowerNode2.sch]
2020-02-28 PN3: removed 100uF capacitor and cleaned up some things
    [Logic.sch, PowerNode2.kicad_pcb, PowerNode2.sch]
2020-02-28 PN3: corrected connection sorting
    [Logic.sch, PowerNode2.sch]
2020-02-28 PN3: board update/corrections
    [PowerNode2.kicad_pcb]
2020-02-28 PN3: Fixes for SPICE simulation
    [Logic.sch, PowerNode2.kicad_pcb, PowerNode2.sch]
2020-02-28 PN3: added voltage follower to VMEAS and removed zener diode
    [Logic.sch, PowerNode2.kicad_pcb, PowerNode2.sch]
2020-02-28 PN3: datasheet update
    [PowerNode2.sch]
2020-02-28 PN3: added ATTiny84 spice model and BJT models file
    [Logic.sch]
2020-02-28 Removed BJTs and connected VMEAS directly
    [PowerNode2.kicad_pcb, PowerNode2.sch]
2020-02-28 PN3: small simulation improvements
    [PowerNode2.sch]
2020-02-28 PN3: changed resistors to use SMD footprints
    [Logic.sch, PowerNode2.kicad_pcb, PowerNode2.sch]
2020-02-28 PN3: removed R2 and replaced with a switched voltage divider
    [PowerNode2.kicad_pcb, PowerNode2.sch]
2020-02-28 PN3: added DPDT switch symbol and 3D switch models
    [1825232-1 v7.step, Selector Switch - SK22D07.stp]
2020-03-09 IMU_Interface signal pin change
2020-03-09 Added serial printing for debug to IMU_Interface
2020-03-11 Fixes and optimizations to IMU_Interface code
    [main.cpp]
2020-03-11 Cleaned up IMU_Interface code and added comments
2021-10-23 Fixed a possible issue causing the clock interrupt to get detached much later than intended
    [main.cpp]
2021-10-23 Simplified and fixed buffer logic
    [main.cpp]
2022-02-16 Still update timestamp when checksum fails
    [main.cpp]
2022-02-16 Added more debug signals and small fix
    [main.cpp]
2022-02-16 Added IMU initialization check and gravity offset
2022-02-17 Removed WFI to fix timing
    [main.cpp]
2022-02-18 Added new publisher for normalized acceleration and fixed bit reversal
    [main.cpp]
2022-02-21 Added Twist and Transform publishers plus fixes and improvements
    - New publishers with improved gravity offset
    - IMU orientation in its frame of reference is considered zero
    - Rotation update now correctly uses IMU frame of reference
    - Other small fixes and readability improvements
    [main.cpp]
2022-02-25 Added debug topic, improved publishing, and small fixes
    [delay.c, main.cpp, node_handle.h]
2022-02-26 Improved error checking, correct DT when data is bad, and fixed gravity initialization
    [main.cpp]
2022-03-05 Updated to build correctly with rosserial setup
    [main.cpp, node_handle.h, util.h]
2022-03-05 Added more debug printing, no more reverse trapezoid rule, and fixes
    [main.cpp, msg.h]
