utahrobotics/Electrical-2019-2020/(notices)

Notices in the files:
IMU_Interface/teensy4/keylayouts.h:
define ISO_8859_1_A9 KEY_C + SHIFT_MASK + RCTRL_MASK // 169 © COPYRIGHT SIGN
